vismay5559/stm32_zeuss/README.md

# nexus — STM32H7S3L8 real-time controller for a biped robot

Firmware for the low-level control board of a bipedal robot. The STM32 owns
everything that must happen on time; a Raspberry Pi handles planning and
perception and talks to this board over USB.

```
Raspberry Pi                      STM32H7S3L8 (this repo)
────────────                      ───────────────────────
Linux, ROS, planning,      ←→     exact 1 kHz control loop
vision, logging                   IMU, encoders, CAN-FD, contacts
(soft real-time)                  (hard real-time)

      one 422-byte struct every 1 ms — see Appli/App/link_proto.h
```

**Start here:** [What the Pi receives](#what-the-pi-receives) is the contract
between this board and the policy. [Test modes](#test-modes) is how to bring one
subsystem up at a time.

---

## Hardware

| Item | Detail |
|---|---|
| MCU | STM32H7S3L8Hx, Cortex-M7 @ 600 MHz, TFBGA225 |
| Board | NUCLEO-H7S3L8 |
| External flash | Macronix MX25UW25645G, 256 Mbit octal, on XSPI2 |
| IMU | BNO085, SHTP over **UART2** (PD5/PD6) @ 3 Mbaud, 400 Hz |
| Encoders | 4 × AS5047P on SPI1 @ 6.25 MHz, 1 kHz: one shared bus, **one chip select per sensor** |
| Actuators | **10 × ODrive S1 — 5 per bus** on 2 × FDCAN (two legs, no waist; node 5 is ankle roll — see the joint map) |
| Contacts | 2 × mechanical foot switches (one per foot, sole centre) |
| Host link | USB High Speed (480 Mbit), CDC |

### Spring encoder wiring

**Pin-by-pin wiring, with header positions, is in [docs/PINOUT.md](docs/PINOUT.md).**
Summary: four AS5047P share SPI1 (PB3 SCK, PD7 MOSI, PB4 MISO) with one chip
select each — PF1 left hip, PD15 left knee, PD14 right hip, PF5 right knee.

This replaced two daisy chains of two. In a chain the sensors form one shift
register, so the ORDER of the returned words carried meaning — the first word
came from whichever sensor sat nearest MISO. Wiring hip and knee the other way
round swapped two springs in the data, silently, and the only way to catch it
was to press a spring by hand and watch which number moved. With one select per
sensor a reply can only have come from the sensor that was selected.

If a spring is now reported as another one, a CS wire is on the wrong pin.
`s_cs[]` in `enc_as5047p.c` is the one place to change.

| `spring_angle[i]` | 0 | 1 | 2 | 3 |
|---|---|---|---|---|
| spring | left hip pitch | left knee pitch | right hip pitch | right knee pitch |

The index is fixed by which pin a sensor's CS is on, not by the order of
anything on the wire.

### Verified clock tree

HSE 24 MHz → PLL1 (M2 N100 P2) → **600 MHz** CPU, 300 MHz AHB, 150 MHz APB.

| Function | Source | Result |
|---|---|---|
| Control tick (TIM6) | 300 MHz / 300 / 1000 | 1.0000 kHz |
| Timestamp (TIM2) | 300 MHz / 300, 32-bit | 1 MHz, wraps @ 71.6 min |
| FDCAN | PLL2P = 80 MHz | 1 Mbit nominal / 2.5 Mbit data |
| SPI1 | PLL1Q = 100 MHz / 16 | 6.25 MHz, mode 1 |
| USART2 (IMU) | PCLK1 150 MHz, OVER8 | 3.000 Mbaud, 0% error |
| XSPI2 | PLL2S = 400 MHz | see *Known issues* |

---

## How it boots

The MCU has only **64 KB of internal flash** and the application is ~75 KB, so
this is a two-binary execute-in-place (XIP) design:

```
power on
   │
   ▼
Boot  (internal flash, 0x08000000)
   configures MPU, clocks, XSPI2; maps the external flash
   │  jumps to
   ▼
Appli (external flash, 0x70000000)
   the robot firmware, executed in place
```

Both are built from one CubeMX project (`nexus_first.ioc`) with separate
contexts. **They must be flashed separately** — see below.

---

## Layout

```
Appli/App/            ← the actual robot code
   app.c                1 kHz control loop, health LEDs
   health.c/.h          subsystem health + red-LED blink codes
   imu_bno085.c         BNO085 SHTP-over-UART driver
   enc_as5047p.c        AS5047P SPI encoder driver
   act_odrive.c         ODrive CANSimple, software TX queue
   contact.c            foot switch debouncing
   link_usb.c           framing/CRC for the Pi link
   link_proto.h         wire format — keep byte-identical with the Pi
   critical.h           ISR-safe copy helper

   lie_group.c/.h       SE_K(3) Lie group maths (fixed size)
   zeus_kinematics.c/.h contact-point FK + exact Jacobian from the URDF (model: GENERATED -
                        see tools/gen_kinematics.py)
   inekf.c/.h           contact-aided right-invariant EKF
   fusion.c/.h          bridges sensors <-> filter; fills the policy block
   gait_ref.c/.h        reference trajectory (GENERATED - see tools/gen_gait.py)

   safety.c/.h          arm/idle/fault state machine - the failsafe
   watchdog.c/.h        IWDG; resets the board if a tick never completes
   robot_config.c/.h    per-robot measured values (spring rates, sensor zeros)

   test_leg_can.c       NEXUS_MODE_LEG_CAN
   test_leg_torque.c    NEXUS_MODE_LEG_TORQUE
   test_imu.c           NEXUS_MODE_IMU

   README.md            plain-language guide to this folder - start here if
                        you do not program. Explains tick, interrupt, DMA,
                        checksum, arming, and the order things run in.

pi/                              the Raspberry Pi side, drop into zeus_26
   nexus_proto.py         wire format - must match link_proto.h byte for byte
   nexus_link.py          threaded 1 kHz reader
   zeus_viz.py            live Rerun view - plots, 3D, sim comparison

tools/
   hosttest/run.sh        builds and runs the host tests (see Testing below)
   check_proto.py         proves the C and Python layouts agree
   test_pi_link.py        proves the Pi side sustains 1 kHz, no hardware needed
   gen_gait.py            spreadsheet -> gait_ref.c
   plot_run.py            PuTTY log -> tracking plot + gain-tuning metrics

runs/                            archived captures, one CSV per gain setting
                                 (generated - `plot_run.py -l NAME`)

Appli/Core/, Appli/USB_DEVICE/   CubeMX-generated (edit only in USER CODE blocks)
Boot/                            bootloader project, also CubeMX-generated
Drivers/, Middlewares/           ST HAL + USB + external-memory manager (vendored)
sync_from_cubemx.sh              pull generated files back from the CubeMX folder
```

`Appli/Core/Src/main.c` only switches peripherals on and calls `app_init()` /
`app_run()`. All real work lives in `Appli/App/`.

**Adding a source file:** create it in `Appli/App/`, then add it to
`target_sources` in `Appli/CMakeLists.txt`.

---

## Building

Requires STM32CubeCLT, or STM32CubeIDE, which bundles the same tools
(`arm-none-eabi-gcc`, CMake, Ninja, STM32CubeProgrammer). On Linux with
CubeIDE they are not on `PATH`; this finds them whatever the versions:

```bash
for d in /opt/st/stm32cubeide_*/plugins/com.st.stm32cube.ide.mcu.externaltools.{gnu-tools-for-stm32,ninja,cmake,cubeprogrammer}.*/tools/bin; do PATH="$d:$PATH"; done; export PATH
```

### Choosing the mode

The mode is the `#define NEXUS_MODE` line in `Appli/App/nexus_mode.h` unless
you override it. **Look at that line before building.** Test modes are
bring-up binaries, and `NEXUS_MODE_LEG_CAN` with `LEGTEST_ENABLE_CLOSED_LOOP 1`
arms the leg's motors at boot.

**The everyday way: edit that line and rebuild.** No clean is needed -
changing the header rebuilds the Appli in the new mode:

```bash
cmake --preset Release          # once, on a fresh clone
cmake --build --preset Release  # after every edit
```

To pick the mode without editing the header instead, on a clean tree, with the
variable **exported** so both steps see it:

```bash
rm -rf build Appli/build Boot/build
export NEXUS_MODE=NEXUS_MODE_ROBOT          # or NEXUS_MODE_LEG_CAN, _IMU, _LEG_TORQUE
cmake --preset Release
cmake --build --preset Release
unset NEXUS_MODE
```

All of that is needed, and each part was found by getting it wrong:

- **Export it, do not prefix one command.** The top level builds Appli as an
  `ExternalProject`, which configures during `cmake --build`, not during
  `cmake --preset`. `NEXUS_MODE=... cmake --preset Release` sets the variable
  for a step that never reads it; the build then prints
  `Nexus mode: from Appli/App/nexus_mode.h` and uses the header.
- **Clean first.** The mode is cached in `Appli/build`, so a changed variable
  is ignored by an already-configured tree. And deleting `Appli/build` alone
  fails: the step stamps under `build/` still say Appli is configured, and the
  build tries to `cd` into the missing directory.

**Do not mix the two.** A build run with `NEXUS_MODE` in the environment
caches it in `Appli/build`, and from then on it silently overrides the header -
edits to `nexus_mode.h` do nothing until `build`, `Appli/build` and
`Boot/build` are removed.

The build prints the mode (`Nexus mode: NEXUS_MODE_ROBOT (overrides
nexus_mode.h)`). Confirm what you are about to flash:

```bash
strings Appli/build/nexus_first_Appli.elf | grep -m1 -E "APPLI: mode = |entering app_init"
#   entering app_init()     -> ROBOT
#   APPLI: mode = LEG_CAN   -> the leg test
```

`--preset Debug` is for bring-up. **Flight firmware is `--preset Release`** —
this loop has a 1 ms budget and the estimator's predict step alone is two 27x27
matrix products, so an unoptimised build is not a slower robot, it is a
different one.

Outputs, per context:

```
Boot/build/nexus_first_Boot.elf    +  .hex
Appli/build/nexus_first_Appli.elf  +  .hex
```

If the build complains about `cube-cmake` not being found, the CMake cache is
stale (it was created by CubeIDE). Wipe and reconfigure:

```bash
rm -rf build Appli/build Boot/build
cmake --preset Debug && cmake --build build/Debug
```

---

## Testing

Much of `Appli/App` is ordinary logic - bit maps, debouncing, command
validation, the Lie-group maths - and none of it needs a board. Those parts
build and run on a workstation in about a second:

```bash
tools/hosttest/run.sh
```

It exits non-zero if anything fails, so it works as a pre-commit check. What it
covers today:

| Suite | What it pins down |
| --- | --- |
| `test_contact` | switch debouncing, and that each switch owns the right bit |
| `test_safety` | the arm/idle/fault transitions and every command-rejection rule |
| `test_fusion` | the sensor-to-filter bridge: springs add to their drives, an unreadable spring is not believed, one leg's drives never move the other leg's foot, each foot switch is its own contact |
| `test_robot_config` | spring deflection, sensor-zero wrap-around, calibration flag |
| `test_watchdog` | start, refresh, and the stopped-clock case |
| `test_lie_group` | rotations stay rotations, and the Gamma coefficients against a double-precision reference |
| `test_zeus_kinematics` | contact-point positions and Jacobians from the URDF model, against Pinocchio in double precision |
| `test_health` | fault thresholds, which subsystem is blamed, latching, and the blink code |
| `test_gait_ref` | phase wrap, interpolation, the seam, and the two documented table steps |
| `test_inekf` | still, free fall, a known spin, contact correction, a refused time step, and the fast covariance update against a dense reference |
| `test_link_usb` | frame reassembly across any split, checksum rejection, and the busy-cable drop |
| `test_act_odrive` | the interpolated ramp, the speed-hint clamp, arm and stop, a blocked wire, and where a reply is filed |
| `test_enc_as5047p` | left chain then right chain in the right slots, the check digit over every bit position, a sensor's error flag and clearing its error register, and a read that never comes back |
| `check_proto.py` | that `link_proto.h` and `nexus_proto.py` agree byte for byte |

The App sources are built against a stub HAL in `tools/hosttest/stub/`, so a
change can pass every one of these and still fail to compile for the board.
That is what the firmware build in CI is for.

`CC` selects the compiler, and it is worth using:

```bash
CC=gcc   tools/hosttest/run.sh
CC=clang tools/hosttest/run.sh
```

They disagree. GCC rejects a packed-member access that clang accepts silently,
and on macOS `gcc` is Apple clang under another name - so a green local run
there says less than it appears to. CI runs both.

On a Mac, real GCC is one command away and is worth using before pushing:

```bash
docker run --rm -v "$PWD":/w -w /w -e CC=gcc gcc:14 tools/hosttest/run.sh
```

It has caught things a local run could not - a `?:` whose branches are `unsigned
int`, narrowed to a `uint8_t` on return, which GCC rejects and clang does not
mention.

Not covered yet: `imu_bno085`, which needs a stub for its UART, and `app`,
whose loop body sits inside a `for (;;)` and cannot be run one pass at a time
without restructuring it - a bigger change than a test should make on its own.

The other peripherals are stubbed in `tools/hosttest/stub/`: the HAL, USB, CAN
and SPI.

Note the host build adds `-Wconversion`, which the firmware build does not, so
a file compiled here is held to a slightly stricter standard than one that only
ever goes to the board.

`SAN=1` builds and runs the same tests with the address and undefined-behaviour
checkers:

```bash
SAN=1 CC=clang tools/hosttest/run.sh
```

Warnings catch what the compiler can see standing still; these catch what only
happens when the code runs - an index that walks off the end of a table, a
signed overflow. Compiled code on the board has neither check, so a mistake of
that kind is silent there until it corrupts the variable next door. This is how
the unbounded wire index in `act_on_rx()` was found: every test passed, and the
write past the end of `s_pos_age` was invisible until something was watching
for it.

**When a test fails, work out which of the two is wrong before changing
either.** Several of these suites failed on their first run and the code turned
out to be right - a mask that was `0xFF` where the code wanted `0x0F`, a
tolerance coarser than the effect it was meant to catch, an assertion that the
documentation was right when it was not. A test bent until it passes is worse
than no test.

**Check a mutation actually built.** Breaking a line often leaves a variable
unused, which fails under `-Werror`; a harness that counts only failed
assertions reads that as "the mutation survived".

---

## Kinematics from the URDF

The estimator needs each foot's contact point relative to the IMU, and
its Jacobian. Rather than measuring lengths by hand, the geometry comes from
the CAD:

```
Fusion 360 export ─► zeus_26_mukesh_deploy/mukesh_description/scripts/clean_urdf.py ─► mukesh.urdf
mukesh.urdf ─► tools/gen_kinematics.py ─► Appli/App/zeus_kinematics_model.h      (tables, committed)
                                       └► tools/hosttest/zeus_kinematics_ref.h   (Pinocchio's answers)
```

`zeus_kinematics.c` walks those tables on the board: forward kinematics and
the exact Jacobian for both points of a leg in a few hundred float operations,
~2 KB of flash. Nothing from Python runs on the robot. `fusion.c` calls it every
tick for both legs; how well the result estimates the robot's motion is
checked against a simulated walk (see *State estimation*).

After the model changes (new export, IMU moved, contact points moved):

```bash
python3 -m venv ~/kinvenv && ~/kinvenv/bin/pip install -r tools/requirements-kinematics.txt   # once
env -u PYTHONPATH ~/kinvenv/bin/python tools/gen_kinematics.py      # reads ../zeus_26_mukesh_deploy/.../mukesh.urdf
tools/hosttest/run.sh                                                # C against Pinocchio
```

`env -u PYTHONPATH` matters when ROS is sourced: ROS's eigenpy breaks
Pinocchio's. `--check` exits 1 if the committed files are stale;
`--urdf path` reads another model. The firmware logs which model it has as
`zeus_kin_model_sha`, the first 16 hex digits of the URDF's sha256.

Per leg, `q` is **seven** numbers for **five** driven joints: hip pitch, hip
roll, knee pitch, ankle pitch, ankle roll (all motor side), then the hip and
knee **spring deflections**. The two extra entries are not extra actuators -
hip pitch and knee pitch are series-elastic, so the drive measures one side of
the spring and an AS5047P measures how far the spring has wound up, and the
foot's position depends on both. There are no waist joints: both hips bolt
straight to the torso.

Everything is named (`ZEUS_KIN_Q_*`), so a re-export that nests the joints
differently changes the tables, not the API.

## Continuous integration

`.github/workflows/ci.yml` runs on every push to `main` and every pull request.
Three jobs, answering three different questions:

| Job | Question | What it does |
| --- | --- | --- |
| `host-tests` | Is the logic right? | `tools/hosttest/run.sh` under GCC and clang |
| `sanitizers` | Is it doing anything it should not? | the same tests with the address and undefined-behaviour checkers |
| `firmware` | Does it still build? | cross-compiles Boot and Appli, Debug and Release |

The firmware job is the one more host tests cannot replace, and it earned its
place immediately: its first run found `act_odrive.c` reading `TxErrorCnt` off
`FDCAN_ProtocolStatusTypeDef`, which has no such member. The code had been
merged without ever being compiled for the target, and the next person to try
to flash a robot would have found it instead.

Image sizes are printed to the log, so a change that quietly costs flash is
visible before a board stops fitting. The `.elf` and the `.hex` are uploaded as
artifacts on every run - **flash the `.hex`**, for the reason given under
Flashing below.

The ARM toolchain action is pinned to a commit rather than a moving tag.

---

## Flashing

Two separate commands. **The Appli needs an external loader**; the Boot does not.

```bash
# the external loader - Linux with CubeIDE
ST_LOADER=$(ls /opt/st/stm32cubeide_*/plugins/*cubeprogrammer*/tools/bin/ExternalLoader/MX25UW25645G_NUCLEO-H7S3L8.stldr)
# Windows with CubeCLT:
#   C:/ST/STM32CubeCLT_1.22.0/STM32CubeProgrammer/bin/ExternalLoader/MX25UW25645G_NUCLEO-H7S3L8.stldr

# Appli -> external flash at 0x70000000
STM32_Programmer_CLI -c port=SWD mode=UR -el "$ST_LOADER" \
  -d Appli/build/nexus_first_Appli.hex -v -rst

# Boot -> internal flash at 0x08000000
STM32_Programmer_CLI -c port=SWD mode=UR -d Boot/build/nexus_first_Boot.elf -v -rst
```

The serial console is the ST-LINK's virtual COM port, 115200 8N1 -
`/dev/ttyACM0` on Linux when it is the only one:

```bash
python3 -m serial.tools.miniterm /dev/ttyACM0 115200      # ctrl-] to quit
```

Notes:

- **Flash the Appli `.hex`, not the `.elf`.** The ELF carries two LOAD segments
  that hold no data (`0x20000000` heap/stack in DTCM, `0x24070000` non-cacheable
  buffers). STM32CubeProgrammer tries to erase at every segment address, the
  external loader only knows how to drive flash at `0x70000000`, and the whole
  download aborts with `Error: failed to download Sector[0]`. The `.hex` records
  only sections that contain data, so it programs cleanly. The Boot is internal
  flash with no external loader attached, so its ELF is fine.
- Use the loader **without** the `-XSPIM1` suffix; this board wires the flash
  to XSPI port 2.
- `mode=UR` (connect under reset) is important for an XIP project — running
  firmware can otherwise block the connection.
- Only reflash Boot when Boot changes. Day-to-day you reflash the Appli only.

---

## Test modes

The full robot loop touches every peripheral at once, which is the worst way
to bring hardware up — when nothing works you cannot tell which of six
subsystems is at fault. So the firmware has single-purpose modes, selected at
build time in `Appli/App/nexus_mode.h`:

```c
#define NEXUS_MODE  NEXUS_MODE_LEG_CAN
```

| Mode | Exercises | State |
|---|---|---|
| `NEXUS_MODE_ROBOT` | Everything — the real 1 kHz loop | builds, untested on hardware |
| `NEXUS_MODE_LEG_CAN` | **CAN-FD only.** One leg, 4 ODrives, reference gait | builds, no ODrives attached yet |
| `NEXUS_MODE_IMU` | **IMU only.** BNO085 over UART | ✅ **working on hardware** |

Change it, rebuild, reflash the Appli. `main()` dispatches on it; unused code
is simply never entered.

### `NEXUS_MODE_LEG_CAN` — single leg over CAN-FD

Talks to four ODrive S1 axes on **FDCAN1** (PB8 rx / PD1 tx) and touches
nothing else. Per joint: 1 TX (`Set_Input_Pos`) and 2 RX
(`Get_Encoder_Estimates`, `Get_Torques`), plus the ODrive heartbeat.

Configuration lives at the top of `Appli/App/test_leg_can.c`:

| Setting | Default | Notes |
|---|---|---|
| `s_node_id[]` | `{1,3,4}` | hip_pitch, knee, ankle. Must match `axis0.config.can.node_id` — see [the joint map](#the-joint-map) |
| `LEGTEST_ENABLE_CLOSED_LOOP` | **0** | **Safety.** At 0 the axes are never commanded into closed loop, so motors stay unpowered and cannot move — positions are still transmitted, so TX is fully testable |
| `LEGTEST_MOTION_GAIT` | 1 | 1 = play the reference gait, 0 = single-joint sine |
| `LEGTEST_GAIT_SPEED` | **0.25** | Fraction of real time. Start low |
| `LEGTEST_GAIT_ENTRY_MS` | 2000 | Ramp from the measured pose into the trajectory |
| `LEGTEST_USE_CAN_FD` | **0** | Classic CAN 2.0 @ 1 Mbit. Measured: this S1 sends CLASSIC frames and will not acknowledge FD ones |
| `LEGTEST_LISTEN_ONLY` | 0 | Never transmit. Use to verify reception without risking bus-off |
| `LEGTEST_USB_STREAM` | 1 | Send the run to the Pi over the USB user port at 1 kHz, as the robot's state packet. Send-only. See [Testing the USB link to the Pi](#testing-the-usb-link-to-the-pi) |
| `LEGTEST_STOP_BUTTON` | 1 | Blue USER button commands IDLE and latches. **Not an e-stop** — it rides the same CAN bus |
| `LEGTEST_GAIT_CYCLES` | 1 | Play this many cycles then hold. 0 loops forever |
| `LEGTEST_VEL_POKE` | 0 | Command a constant velocity instead of positions, to test whether the drive can produce torque at all |
| `s_zero_offset[]` | 0 | Where the gait's zero sits in the drive's coordinates. The arming log computes it for you |
| `LEGTEST_TRACE_RX` | 1 | Decode every received frame onto the console |
| `LEGTEST_TX_DIV` | 1 | 1 = 1 kHz per joint, 4 = 250 Hz per joint |

### Joints that are not on the bus

`bus_scan()` records which configured nodes answered, and a joint that did not
is skipped everywhere: no setpoints transmitted, never armed, never disarmed,
excluded from the limit check, and left out of both the run summary and the CSV
columns. Only a **completely** silent bus disables closed loop.

```
  !! node 4 (ankle) never answered - that joint is SKIPPED
     (not armed, not commanded, not captured). The rest of
     the leg still runs.
```

This is the single most bug-prone thing in the file, because a joint's presence
is assumed in seven separate places. Missing one does not produce an error —
it produces a leg that arms, holds position perfectly and never moves:

```
node 1 hip_pitch : pos= +3.5485 state=8 err=0x00000000  cmd=+3.5485 err=+0.0000
```

That was `s_entry_ok` being cleared because the absent ankle had
`n_encoder == 0`, which routes every tick into the hold-pose branch
(`target[j] = s_joint[j].pos` — command the joint to where it already is).

**A joint following a trajectory never has zero tracking error.** Sustained
`err=+0.0000` means the setpoint is the measurement, and something upstream has
decided not to run. When adding a joint, grep every `for (int j = 0; j <
JOINT_COUNT` loop and decide explicitly whether it needs `s_joint_live[j]`.

### The reference gait

`Appli/App/gait_ref.c` is **generated, not hand-written**:

```bash
python tools/gen_gait.py reference_gait_rleg_40ms_250hz.xlsx

# a workbook with one sheet per speed needs the sheet named
python tools/gen_gait_sheet_select.py final_humangait.xlsx --sheet 0.4
```

`final_humangait.xlsx` holds **two steps over 1.26 s** at three speeds, one per
sheet - `0.3`, `0.4`, `0.5` m/s - and names its columns through the shared
string table rather than inline, which the original reader could not decode.
`gen_gait_sheet_select.py` parses the workbook relationships to map sheet names
to XML parts, lists what it found, and takes `--sheet`. Run it with no `--sheet`
to see the available names.

Two steps per table rather than one stride is worth noticing: `phase` 0..1 now
covers **two** steps, so `gait_sample(phase + 0.5)` is the same leg one step
later - which is exactly what the contralateral leg needs in `build_reference()`.

200 samples, 0.8 s cycle, from a Pinocchio + CasADi trajectory optimisation at
0.40 m/s. Re-run the generator when the trajectory changes — hand-editing 200
rows of floats is how a sign error gets in and stays in.

Two conversions happen in the generator, and both are worth knowing:

- **Degrees → turns is just `/360`.** The spreadsheet is joint angles on the
  output shaft; each ODrive is already configured with its own gear ratio, so no
  reduction factor belongs in the firmware.
- **Columns come out in a fixed order that is not the node order.** The
  table runs hip_roll, hip_pitch, knee, ankle, while node 1 is hip_pitch.
  Nothing depends on the two matching: every consumer picks a column by name
  (`GAIT_COL_*`) and decides which joint it drives. The generator prints the
  resulting turn ranges so a mix-up is visible before anything moves:

```
  slot        column           degrees            turns
  hip_roll    hipRoll_r_deg    -1.67..  +6.86   -0.0047..+0.0191
  hip_pitch   hipP_r_deg      -20.53..  -6.71   -0.0570..-0.0186
  knee        knee_r_deg      +25.53.. +30.23   +0.0709..+0.0840
  ankle       ankle_r_deg      +6.03.. +21.41   +0.0167..+0.0595
```

`gait_sample(phase, out)` interpolates linearly between the 250 Hz samples and
wraps at 1.0, so the 1 kHz loop gets a smooth ramp rather than a staircase.

#### KNOWN DEFECT — the spreadsheet is not continuous

`reference_gait_rleg_40ms_250hz.xlsx` contains **two step discontinuities**, at
rows 99→100 (phase 0.5) and 199→0 (phase 1.0). Every joint jumps about 2° in a
single 4 ms sample while every other step in the trajectory is under 0.15°:

| column | median step | row 99→100 | row 199→0 |
|---|---|---|---|
| hipP_r_deg | 0.134° | **−2.013°** | **+1.961°** |
| hipRoll_r_deg | 0.059° | **+1.798°** | **+1.808°** |
| knee_r_deg | 0.034° | **+1.658°** | **−1.969°** |
| ankle_r_deg | 0.142° | −0.781° | **−1.510°** |

The two halves are not duplicates of one another (they differ by up to 13.8°),
so this is two separate 0.4 s optimiser solutions concatenated without a
periodicity constraint at either join. It is a defect in the source data, not in
the generator or the firmware.

Interpolation does **not** rescue it. It makes position continuous and leaves
velocity discontinuous: the 2° is still delivered inside one row-time, so during
those 16 ms at 0.25× the drive is commanded to move at 0.35 turn/s when the real
gait never exceeds **0.029 turn/s**. Twelve times the peak velocity of the
actual motion, twice per cycle, on every joint at once.

Consequences worth knowing before you read any tracking plot:

- Tracking error has a floor of roughly 2° at those two phases that no gain
  setting can remove. Do not tune against it.
- Velocity feedforward faithfully amplifies it — it feeds forward a velocity
  that exists only because the data is broken, as a kick at a direction
  reversal.
- Any peak-velocity figure computed by differentiating this table is dominated
  by the two joins rather than by the gait.

The real fix is upstream: re-run the optimisation with `q(T) = q(0)` and a
continuous half-step join. Blending the joins in `tools/gen_gait.py` would make
the bench test a clean test signal, but the firmware would then no longer be
playing what the optimiser produced — acceptable for actuator bring-up, not
something to carry into the robot silently.

**Two safety behaviours that are not optional:**

- The leg **ramps from its measured position** into gait sample 0 over
  `LEGTEST_GAIT_ENTRY_MS`, because the first command after arming would
  otherwise be a jump from wherever the leg is resting to phase 0.
- If **any** joint has not reported an encoder estimate over CAN, the gait does
  **not start** — the leg holds station and says so on the console. Ramping from
  an assumed zero would command a jump exactly as large as the assumption is
  wrong.

Start at `LEGTEST_GAIT_SPEED 0.25`. A wrong sign or node mapping then shows as
a slow drift you can watch and kill, rather than a snap you only hear.

Commands go out at **1 kHz to every joint** (`LEGTEST_TX_DIV 1`). Because the
hardware TX FIFO is fixed at three entries and a tick hands over four frames,
they pass through a software queue that `tx_pump()` drains as space frees.
Set `LEGTEST_TX_DIV` to 4 for one joint per tick (250 Hz each) if you want to
halve bus load during early bring-up.

When the queue is full it discards the **oldest** entry. These are position
setpoints: a stale setpoint is worthless, the newest is exactly what the
actuator should receive, and dropping the newest instead would leave the queue
full of seconds-old commands that would replay when the bus recovered.

### The run, as a sequence of phases

`LEGTEST_GAIT_RELATIVE` is **0**. A table value *is* the joint angle, measured
from the zero the drives already hold — no re-centring on whatever pose the leg
was left in, so the gait means the same thing on every run and a capture from
today is comparable with one from last week.

That only works if every run starts from the same place, so it does:

```
WAIT_ARM      countdown; nothing is commanded, axes arm when they report healthy
    |
GOTO_ZERO     3 s ramp from wherever the leg powered up, to absolute zero
    |
ENTRY         2 s ramp from zero to the trajectory's first sample
    |
GAIT          the trajectory
    |
SETTLE        1 s holding the last pose, still armed
    |
RETURN_ZERO   2 s ramp back to absolute zero
    |
DONE          disarmed
```

Every phase is a straight line in **time** between two known poses. `phase_enter()`
records the tick it began on and the pose each joint began from, once, and
`ramp_to()` interpolates from there.

None of them recompute the setpoint from the live encoder, and that is the
subtlest thing in the file. A setpoint that follows the measurement can never
build an error larger than one tick's step — and error is what a position loop
turns into torque, so the drive would trail the leg around rather than drive it,
and would track a droop under gravity straight down instead of resisting it.
Capturing the starting pose *once* also means a joint that lags does not drag
the whole ramp out behind it.

`GOTO_ZERO` gets the longest ramp because it is the only move whose distance is
not known in advance. Everything after it starts from a defined pose.

### Where zero comes from, and why it differs per joint

**Hip and knee read load-side absolute encoders and hold their own reference
frame.** Every ODrive position command is interpreted against `pos_estimate`,
which is the encoder angle plus a stored offset — `pos_vel_mapper.config.offset`
with `offset_valid`, written by `set_abs_pos()` and persisted by
`save_configuration()`. The drive applies it at power-up, so `pos_estimate` is
already correct before the firmware says anything, with no homing.

**So the firmware must not send `Set_Absolute_Position` to those two.** That
command redefines zero as wherever the leg is standing, which would silently
replace a calibrated reference with an arbitrary one. `s_define_zero` is
`{ 0, 0, 1 }`. The firmware **drives to** zero instead of declaring it — the
opposite operation, and the right one once the drive holds a real frame.

**The ankle is the exception.** Its encoder is on the motor side of a 9:1, so
±35° of joint travel is 1.75 turns of encoder and a single-turn absolute reading
maps to several possible angles. No saved offset can disambiguate that, so it
still gets `0x19` at boot — which means **the ankle must be placed by hand
before power-up, every time.** Declaring zero is not finding it: the readback
only proves the drive accepted the command, not that the joint was anywhere near
where you meant. `docs/ZEROING.md` has the full argument.

### Three guards, failing differently on purpose

A geared joint legitimately reads **different encoders for position and
commutation** — `load=5` (`SPI_ENCODER0`) and `commutation=13`
(`ONBOARD_ENCODER0`) on hip and knee. Commutation needs the electrical angle,
which only a motor-side encoder can resolve; position wants the load side,
because that is where the joint actually is. `s_cmd_scale` has to agree with the
**load** encoder, since that is what `pos_estimate` reports.

| guard | when | catches |
|---|---|---|
| `limits_ok()` | before arming | a trajectory that was never going to fit |
| command check | every tick | a setpoint outside the range, before it is sent |
| measurement check | every tick | a joint that overshot its way past the limit |

```
!! HARD LIMIT: knee position +30.412 deg exceeds +/-30.0 deg - DISARM
```

The command check alone would miss a joint that reaches a mechanical stop while
being told to do something perfectly legal. The measurement check alone would
miss a bad setpoint that has not moved the joint yet. Whichever fires says which
it was.

`s_limit_deg[]` is `{ 30, 35, 35 }` degrees, and the knee's 35 is deliberate.

**A walking knee only ever flexes.** This trajectory runs +16.34° to +28.85° and
never goes negative at all, so a symmetric ±30° spends its whole negative half
on travel the joint never uses and leaves **1.15°** on the side that matters —
less than the 3° of headroom `limits_ok()` requires, so the run is refused
before it arms:

```
!! knee: gait clears its stop by only 1.1 deg, want 3.0.
!! trajectory does not fit the joint limits - NOT MOVING
```

35° is the knee's mechanical travel from `docs/ZEROING.md` and gives 6.15° of
real margin. If 30 is a genuine hard stop on your machine rather than a round
number, put it back and reduce the trajectory amplitude instead — do not lower
`LEGTEST_LIMIT_MARGIN_DEG` to squeeze under it, which removes the warning
without removing the interference.

### The generated table is repaired, not raw

The source trajectory is **two half-strides concatenated, and they do not
meet**. Every joint jumps at once at `t = cycle/2`, sample 99 -> 100, by 1.7 to
2.0 degrees where the neighbouring steps are 0.03. There is a second, smaller
join at the wrap, 199 -> 0.

`gen_gait.py` closes both, with different methods because they are different
problems:

- **Interior joins** are found by looking at every joint at once: two or more
  stepping together at the same index means a stitch. Judging each joint alone
  gets this wrong - the ankle's jump is only 5.5x its own median step and reads
  as ordinary motion, while the knee's is 49x. Each side is then pulled halfway
  to the other, tapered to nothing over 20 samples with a smoothstep so velocity
  stays continuous at the window edges.
- **The wrap** is a constant offset over a whole cycle, so it is spread as a
  tiny slope across the entire path rather than concentrated in a few samples.

Worst step on any joint is now **3% of its span, from 44%**.

The check reports every step over 5% of each joint's own travel. It used to
compare against a fixed 0.01 turns - 3.6 degrees, most of the knee's entire
range - so a step could be nearly half that joint's motion and pass silently,
which is exactly what happened.

#### Why it mattered

The knee's whole travel is 3.7 degrees and the step was 1.65 of them - **44% of
the gait arriving in one 4 ms sample**, 412 deg/s at the output. No gain
follows that. Its captures read 230% tracking while the joint was simply ringing
after each kick, and it was untunable until the table was fixed.

<details>
<summary>The original numbers, for reference</summary>

The hip column has step changes at samples **99 -> 100** and **199 -> 0** that
are 15x to 250x the neighbouring step, at points where the joint is at an
extremum and should be nearly stationary:

```
sample  hip_turns   step      step x47 (drive turns)
   98  -0.01868  -0.00002   -0.0010
   99  -0.01870  -0.00559   -0.2628   <== STEP
  100  -0.02429  -0.00013   -0.0063
  ...
  199  -0.05703  +0.00545   +0.2560   <== STEP
    0  -0.05158  -0.00005   -0.0022
```

Both are ~0.0055 output turns (~2 deg). On the knee and ankle that is a small
bump. On the hip, whose commands are multiplied by 47 because its encoder is on
the motor side, it becomes a **0.26 turn instantaneous setpoint step** — a jerk
no drive can follow. It is reliably the largest tracking error in every capture:

```
1.580,4.65053,4.61714,0.03340
1.590,4.55174,4.56022,-0.00847   <- cmd steps -0.099
1.600,4.38751,4.47710,-0.08959   <- cmd steps -0.164, worst error of the run
```

Sample 100 is phase 0.5 and sample 200 is the seam, so a gait that looks like
two half-cycles stitched together with a small mismatch at each junction is
exactly what this pattern means.

</details>

**Regenerating used to delete code from the file it generates.** `row_vel()` and
the NULL guards in `gait_sample_vel()` had been hand-added to `gait_ref.c` and
were not in the generator's template, so a regeneration silently downgraded the
velocity feedforward from a centred difference to a one-sided one and made the
host tests segfault on the first NULL call. Both live in the template now, along
with the per-function documentation. **Do not hand-edit `gait_ref.c` or
`gait_ref.h`** - anything added there is lost the next time the generator runs.

### If the bus goes quiet

CAN is acknowledged: **every** transmitter needs at least one other node to pull
the ACK slot low. A node whose frames are not acknowledged retries forever, its
transmit error counter climbs, and at 255 the controller takes itself
**bus-off** — which stops *reception* as well. A perfectly good receive path can
therefore look completely dead a second after boot.

The report prints the state that explains it:

```
can: TEC=248 REC=0 txfifo_free=0  [BUS-OFF]
last error: ACK - we transmitted and NOBODY answered
```

**Read the two counters as a pair.** `REC=0` with a high `TEC` means their
frames reach us and ours do not reach them — the fault is on our side of the
wire, not the bus.

This is how the FD mismatch was found. Reception was flawless — 8,731 frames —
while `TEC` climbed to 248 and killed the link. The frame trace showed every
incoming frame decoding as `CLASSIC`, so the drive was never going to
acknowledge our FD frames. One `#define` fixed it.

`LEGTEST_LISTEN_ONLY 1` never transmits, so it can never reach bus-off. Use it
when you need to prove reception works for longer than the error counter allows.

### Bus load

**Measured on hardware, one node:**

```
--- t=5s  tx=1000 rx=2247 (unknown=0)  txfail=0 qdrop=0  bus~39% ---
```

That is 1000 commands out plus ~2250 telemetry frames back — **39% of a 1 Mbit
bus for a single actuator.** A classic 8-byte frame is ~108 bits, so ~3250
frames/s fills roughly a third of the wire on its own.

The consequence is worth being blunt about: **five nodes at these rates does not
fit.** Not "tight" — arithmetically impossible, several times over.

| Nodes, unchanged rates | Bus |
|---|---|
| 1 (measured) | 39% |
| 2 | 78% — already past usable |
| 5 (full robot, per bus) | ~195% — impossible |

Past roughly 50% the latency of lower-priority frames degrades badly; past 70%
it is effectively unbounded.

The drive was streaming encoder estimates at ~1120 Hz and torques at the same
rate, which is what dominates. Both are configured on the ODrive, not here:

```
axis0.config.can.encoder_msg_rate_ms   = 1     # 1 kHz - the estimator needs this
axis0.config.can.torque_msg_rate_ms    = 10    # 100 Hz is plenty for logging
axis0.config.can.heartbeat_msg_rate_ms = 100
```

### Why a frame costs what it does

A classic 8-byte frame is **121 bits**, and only 64 of them are payload:

```
SOF 1 · ID 11 · RTR/IDE/r0 3 · DLC 4 · DATA 64 · CRC 15
      · delimiters 3 · EOF 7 · IFS 3 · ~10 stuff bits
```

At 1 Mbit that is **121 µs per frame**, and 3210 frames/s fills 39% of the
second. The measurement and the arithmetic agree exactly.

**CAN FD helps, but by less than the headline ratio.** Only the data field and
CRC use the faster rate; the ID, acknowledgement and end-of-frame always run at
the nominal rate:

```
CLASSIC   |------------ 121 bits at 1 Mbit -------------|   121 us
FD+BRS    |-17 bits-||-- 92 bits at 2.5 Mbit --||-12 b-|     65 us
            1 Mbit           data + CRC          1 Mbit
```

So ~29 us of every FD frame is fixed cost. Going 2 -> 2.5 Mbit saves 9 us of
75; going on to 4 Mbit would save another 13. The data rate is not the biggest
lever available.

Per node at **500 Hz** commands, 1 kHz encoder estimates, 100 Hz heartbeat and
100 Hz torque — **1700 frames/s**:

| Config | us/frame | 1 node | **5 nodes/bus** |
|---|---|---|---|
| Classic 2.0, 1 Mbit | 121 | 21% | **103% — does not fit** |
| FD + BRS, 2 Mbit | 75 | 13% | 64% |
| **FD + BRS, 2.5 Mbit** | **65** | **11%** | **56%** |
| FD + BRS, 4 Mbit | 52 | 9% | 44% |

At 1 kHz commands it was 2200 frames/s a node and **73%** on a five-drive bus.
`ODRV_CMD_DIVIDER` in `act_odrive.h` halved the command rate to the 500 Hz the
policy trained at, which is a bigger saving than any data rate buys — and the
table shows why: even an infinitely fast data phase leaves the ~29 us of
arbitration, which is 33% of the bus at 11000 frames/s.

**Classic cannot carry four drives at these rates**, which is what made genuine
FD mode a prerequisite rather than an optimisation. 2.5 Mbit at 58% leaves
usable margin against the ~50-60% that is comfortable for a bus with
retransmissions.

Encoder estimates stay at 1 kHz: the estimator's prediction step runs on them,
and halving them to buy 14 points of bus load would cost up to 2 ms of
staleness on every joint angle the contact kinematics use. Torque at 100 Hz is
where the saving was taken instead.

The test prints a live `bus~NN%` estimate so you can watch this directly.

On the ODrive side, telemetry must be published cyclically:

```
axis0.config.can.encoder_msg_rate_ms   = 1     # 1 kHz - needed by the estimator
axis0.config.can.torque_msg_rate_ms    = 4     # 250 Hz - see bus load below
axis0.config.can.heartbeat_msg_rate_ms = 100
```

Output, once per second:

```
--- t=12s  rx=4821 (unknown=0)  txfail=0 ---
  node 1 hip_roll  : pos= +0.0031 vel=  +0.002 trq= +0.014 state=1 err=0x00000000  hb=12 enc=120 trq=120  cmd=+0.0000
  node 2 hip_pitch : ---- SILENT ----  (hb=0 enc=0 trq=0)
```

Reading it:

- **`qdrop` climbing fast means nobody is on the bus.** CAN needs another node
  to acknowledge every frame; with no transceiver or no powered ODrive nothing
  ACKs, the three hardware slots never free, and the software queue backs up.
  Watching `tx` go from ~3 to the full rate — and `qdrop` stop climbing — is
  your *first* proof of working wiring, before any telemetry appears.
- `bus~NN%` is the estimated bus load. Keep it under ~50%.
- `rx` climbing and `hb`/`enc`/`trq` rising per node = that node is healthy.
- `unknown` counts frames from node IDs you did not configure — a
  misconfigured ODrive shows up here rather than vanishing.
- `SILENT` = nothing heard from that node for 500 ms.

### Why the data phase runs at 2.5 Mbit

**1 Mbit arbitration / 2.5 Mbit data, FD with BRS, sample point 87.5% on both
phases.** `80 MHz / 32 tq = 2.5 Mbit`.

Three things drove that number.

**Classic CAN does not fit this robot.** Ten drives, five to a bus, at 1 kHz
`Set_Input_Pos` and 1 kHz encoder telemetry is **11000 frames/s per bus**. A
classic 8-byte frame is 120 us on the wire — **132% of the bus**. Even at the
500 Hz command rate the board now uses, 8500 frames/s is 102% and still does
not fit. The earlier single-leg tests fitted only because three joints is a
third of that load.

**5 Mbit failed** and the post-mortem is worth keeping. `TEC=248` climbing to
bus-off with **`REC=0`** — every fault on frames *we* sent, none on frames we
received, which rules out wiring and termination because those corrupt both
directions. At 5 Mbit a bit is 200 ns and the `TdcOffset` had been left at
20 tq = **250 ns**, so the transmitter was checking its own bits *past the end
of the bit entirely*. The TDC offset had never been adjusted when the data rate
changed. (The ISO1042's 152 ns loop delay was suspected first; it is 76% of a
200 ns bit, so it did not help, but the SSP is the simpler explanation.)

**2.5 Mbit is the fastest rate that still samples at 87.5%.** The S1 samples
there, and matching it is what fixed the error counters. The peripheral's
`DataTimeSeg1` tops out at 32 (`IS_FDCAN_DATA_TSEG1`), so:

| data rate | tq | Seg1 / Seg2 | sample point | bit | ISO1042 delay as % of bit |
|---|---|---|---|---|---|
| 2 Mbit | 40 | 32 / 7 | **82.5%** — 87.5% needs Seg1 = 34, over the limit | 500 ns | 30% |
| **2.5 Mbit** | **32** | **27 / 4** | **87.5% exactly** | 400 ns | 38% |
| 4 Mbit | 20 | 16 / 3 | 85% or 90%, cannot express 87.5% | 250 ns | 61% |
| 5 Mbit | 16 | 13 / 2 | 87.5% exactly — but see above | 200 ns | 76% |

So 2 Mbit could never reach the S1's sample point, and 4 Mbit cannot either.
2.5 Mbit is the one rate that is both fast enough and lands exactly.

Current timing at 80 MHz PLL2P, `DataPrescaler = 1`:

| phase | Seg1 | Seg2 | SJW | tq | bitrate | sample point |
|---|---|---|---|---|---|---|
| nominal | 69 | 10 | 10 | 80 | 1 Mbit | 87.5% |
| data | **27** | **4** | **4** | **32** | **2.5 Mbit** | **87.5%** |

`TdcOffset = 28 tq = 350 ns`, which is 87.5% of a 400 ns bit — the SSP at the
same point in the bit as the data sample point. **Change it with the timing;
they are one decision.** Robot mode had it at 8 tq (25%) for a long time while
the leg test used 33, and nothing caught it because robot mode had never run on
a live bus.

Resulting load: **65 us per frame, 8800 frames/s, 58% of the bus.** Note that
~29 us of every FD frame is spent at the nominal rate regardless — arbitration,
ACK, EOF, interframe space — so raising the data rate buys less than it looks.
The cheaper lever is telemetry: encoder estimates at 1 kHz are as much traffic
as every command combined, and halving them takes 58% to 44%.

Set the same rate in **every** ODrive (`odrv0.can.config.data_baud_rate`) and
confirm FD is enabled on each. A drive left at another rate, or in classic
mode, is electrically fine and completely silent — which looks exactly like a
broken wire. The S1s were measured sending classic frames and refusing to ACK
FD ones at one point; that is drive configuration, not a wiring fault.

One related trap: bus-off recovery was a no-op for a long time because
`HAL_FDCAN_Start()` only acts when the peripheral is in READY, and it is
permanently BUSY after the first start. Recovery now clears `CCCR.INIT`
directly.

### Enabling closed loop

`Set_Input_Pos` only sets the **target**. Whether the motor acts on it depends
on the axis *state*, which is separate — an axis in `IDLE` (state 1) accepts
the position and does nothing, motor unpowered. To reach
`CLOSED_LOOP_CONTROL` (state 8):

| Method | How |
|---|---|
| odrivetool — best for first bring-up | `odrv0.axis0.requested_state = AXIS_STATE_CLOSED_LOOP_CONTROL` |
| Over CAN | `Set_Axis_State` (0x007), payload uint32 `8` — what `LEGTEST_ENABLE_CLOSED_LOOP` sends |
| ODrive auto-start | `axis0.config.startup_closed_loop_control = True` |

The `state=` field in the test output shows this live, so you can confirm
before anything moves.

**Bench safety before enabling closed loop:** leg in a fixture and off the
ground, physical e-stop within reach, low current and velocity limits set in
odrivetool, and bring up one node at a time before running all four. Also
enable ODrive's own watchdog (`axis0.config.enable_watchdog`) — that is the
layer that protects the hardware if this firmware stops.

### Feedforward

`Set_Input_Pos` carries three fields, not one: position (float32 turns), then
`Vel_FF` and `Torque_FF` as int16 at 0.001 units. Without them the drive has to
*discover* every motion from tracking error, which means it is always behind by
whatever error it took to generate the torque.

`LEGTEST_GAIT_VEL_FF` is the master switch; `s_vel_ff[]` scales it **per
joint**, and it has to, because the right amount is not the same for all three.
Measured at `GAIT_SPEED 1.0` by running the identical gait with it on and off:

| joint | RMS with FF 1.0 | RMS with FF 0.0 | |
|---|---|---|---|
| hip_pitch | **0.13°** | 1.53° | needs all of it - 12x worse without |
| knee | 0.58° | **0.46°** | slightly better without |
| ankle | 1.88° | **0.26°** | **7x better without** |

The hip lags visibly without it. The ankle *overshoots by 22% and arrives
early* with it - it is being driven past its own setpoint. One global switch
cannot express that, hence the table.

What makes this worth reading twice: the firmware sends all three joints the
**same** thing - trajectory velocity, scaled by `GAIT_SPEED` and `s_cmd_scale`,
multiplied by 1000 because the drive divides by `input_vel_scale`. Same
function, same frame, same tick. So a joint that wants 0.0 while another wants
1.0 points at a difference on the DRIVE side, and `axis0.config.can.input_vel_scale`
is a per-axis setting. Working backwards from the ankle's overshoot, its applied
feedforward looks about double what was intended. **Read that parameter on each
drive before treating `s_vel_ff[2] = 0.0` as a real result** - a joint that
genuinely does not want velocity feedforward is unusual; a drive with a mis-set
scale factor is not.

This also cost four rounds of gain tuning to find. The ankle's error did not
move when `vel_gain` was cut by 70%, because **feedforward bypasses the position
loop entirely** - no gain can touch it. An error that ignores the gains is not a
gain problem, and that is the signal to stop tuning and start measuring.

`gait_sample_vel()` supplies the derivative.
`gait_sample_vel()` computes it as a central difference across neighbouring
table rows — wrapping rather than clamping at the seam — then interpolates, so
the result is continuous rather than the staircase a forward difference of the
interpolated position would give.

Two scalings are mandatory and both are easy to get wrong:

- **Multiply by `LEGTEST_GAIT_SPEED`.** The phase clock runs at that fraction of
  nominal and the velocity must agree with the position it accompanies. Unscaled
  feedforward at 0.25× asks for four times the motion the setpoint is making.
- **Zero it once the cycles are done.** Holding the final pose freezes the
  *phase*, not the table. The trajectory still has a velocity at that phase; the
  command no longer does. Sending the table's value there drives the joint off a
  stationary setpoint for as long as the test is left running.

The int16 fields saturate rather than wrap. A wrapped int16 turns "too fast
forward" into "full speed backward", which is a command to slam the joint the
wrong way at full velocity; clipping merely asks for less than the trajectory
wanted.

`LEGTEST_GAIT_TORQUE_FF` is **0 and the array stays zero**, because the
spreadsheet has no torque column — it is `time_s, hipP, hipRoll, knee, ankle`,
positions only. The parameter is plumbed so that adding real data later is a
value change rather than a protocol change. Two honest sources: re-export joint
torques from `gait_library_v1.npz` (the Pinocchio/CasADi solve necessarily
computed them, they just were not carried into the xlsx), or compute gravity
compensation on the fly from link mass and measured angle. Inventing a torque
trajectory from a position table would be a guess wearing the costume of a
measurement.

**Feedforward authority is scaled by `vel_gain`.** `Vel_FF` is added to the
velocity setpoint, which is then multiplied by `vel_gain` to become torque — so
with a small `vel_gain` the feedforward contributes almost nothing and appears
to do nothing. Tune `vel_gain` first, then judge whether feedforward helped.

### Tuning gains against captured runs

With `LEGTEST_CAPTURE 1` the board records `cmd`, `pos`, `vel` and `trq` for
joint 0 into a 2048-row RAM buffer at `CAPTURE_HZ` (100 Hz, so 20.5 s of
capacity), **only while the gait is running** so the entry ramp is excluded and
`t=0` is the first sample of real gait. Nothing is transmitted during the run.
When the gait completes it dumps the buffer over UART as CSV, once per boot.

Point PuTTY at a log file — *All session output*, **Always append** — and:

```bash
python tools/plot_run.py                    # plot the newest run
python tools/plot_run.py -l vg1.0_vi5.0     # ...and archive it under that name
python tools/plot_run.py --compare          # overlay everything archived
```

The log path defaults to `DEFAULT_LOG` at the top of the script. Label runs with
the gains that produced them; `try4` is meaningless by the next morning.

Read these two numbers, in this order:

- **`stuck mid-stroke`** — fraction of samples where the command is sweeping
  fast and the encoder is not moving. This is missing torque authority and it is
  what `vel_gain` cures. Drive it to zero *first*.
- **`overshoot`** — how far past the command the joint travels at the ends of
  the stroke. Once stiction is beaten this dominates, and it points at the
  integrator rather than at `vel_gain`.

Sticking at direction *reversals* is reported separately because some of it is
unavoidable in any geared joint, and lumping it in hides the moment the real
problem is solved. `lag` is suppressed entirely while the joint sticks
mid-stroke — a best-fit time shift against a frozen trace is meaningless, and a
confident number there sends you tuning `pos_gain` when the problem is
`vel_gain`.

**Ignore `tracking %`.** It is a peak-to-peak ratio, so a joint thrashing 300%
past the setpoint scores better than one lagging gently. It is printed only
because it appears in older logs.

The loop, one round per gain change — gains are live over USB, no reflash:

```
1. odrivetool:  set vel_gain and vel_integrator_gain, read them back
2. board:       press RESET        (leg clear, stop button in reach)
3. wait ~21 s:  3 s arm + 2 s ramp + 16 s gait, then it dumps
4. host:        python tools/plot_run.py -l vgX_viY
```

If the capture count in the first line of output has not gone up, no new run was
recorded — PuTTY was not logging, or the reset did not take. Do not archive
anything until it does. `odrv0.save_configuration()` only once you are happy;
until then a power cycle silently reverts the gains and you are tuning against a
moving baseline without knowing it.

A worked example, hip_pitch on node 3, where `pos_gain × vel_gain` is the whole
stiffness of the position loop:

| | `vel_gain` 0.167, `vi` 0.333 | `vel_gain` 0.5, `vi` 2.5 |
|---|---|---|
| stiffness | 1.99 Nm/turn | 5.95 Nm/turn |
| RMS error | 12.16° | **2.14°** |
| worst error | 20.30° | 5.01° |
| stuck mid-stroke | seizing for seconds | 0.8% |

#### Where the three joints ended up

Three joints, three different answers, at `GAIT_SPEED 1.0`:

| joint | encoder | pos / vel / vi | FF | tracking | RMS |
|---|---|---|---|---|---|
| hip_pitch | motor, 47:1 | 20 / 1.0 / 5.0 | 1.0 | 101% | **0.13°** |
| knee | **load**, 47:1 | 30 / 10 / 12 | 0.5 | 145% | 0.46° |
| ankle | motor, 9:1 | 17 / 0.3 / 1.5 | 0.0 | 101% | **0.26°** |

**Do not read that as the hip being better tuned.** It has an easier job and a
flattering measurement, and both effects are large:

- **The gearbox divides the error.** Convert each RMS back to drive turns and
  the hip is 0.017, the ankle 0.047 - the ankle's drive is 2.8x worse in its own
  units, but 14x worse at the output, because 47:1 divides its error by 47 and
  9:1 only divides by 9. Two drives of identical quality still differ by 5.2x at
  the joint, and no tuning touches that.
- **Reflected inertia scales as 1/N².** The ankle's motor feels 27x more load
  than the hip's, which lowers the mechanical resonance and caps its stable
  gains. It vibrated at `vel_gain` 1.0, where the hip is perfectly happy. The
  ankle will never take the hip's numbers.
- **The knee is measured at the load.** Its 0.46° includes every degree of
  backlash and wind-up in its gearbox. The hip's 0.13° is a motor measurement
  divided by 47, and whatever its gearbox does is invisible in it. The knee's
  number is honest; the hip's is not comparable.

#### What each failure mode looks like

Every one of these was met at least once while tuning this leg:

| symptom | cause | what to change |
|---|---|---|
| overshoot, amplitude > 100%, smooth | underdamped | raise `vel_gain` |
| achieved arrives late, amplitude ~100% | not enough bandwidth | raise `pos_gain` |
| **both**: gain > 1 with ~90° lag | driven at the closed-loop resonant peak | raise `vel_gain`; do NOT drop `pos_gain` |
| constant-amplitude ripple, audible buzz | at the stability limit | lower the gain you last raised |
| square-wave error, sign flips with direction | friction, gravity, or feedforward | `vel_integrator_gain`, or `s_vel_ff[]` |
| **error does not respond to gain changes at all** | not the loop - look at feedforward | `s_vel_ff[]` |

The last row is the one that cost the most time. Lowering `pos_gain` from 20 to
7 on the knee made tracking% *improve* from 159% to 142% while RMS got **worse**,
1.03° to 1.34°, because the joint had simply gone slow enough to stop
overshooting - it was running a quarter-second behind the trajectory.

**Judge on RMS error, not tracking%.** Tracking% is an amplitude ratio: it
punishes overshoot and rewards a joint that merely lags, and it recommended
exactly the wrong change.

At the first setting the proportional term needed 27° of error to make the
~0.15 Nm that breaks the joint loose, and the whole gait is 13.8° — so the
position loop could never move the joint at all, and every motion came from the
integrator slowly winding up at 0.64 Hz. That is what stick-slip looks like in a
log, and it is a gain being an order of magnitude too small rather than anything
mechanical.

### `NEXUS_MODE_IMU` — BNO085 over UART

Exercises **USART2 only** (PD5 tx / PD6 rx, 3 Mbaud) — no CAN, no encoders, no
USB. Working, on hardware:

```
q[w,x,y,z]=+0.4625 +0.2537 -0.1549 +0.8353 |q|=1.000  a[m/s2]= +6.438 -2.910 +7.086  w[rad/s]= -0.014 +0.031 +0.023
  >> 0 err/s   per-report Hz: rotation=105 accel=158 gyro=421
     handshake: advertisement=SEEN reset-notice=seen
```

Data lines are throttled to 5/s because a 115200 console cannot carry 400 — but
the **rate is measured over every sample**, so throttling never hides a rate
problem.

#### Wiring

**Pin-by-pin wiring is in [docs/PINOUT.md](docs/PINOUT.md).** Summary: PD5
(`USART2_TX`) to the breakout's **SCL**, PD6 (`USART2_RX`) to its **SDA**, plus
3V3 and GND. The labels are not I²C — in UART mode SCL is the sensor's receive
and SDA its transmit.

Mode straps: **PS1 → 3V3, PS0 left alone**, which selects UART-SHTP.

No reset pin needed for UART. The straps are sampled **at the sensor's reset**,
so after changing them you must fully power-cycle — `-rst` and the black button
restart the STM32 but do not drop the sensor's 3.3 V.

#### Three bugs this bring-up found

All three were in our code, not the wiring, and all three came from the CEVA
datasheet:

**1. Bytes must be 100 µs apart.** §1.2.3.1: *"Bytes sent from the host to the
BNO08X must be separated by at least 100us. Bytes sent from the BNO to the host
have no extra spacing."* We sent frames back-to-back at 3 Mbaud — 3.3 µs per
byte, **thirty times too fast** — so everything after the first byte of every
frame arrived mangled. The rule being one-directional is exactly why the
sensor's own transmissions parsed perfectly while every frame we sent came back
as an SHTP error. This one cost the most time; nothing about the symptoms
pointed at timing.

**2. Wrong acceleration report.** We asked for `0x04` Linear Acceleration, which
has **gravity removed**. The estimator propagates `v += (R·a + g)·dt` and needs
*specific force* — what an accelerometer physically reads. A stationary robot
reported `(0,0,0)` against gravity's `−9.81`, so the filter would have concluded
**free fall** and ramped velocity downward forever. Now `0x01` Calibrated
Acceleration, which includes gravity. The host tests never caught it because
they fed the filter synthetic specific force.

**3. Per-channel sequence numbers.** SHTP counts them per channel; we kept one
global counter, so the control channel opened mid-sequence.

#### Reading the output

- **`|q|` is a free correctness check.** A unit quaternion always has norm 1. If
  it is not ~1.000 the bytes are being misinterpreted — wrong Q-point,
  misaligned report, wrong report id — even when the numbers look plausible.
- **The accelerometer must show gravity.** Held flat and still it reads ~9.81 on
  one axis. Zeros mean bug 2 is back.
- **The counters separate wiring faults from protocol faults**, which otherwise
  look identical:

| Symptom | Meaning |
|---|---|
| `bytes/s = 0`, `ndtr` frozen | Nothing on the wire — TX/RX swapped, no power, no ground |
| bytes but `frames/s = 0` | Wrong baud, or the IMU is in **UART-RVC** instead of **UART-SHTP** |
| frames but only channel 0 | The sensor is *rejecting* what we send — it answers with an SHTP error list |
| `advertisement=not seen` | The sensor never finished booting. Power-cycle. |

The startup **listens for one second before transmitting anything**. Datasheet
§5.2.1 says the sensor announces itself unprompted after reset, so silence in
that window means the part is not running — a question no test that transmits
first can answer.

#### Report rates

Measured, with all three reports requested at 400 Hz:

| Report | Rate | |
|---|---|---|
| Gyro `0x02` | **421 Hz** | drives the filter's orientation |
| Accelerometer `0x01` | **158 Hz** | drives velocity — the binding constraint |
| Rotation vector `0x05` | 105 Hz | deliberately slowed to 100 Hz |

Datasheet §6.9 warns that *"all sensors cannot operate at their maximum rate
simultaneously"*, and the accelerometer is what the sensor starves. **This is
not yet resolved** — see *Known issues*. `IMU_ENABLE_QUAT 0` drops the sensor's
quaternion entirely to test whether the fusion engine is what costs the
accelerometer its budget; the Pi still gets `quat` from our own estimator, which
is fused with leg kinematics and is the better estimate anyway.

## Arming, faults and the failsafe

The firmware does not simply do as it is told. Between the Pi and the
actuators sits a small state machine (`Appli/App/safety.c`):

```
BOOT  ---- everything being watched is healthy ---->  IDLE
                                                       |  command with
                                                       |  CMD_ENABLE set
                                                       v
FAULT <--------- HEALTH_LINK or HEALTH_TIMING ------ ARMED
  |                                                    ^
  +---- faults clear ----> IDLE ---- re-arm handshake --+
```

**What the Pi has to do**

| | |
|---|---|
| Set `CMD_ENABLE` | `link.send_command(...)` does this by default. Without the flag nothing reaches the actuators. |
| Advance `seq` | Replayed or out-of-order frames are refused within a command session. A session starts at every command with `CMD_ENABLE` off, so a restarted Pi counting from 0 again is accepted after its handshake. `NexusLink` handles this. |
| Stand down cleanly | `link.stand_down()` at the end of a run, so the axes idle instead of holding torque. |
| Re-arm after a fault | A latched fault clears only after a command with `CMD_ENABLE` **off**, then one with it on. `stand_down()` then `send_command()`. |

**What the firmware does on its own**

- **Commands stop for 200 ms** → `HEALTH_LINK` → FAULT → every axis is asked to
  go `IDLE`, and the request is repeated every 100 ms while the fault stands.
  The last target is *not* held indefinitely any more.
- **A tick is missed** → `HEALTH_TIMING` → the same.
- **A command fails validation** — NaN, outside `SAFETY_POS_*_TURNS`, or a jump
  larger than `SAFETY_MAX_STEP_TURNS` — it is refused and counted. Ten in a row
  faults the link.
- **The loop stops completing cycles** → the independent watchdog resets the
  board after 100 ms. It is refreshed only by a tick that ran to completion,
  never from the idle loop.
- **A hard fault, or `Error_Handler()`** → `Set_Axis_State(IDLE)` goes out on
  both CAN buses before anything spins forever.

A watchdog reset is announced on the serial console at the next boot. Do not
ignore it: it means the loop stopped, and the board came back looking healthy.

> **Bring-up note.** `safety.c` will not arm until every subsystem in
> `HEALTH_EXPECTED_MASK` is healthy, and that defaults to the whole robot — a
> failsafe that is not watching the Pi link is not a failsafe. On a partially
> wired bench, narrow it at configure time rather than editing the header:
> `HEALTH_EXPECTED_MASK='(HEALTH_TIMING|HEALTH_IMU)' cmake --preset Debug`.
> The configure step warns whenever it is narrowed, because subsystems outside
> the mask cannot fault and the failsafe therefore cannot act on them.

---

## Testing the USB link to the Pi

### What the link is

The Nucleo has two USB ports, and they do different jobs:

| port | what it is | used for |
|---|---|---|
| **ST-LINK** | debugger | flashing, and the text console (`/dev/ttyACM0` on a laptop, 115200) |
| **USB user port** | the H7S3's USB OTG HS, embedded PHY, **480 Mbit/s** | the robot's data link to the Pi |

On the user port the board is a USB *device* and the Pi is the *host*. It shows
up as a serial port (USB CDC, `/dev/ttyACM*`, USB ID `0483:5740`) and carries
binary packets, not text: a 426-byte state packet every millisecond out, 44-byte
commands in. Plug it into any USB port on the Pi.

What sends packets depends on the mode:

| mode | packets |
|---|---|
| `NEXUS_MODE_ROBOT` | the full state, always |
| `NEXUS_MODE_LEG_CAN` | **the leg test's run** — its joints, targets, torques and drive states — with `LEGTEST_USB_STREAM 1`. Commands from the Pi are received and ignored: nothing on USB can move the leg in this mode |
| `NEXUS_MODE_IMU`, `_LEG_TORQUE` | none — the port enumerates but stays silent |

In the leg test the packet is filled by `leg_stream.c` (host-tested). The bench
leg is on FDCAN1, bus 0, so by the [joint map](#the-joint-map) its drives appear
as the **left** leg whichever physical leg it is: node 1 → `left_hip_pitch`,
node 3 → `left_knee_pitch`, node 4 → `left_ankle_pitch`. `ref_angle` is the
target the test last sent; everything the test does not have — estimator, IMU,
springs, feet — reads as absent (identity quaternions, `foot_z` NaN, fusion
INVALID), and `stream_flags` carries `NEXUS_STREAM_LEG_TEST`.

The other half of this link is the [zeus_26_mukesh_deploy](https://github.com/Maverick280306/zeus_26_mukesh_deploy)
workspace; the commands below run in a clone of it.

### Level 1 — the cable enumerates

Any mode. On the Pi (or laptop), with the user port plugged in:

```bash
lsusb | grep 0483:5740       # STMicroelectronics Virtual COM Port
lsusb -t                     # that device's line must say 480M
sudo dmesg | tail            # "new high-speed USB device" ... "cdc_acm ... ttyACMn"
```

| result | meaning |
|---|---|
| not listed | cable in the ST-LINK port, a charge-only cable, or the Appli is not running (check the console) |
| `12M` / "full-speed" | enumerated, but not at high speed: swap the cable or port. 12 Mbit/s cannot carry 1 kHz of packets |
| `480M` | the cable and the PHY are good |

### Level 2 — packets arrive intact

```bash
cd zeus_26
PYTHONPATH=zeus_link python3 -m zeus_link.link_check --joints
```

Healthy is **~1000 Hz, 0.000% lost, 0 junk B**; the second column says
`LEG TEST` or `ROBOT`. No ROS needed, and it sends nothing to the board.

| result | meaning |
|---|---|
| `no STM32 USB link found` | not enumerated — go back to level 1 |
| 0 Hz | enumerated but silent: IMU or LEG_TORQUE mode, or the Appli is stuck |
| junk bytes climbing | something else has the port — usually ModemManager on Ubuntu; install `zeus_bringup/config/99-zeus-stm32.rules` |
| lost > 0 | packets the board sent and the Pi did not read in time |

One leg-test detail: once a second the test prints its status over the ST-LINK
console, which blocks for a few tens of ms. Those ticks are not sent. `seq`
counts processed ticks, so this does not show as loss — but a plot drawn
against `seq` runs slightly short of wall-clock time.

### Level 3 — watch it live on your laptop

Rerun's viewer runs on the laptop; the Pi reads the port and streams to it over
the network. Both on the same Wi-Fi or Ethernet.

**Laptop**, once, then each time:

```bash
python3 -m venv --system-site-packages ~/rerun_venv && ~/rerun_venv/bin/pip install rerun-sdk   # once
~/rerun_venv/bin/rerun          # opens the viewer and waits
hostname -I                     # the laptop's IP
```

**Pi**, once — the same `rerun_venv` commands, and a clone of
`zeus_26_mukesh_deploy`. Then:

```bash
cd zeus_26
PYTHONPATH=zeus_rerun:zeus_link ~/rerun_venv/bin/python -m zeus_rerun.rerun_serial \
    --connect <LAPTOP_IP> --degrees
```

Start the leg test. The **Joints** tab shows each joint's actual angle against
the target, in degrees, live — the same comparison as the captured CSV plots,
without the copy and paste. The seven joints not on the bench stay at zero.
Use the same `rerun-sdk` version on both machines.

With ROS on the Pi instead, the same view comes through `/zeus/state`:

```bash
source ~/rerun_venv/bin/activate
ros2 launch zeus_bringup robot.launch.py rerun:=connect rerun_host:=<LAPTOP_IP> rerun_degrees:=true
```

**No Pi yet?** Plug the user port into the laptop and run level 2 there, then
`... rerun_serial --spawn --degrees` instead of `--connect`.

---

## What the Pi receives

One **426-byte packet every millisecond** (426 KB/s, under 1% of USB HS).
`Appli/App/link_proto.h` and `pi/nexus_proto.py` describe the same bytes;
`tools/check_proto.py` compares every field offset, both struct sizes and the
joint map, so a mismatch is caught rather than debugged.

The Pi side of this link is the [zeus_26_mukesh_deploy](https://github.com/Maverick280306/zeus_26_mukesh_deploy)
ROS 2 workspace. Its `zeus_link` package holds the CANONICAL
`nexus_proto.py` since the policy landed, and `pi/nexus_proto.py` here is
copied from it; `pi/nexus_link.py` is still ours. Both are checked
against the C header.

### The joint map

Every per-joint array in both packets — `joint_pos`, `joint_vel`, `ref_angle`,
`act_*`, and the command's `residual` — uses one index:

```
index = bus * 5 + (node - 1)          bus 0 = FDCAN1, bus 1 = FDCAN2
```

| index | bus | node | joint |
|---:|---:|---:|---|
| 0 | 0 | 1 | left_hip_pitch |
| 1 | 0 | 2 | left_hip_roll |
| 2 | 0 | 3 | left_knee_pitch |
| 3 | 0 | 4 | left_ankle_pitch |
| 4 | 0 | 5 | left_ankle_roll |
| 5 | 1 | 1 | right_hip_pitch |
| 6 | 1 | 2 | right_hip_roll |
| 7 | 1 | 3 | right_knee_pitch |
| 8 | 1 | 4 | right_ankle_pitch |
| 9 | 1 | 5 | right_ankle_roll |

The packet carries no names, so this table is the only thing labelling them.
It is defined once in C (`NEXUS_J_*` in `link_proto.h`) and once in Python
(`JOINT_NAMES` in `pi/nexus_proto.py`), and `tools/check_proto.py` fails if the
two disagree.

#### Two legs, no waist — a temporary build

The robot has **ten** actuators: these eight plus waist roll (bus 0 node 5) and
waist pitch (bus 1 node 5). This firmware brings the two legs up without them.

| | |
|---|---|
| **CAN** | four drives per bus. Node 5 is neither commanded nor expected; a frame from it is ignored and not counted as a live drive |
| **Packet** | 8 joints, protocol **v7**. The Pi must be updated together with the board — each rejects the other's version rather than misreading it |
| **Waist** | none. Both hips bolt straight to the torso in the current model, so there is no joint between the IMU and the legs and nothing for the estimator to hold at zero |
| **Gait** | every index is a leg joint now, so every joint has a reference |
| **URDF** | unchanged: the robot still has the parts. `/joint_states` on the Pi carries the two waist joints at 0 so the model stays in one piece |

Putting the waist back: `NEXUS_NUM_JOINTS` 10, `ODRV_NODES_PER_BUS` 5, the map
above back to `bus * 5`, the two `NEXUS_J_WAIST_*` indices, the waist entries in
`robot_config.c`, the version bump, and the Pi side to match. The tag
**`waist-10-actuators`** marks the last commit that had them.

### What the drive was told

`act_target[]` is the number the interpolator actually put on the wire this
tick, in radians on the output side - the reference, plus the policy's
residual, after the safety envelope and the slew limit. `ref_angle + residual`
is what the Pi **asked** for; this is what the joint **got**, and it is the only
honest thing to plot `joint_pos` against when tuning a drive. It is NaN
whenever nothing is being driven, so a plot shows a gap rather than a flat line
that reads as a command the joint is ignoring.

### Gains, from the Pi

The ODrives close their own position and velocity loops; this board only sends
targets. `g_drive_gains[]` in `robot_config.c` is what it writes to every drive
**on every arm** - not once at boot, so a drive that browned out or was swapped
comes back with the gains the robot is actually running rather than whatever is
saved in that particular drive.

The Pi can replace that table between runs with a third message type,
`nexus_gains_t` (`NEXUS_MSG_GAINS`, 106 bytes, sent by hand or by a tuning
script - never in a control loop):

- **Refused while the robot is driving.** A velocity gain changing under load is
  a step change in torque with a leg's weight behind it.
- **The board says so by NOT moving `gains_seq`** in the state packet, which
  echoes the seq of the last gains message it applied. The Pi sends, watches
  that byte, and knows.
- **Not saved in the drives.** Power-cycle the board and it goes back to
  `robot_config.c`. When a value is settled, put it there and reflash.

The Pi side is `zeus gains show / push / set` and `zeus tune` in
[zeus_26_mukesh_deploy](https://github.com/Maverick280306/zeus_26_mukesh_deploy); the metrics that say
which gain to change live in `zeus_link.tuning`.

### The policy block

Bytes 12 to 195 are **46 contiguous float32** holding exactly what the RL
observation needs, in the order it expects. The Pi slices it in place and copies
nothing:

```python
obs = np.frombuffer(raw, "<f4", count=52, offset=12)
```

| # | Field | Count | Units | Comes from |
|---|---|---|---|---|
| 0 | `pelvis_z` | 1 | m | estimator — height above stance ground |
| 1 | `quat` | 4 | w,x,y,z | estimator (observation uses x,y = indices 1,2) |
| 2 | `gyro` | 3 | rad/s, **body** | BNO085 |
| 3 | `vel_hdg` | 3 | m/s, **heading** | estimator — lateral, forward, vertical |
| 4 | `joint_pos` | 10 | rad, output side | ODrive |
| 5 | `joint_vel` | 10 | rad/s, output side | ODrive |
| 6 | `spring_angle` | 4 | rad | after-spring encoders — **deflection** |
| 7 | `ref_angle` | 10 | rad, output side | stored gait at `phase` — what `residual` adds to |
| 8 | `contact` | 2 | 0.0 / 1.0 | foot switches: left, right (one per foot) |
| 9 | `foot_z` | 2 | m, world | forward kinematics — **[0] right, [1] left** |
| 10 | `phase` | 1 | 0..1 | stride clock, free-running at 1 kHz |

**Everything is a raw SI quantity.** The STM32 applies no policy scaling — no
target-height subtraction, no `/10`, no clipping, no sin/cos, no normalisation.
All of that belongs on the Pi, so the observation transform can change without
reflashing the robot.

Four things worth understanding:

- **`spring_angle` is deflection, not a joint angle.** The encoder sits *after*
  the series spring, so it reads how far the spring has wound up. Torque is
  deflection × spring constant, computed on the Pi where the constant is tunable.
  It is a **signed** value in ±π, referenced to a mechanical zero in
  `robot_config.h` — not the raw 0..2π angle it used to be, which stepped by a
  full turn for any joint resting near the wrap point. The estimator **adds** it
  to the drive's angle for hip pitch and knee: the drive measures before the
  spring, the encoder only the spring, and the link's real angle is the sum.
- **`vel_hdg` is in the heading frame, not the world.** Forward means where the
  robot faces. Yaw is the one part of the pose the filter cannot observe, so it
  drifts — but the same drifting yaw defines both the velocity and the frame, so
  the error cancels.
- **`foot_z` is computed every tick, including during swing.** A gait policy
  cares most about the foot that is off the ground. A foot whose leg cannot be
  read is sent as **NaN** with its `fk_valid` bit clear — never as 0.0, which
  reads as "resting exactly on the ground".
- **`ref_angle` is the reference, not a command.** The stride clock runs
  whether or not the Pi talks, so the policy can see the reference before it
  sends anything. The drives only move on an accepted command
  (`ref_angle + residual`); a Pi that stops sending gets the last target held
  and, 200 ms later, a link fault that idles every axis.

### The rest of the packet

Diagnostics and raw values the policy does not need but a human debugging it
does: `imu_quat` (the sensor's own 9-axis fusion, independent of ours),
`imu_accel` / `imu_gyro`, `act_torque`, `act_error` / `act_state` / `act_flags`,
`fused_pos` and `fused_vel` (world frame, before the heading rotation), the
estimated IMU biases, `contact_ticks`, and `health` — the same bitmask the red
LED blinks.

Two more that are worth wiring into any policy loop:

| Field | Meaning |
|---|---|
| `fk_valid` | bit 0 = `foot_z[0]` (right) is a real measurement, bit 1 = `foot_z[1]` (left). An invalid entry is also sent as NaN. Use `pkt.foot_z_right` / `pkt.foot_z_left`, which return `None` rather than a number you should not trust. |
| `safety_state` | `BOOT` / `IDLE` / `ARMED` / `FAULT` — whether the board is driving the actuators, and whether it has taken them away from you. `pkt.armed` and `pkt.faulted`. |
| `stream_flags` | `STREAM_GAIT_LIVE` says `ref_angle` and `phase` are real. Check `pkt.gait_live` rather than watching `phase` for movement — a gait parked at phase 0 looks identical to one that does not exist. |

And a **diagnostics block**: `loop_us_max` (worst control cycle since the last
packet, so a live signal rather than a since-boot high-water mark), `overruns`,
`usb_dropped`, `can_dropped`, `can_bus_off` and `enc_stalls`. These used to go
only to the serial console, in a line that cost ~9.5 ms of a 1 ms loop every two
seconds — a diagnostic causing nine of the missed ticks it reported. Watch
`overruns` for *change* rather than for zero; it is cumulative.

And **`fused_valid`**, which matters more than the rest:

| Value | Meaning |
|---|---|
| `INVALID` | no contact, IMU stale, or the filter diverged |
| `CONVERGING` | running, uncertainty still large |
| `OK` | velocity uncertainty low for 500 consecutive ticks **and** the robot has been measured (`ROBOT_CONFIG_CALIBRATED`) |

**Check `fusion_usable` before using height or velocity.** The filter starts
with 30° of orientation uncertainty and 1 m/s of velocity uncertainty; for the
first ~2 seconds those numbers are meaningless. It also stays `CONVERGING`
forever while `robot_config.h` says the robot has not been measured — converged
is not the same as correct, and the covariance cannot tell the difference.

### Rates

There is one stream, not several. Every field ships in the same packet every
millisecond — but not every field is *freshly measured* every time:

| Field | Genuinely new at | Note |
|---|---|---|
| `joint_pos/vel`, `spring_angle`, `contact` | **1 kHz** | new value in every packet |
| `gyro`, `imu_accel` | ~400 Hz gyro, ~160-220 Hz accel | bytes repeat between updates; watch `imu_seq` |
| `quat` (ours), `pelvis_z`, `vel_hdg`, `foot_z` | 1 kHz corrected, IMU-rate propagated | contact update every tick, prediction only on a new IMU sample |
| `imu_quat` (sensor's) | 100 Hz | deliberately slowed, see the IMU section |

So actuator and spring-encoder data really does reach the Pi at 1 kHz. The wire
and the kernel buffer never drop it — **the only way to lose it is to read too
slowly.**

### Receiving it at 1 kHz

`pi/nexus_link.py` is the reader. A background thread drains the port so
reception stays at 1 kHz no matter what the control loop is doing; the loop
then takes the newest packet and ignores the rest.

```python
from nexus_link import NexusLink

with NexusLink('/dev/ttyACM0') as link:
    if link.wait_for_fusion(timeout=10) is None:
        raise RuntimeError('estimator never converged')

    while True:                       # policy at 250 Hz
        pkt = link.latest()           # never blocks, never stale
        if pkt is None or not pkt.fusion_usable:
            continue
        action = policy(build_obs(pkt))
        link.send_command(action_to_turns(action))
```

**A 250 Hz loop that reads one packet per step falls three packets further
behind every step, forever.** Discarding the older three is not data loss — the
newest packet is the only one that is not already out of date. Pass
`history=N` and call `drain()` if you also want every packet for logging.

`link.stats` reports `loss_rate`, `seq_gaps` and `junk_bytes`; all three should
be zero on a healthy link. Run `python pi/nexus_link.py /dev/ttyACM0` on the Pi
before wiring anything into the ROS workspace — a problem is far easier to
find there than inside a control loop.

`tools/test_pi_link.py` proves the Python side sustains 1 kHz without hardware:
it feeds `NexusLink` a synthetic 1 kHz stream through a fake port and checks
every packet arrives, in order, with no gaps. It also measures parse load, which
matters more than it looks — the original pure-Python CRC cost 55% of a desktop
core at 1 kHz and would not have kept up on a Pi at all. `crc16` now calls
`binascii.crc_hqx`, the same algorithm in C and ~300× faster (2.8% of a core);
`_crc16_slow` is kept as the reference the test checks it against.

### Layout rules

- **Every 4-byte field sits on a 4-byte boundary.** The struct is packed, so
  otherwise the M7 emits byte-wise access for every misaligned float and numpy
  cannot view the buffer in place on the Pi. Fields are grouped by size rather
  than by topic for this reason.
- **The policy block is contiguous and its offset is checked.**
  `tools/check_proto.py` fails if the block moves or gains a gap, because the
  zero-copy slice above would then read the wrong bytes silently.
- **Protocol version is 10.** v1 sent raw encoder counts; v2 added the health
  byte and alignment; v3 added the policy block and split the contacts; v4 added
  `fk_valid` and `safety_state`; v5 added the diagnostics block; v6 made the
  command a residual rather than a target; v7 dropped the two waist joints; v8
  added `act_target` and the gains message; v9 cut each foot from two switches
  to one; **v10 added the two ankle roll joints**, taking the count to ten and
  the policy block to 50 floats.
  422 → 424 → 444 → 400 → 434 → 426 → 478 bytes.
  Mismatched versions reject each other rather than silently misparsing.

## Watching it live — Rerun

`pi/zeus_viz.py` turns the 1 kHz packet stream into live plots and a 3D view.
It is a consumer of the existing link, not new plumbing.

### The one thing to understand

Rerun splits into an **SDK** and a **Viewer**, and they do not have to be on the
same machine. That split is the whole answer to "the Pi has no screen":

```
STM32 ──USB──► Raspberry Pi ──network──► your laptop
1 kHz          zeus_viz.py               Rerun Viewer
sensing        (the SDK)                 (the window)
               headless                  where you look
```

The Pi logs. The laptop looks. Neither needs the other to exist for the robot
to run — **the viewer is never in the control path.**

### Wireless

```bash
# laptop — starts an empty viewer and waits
pip install rerun-sdk
rerun

# pi — point it at the laptop's IP
python pi/zeus_viz.py /dev/ttyACM0 --connect 192.168.1.50
```

Port **9876**, plain TCP. Wi-Fi is fine: decimated to 200 Hz the stream is a few
hundred KB/s, which is nothing for 802.11n. Expect 5–50 ms of latency and some
jitter — irrelevant for watching, and the reason this is *only* for watching.

> **Never put anything that commands the robot on Wi-Fi.** The policy runs on
> the Pi over USB for a reason. A dropped viewer connection must be a blank
> screen, never a stalled leg.

### Wired

Same command — the Pi just reaches the laptop over Ethernet or a USB-Ethernet
gadget instead. Lower latency and no dropouts, worth it if you are watching
something fast. Nothing in the script changes.

### Record now, look later

```bash
# pi
python pi/zeus_viz.py /dev/ttyACM0 --save run.rrd

# laptop
scp pi@raspberrypi:run.rrd .  &&  rerun run.rrd
```

**Start here.** No network at all, and recorded sessions scrub — you can find
the 40 ms where something went wrong and step through it, which live viewing
cannot do. Most interesting failures are over before you look up.

### Laptop only, no Pi

```bash
python pi/zeus_viz.py COM7 --spawn
```

STM32 plugged straight into the laptop. **This works today with one actuator** —
you do not need the Pi to exist to develop against real data.

### What it shows

| Path | |
|---|---|
| `estimator/height`, `estimator/vel/*` | what the policy consumes |
| `joints/pos/*` vs `joints/ref/*` | commanded against measured, same plot |
| `springs/*`, `contact/*`, `feet/*_z` | leg state |
| `gait/phase` | where in the cycle |
| `imu/gyro/*`, `imu/accel/*` | raw, for cross-checking the estimator |
| `world/pelvis` | 3D pose from the fused quaternion |

Scalars are decimated to 200 Hz (`DECIMATE` in the file). Set it to 1 when
chasing impact transients; the eye cannot use 1 kHz but a plot can.

### Simulation beside reality

`log_sim()` takes joint angles from MuJoCo and logs them under `sim/…` on the
same timeline. Drop `sim/joints/3` and `joints/pos/3` into one plot and the
sim-to-real gap is right there.

**MuJoCo is not part of the robot** — it is the simulator the policy was trained
in, running on a desktop. This comparison is optional. It is also the single
most useful thing here, because a policy that works in simulation and not on
hardware shows its divergence on that plot long before the robot shows it by
falling over.

---

## State estimation

A contact-aided right-invariant EKF, ported from the Python in
`vismay5559/zeus_26` (`zeus_sensor_fusion`, the retired workspace) and
following Hartley et al. 2019.
It fuses the IMU with leg forward kinematics while feet are on the ground to
estimate body orientation, velocity, height and IMU biases.

All fusion runs **on the STM32**. The Pi receives the fused state and runs only
the RL policy.

| File | Contents |
|---|---|
| `lie_group.c` | SO(3) exponential, Gamma0-3, fixed-stride matrix helpers |
| `zeus_kinematics.c` | Contact-point position in the IMU frame + exact 3x8 Jacobian, from the URDF |
| `inekf.c` | Predict, contact update, contact add/remove |
| `fusion.c` | Sensors in, estimate out: joint angles, contacts, noise, status |

State is `X` in SE_{N+2}(3) with `R, v, p` and one world position per contact,
IMU bias `theta` in R^6, and a 27x27 right-invariant error covariance. There are
two contact points - one per foot, at the centre of each sole - and
each is added when its switch closes and removed when it opens, so a rolling
foot is planted instead of pretending the whole robot is planted.

Per leg the kinematics take six angles: that leg's four drives and the two
spring deflections, added to hip pitch and knee because the drives measure
before the spring. There are no waist joints - both hips bolt straight to the
torso, so nothing sits between the IMU and the legs. Each joint's noise is
pushed through the Jacobian into a 3x3 covariance for the contact point. A
spring encoder that is not valid, or reads beyond
`ROBOT_SPRING_MAX_DEFLECTION_RAD`, is treated as unknown (0 with a wide
variance) rather than bent into the leg.

### Deliberate differences from the Python

**Fixed-size, no allocator.** The Python reshapes `X` and `P` with numpy every
time a foot lands or lifts. Everything here is declared at its four-contact
maximum with an active flag per slot; error-state matrices keep a constant
stride so indices never move, and inactive contact blocks are zeroed so they
are inert in every product.

**`float`, not `double`.** Singles are ~2x faster on this FPU and halve memory
traffic, and covariance propagation is the hot path. Joseph-form updates plus
explicit symmetrisation every step keep it stable. `inekf_real_t` is the one
switch if that ever stops holding.

**An exact Jacobian.** The Python differentiates forward kinematics
numerically, which at float32 sits right at the resolution floor.
`zeus_kinematics.c` computes each column as `axis x (point - joint origin)`
along the chain it has already walked - exact, and no extra FK.

**Four contacts for the price of two.** Going from 21 to 27 states makes every
dense product ~2.1x dearer. Two changes pay for it without changing a single
number: prediction computes `Phi (P + Qbar dt) Phi^T` (two products, not four),
and the contact update's Joseph form is written as rank-3 corrections, since
`H` has only six non-zero columns, instead of dense `(I-KH) P (I-KH)^T`. The
host test checks the fast update against a dense one. Worst-case tick by count
of multiply-accumulates: ~67k with four contacts, against ~74k for the old
two-contact code. **Not yet measured on the board** - `loop_us_max` in the
state packet is the number to watch.

### Checked against the paper

Verified equation by equation against Hartley et al. 2019
(arXiv:1904.09251). Two defects were found and fixed that the Python has:

**`Phi(phi,phi)` must be IDENTITY** (eq 58), not `Gamma0^T`. `Gamma0^T` belongs
to the *left*-invariant `Phi^l` (eq 55), where the error lives in the body
frame. This is not cosmetic - the identity block is exactly why the
right-invariant error dynamics are independent of the state estimate, which is
the property the whole method rests on. With `Gamma0^T` there, the filter
degrades into the state-dependent linearisation the paper compares against and
beats.

**`Q_bar` must use the full adjoint** (eq 28: `Ad*Cov(w)*Ad^T`). `Ad` (eq 63)
carries `(v)_x R`, `(p)_x R` and `(d_k)_x R` in its first block column, so gyro
noise reaches velocity, position and every contact with cross-covariances
between them. A diagonal `Q_bar` drops all of it. Those terms scale with `|v|`,
`|p|`, `|d|` - negligible at the origin, growing as the robot walks away, which
is when the covariance most needs to be right.

`H` is written as `[0 0 -I I 0 0]` exactly as eq 20, with the correction `+K z`
per eq 29, so the code reads directly against the paper.

Known approximations, both as the paper allows:

- `Psi1`/`Psi2` (eq 56/57) use only the leading `(a)_x Gamma2/3(-w dt)` term
  and drop the higher-order corrections. Those vanish as `w*dt -> 0`, and at
  400 Hz `w*dt` is small.
- `Q_d ~ Phi Q_bar Phi^T dt` (eq 61) - the same approximation the paper used
  for all of its own results.

### Two bugs found in the Python during the port

**The measurement is not used in the update.** `update_contact` computes
`Xinv @ b` and never touches `B_p_BC`, so the innovation is
`R^T(d_k - p)` - the prediction alone, with the encoder measurement missing
entirely. The C version uses the right-invariant innovation
`z = R*B_p_BC + p - d_k`, which is zero exactly when the state agrees with
forward kinematics.

**`Phi` is built from the already-propagated state.** `R`, `v`, `p` are numpy
*views* into `self._X`; writing the propagated values back silently updates
them, so `state_transition_right` receives the new state and then propagates it
again internally. `Phi` linearises about the state at t_k, so the C version
keeps the pre-propagation values.

Both are worth fixing in the Python too if it stays in use.

### Verification

Checked on the host against independent references, not against the Python:

- `Gamma1` against a numerically integrated `exp(phi*s) ds` (1e-4)
- Contact-point kinematics against Pinocchio reading the same URDF (0.2 um, 48 poses)
- Free fall for 1 s gives exactly -9.81 m/s and -4.905 m
- **An injected 20 cm position error decays to 1.1 mm under contact updates** -
  this is what validates the innovation and `H` sign convention; with either
  flipped the error would diverge instead
- Covariance stays symmetric and positive on the diagonal through 200 cycles
- **The observability structure of section 5.4 is reproduced**: over 4000 steps
  roll and pitch covariance shrink ~50x while yaw, being unobservable, does not
  converge at all. This only emerges with the identity `Phi` block, so the test
  fails against the pre-correction code
- The `phi`-position cross-covariance is non-zero once the body has moved off
  the origin, which a diagonal `Q_bar` could never produce

### Against a simulated walk

Unit tests say the pieces behave; they cannot say the estimate is right,
because on the robot nobody knows the true motion. `tools/sim/` makes a walk
whose true motion is known exactly and runs the **real** `fusion.c`,
`inekf.c` and `zeus_kinematics.c` on the sensor data it produces:

```
zeus.urdf ─► gen_walk.py ─► what the IMU, drives, springs and switches would read ─► replay (fusion.c) ─► evaluate.py
                        └─► the true torso motion ──────────────────────────────────────────────────────────┘
```

The walk is kinematic, built from the URDF: the stance foot is fixed to the
world and the torso moves however the joint angles make it, so a closed
switch's contact point really is still. It has what the estimator must cope
with: heel strike and toe-off (the sole-centre switch closes only for the flat
middle of stance), spring wind-up on
the stance leg, hip-roll sway, 400 Hz IMU with noise and constant
biases, drives reporting at 500 Hz.

```bash
python3 -m venv ~/kinvenv && ~/kinvenv/bin/pip install -r tools/requirements-kinematics.txt   # once
PY=~/kin_venv/bin/python EVAL_PY=python3 env -u PYTHONPATH tools/sim/run.sh --plot   # writes tools/sim/out/estimate.png
tools/sim/run.sh --check                                                               # what CI runs
tools/sim/run.sh -- --steps 30 --seed 7 --accel-bias 0 0 0                            # after -- : gen_walk.py options
```

Results on the current URDF, 16 steps, 3.9 m, judged after 2 s:

| | error |
|---|---|
| tilt (roll/pitch) | 0.23 deg rms |
| velocity, body frame | 0.010 m/s rms, 0.034 max |
| IMU height | 10 mm rms, 12 mm drift over 3.9 m |
| foot height | 10 mm rms |
| yaw | +0.7 deg over 14.6 s (unobservable, reported only) |

Almost all of the tilt and height error is one thing: the accelerometer's
horizontal bias (0.03 and -0.02 m/s^2 in the simulation) cannot be told apart
from a tilt of 0.2 deg, so the filter never learns it - exactly as the paper's
observability analysis says. That tilt then places each new foothold slightly
high, which is the slow height drift. With the horizontal bias set to zero, the
same walk gives 0.08 deg tilt, 3 mm height rms and 0.4 mm of drift. On the robot this makes a
level-surface accelerometer calibration worth having.

`--check` fails CI beyond roughly two to three times these numbers. It was
checked by corrupting the simulated sensors: a flipped knee sign (42 cm height
error), and spring deflections dropped (11 cm) or marked invalid (13 cm), all
fail. **Losing the spring encoders costs over ten centimetres of height in four
metres** - they are not optional for the estimate.

A waist that is not bolted where the estimator thinks used to fail too, but
there is no waist to mis-model any more; that mutation went with it. It gave
0.088 m/s of velocity error against a 0.03 limit. Worth repeating on the real
robot's bracket before trusting the estimate.

Swapping the two feet does not fail: velocity error rises 50%, but the
filter's foot-slip allowance absorbs it.

What this does not test: impacts and foot slip (the walk has neither), the
real sensors' noise, anything the URDF gets wrong about the real robot, and
timing on the board. The URDF is currently the older design with hip roll as
the parent.

## Diagnostics

### Serial console

`printf` is routed to the **ST-LINK virtual COM port** in both projects.
Open it at **115200 8N1, no flow control**. Boot prints its external-memory
init trace; the Appli prints a status line every 2 seconds:

**Off by default.** Every counter it carried now ships in the state packet at
1 kHz instead. Turn it on only when there is no Pi attached — it blocks the
control loop for ~9.5 ms each time it prints:

```bash
NEXUS_LOOP_STATS=1 cmake --preset Debug
```

```
ARMED | loop max 234 us | overruns 0 | can drop 0/0 | usb drop 0 | rej 0 | health 0x00 watching 0x3F blink 0
```

| Field | Meaning |
|---|---|
| state | `BOOT` / `IDLE` / `ARMED` / `FAULT` — see the failsafe section |
| `loop max` | Longest single cycle, of a 1000 µs budget |
| `overruns` | Ticks missed because a cycle ran long. Should stay 0 |
| `can drop` | Frames dropped per bus because the bus could not keep up |
| `usb drop` | State packets skipped because the host was not draining the endpoint |
| `rej` | Commands refused by validation since boot. Non-zero means the Pi is sending something wrong |
| `health` | Bitmask of faulted subsystems — see below |
| `watching` | Which subsystems are armed (`HEALTH_EXPECTED_MASK`) |
| `blink` | What the red LED is currently blinking |

### LEDs

| LED | Meaning |
|---|---|
| **LD1 green** | 1 Hz heartbeat — the 1 kHz loop is alive and on time |
| **LD2 yellow** | Boot→Appli marker. Off = handover fine. **Stuck on = the Appli never started** |
| **LD3 red** | Blink code for the first faulted subsystem |

```
1 blink = IMU stale             4 blinks = CAN bus 2 silent
2 blinks = encoders invalid     5 blinks = Pi link stale
3 blinks = CAN bus 1 silent     6 blinks = loop overrun
```

Red also goes solid from `Error_Handler()` or a hard fault.

**"Healthy" means data is flowing, not that the peripheral initialised.** Every
peripheral initialises fine with nothing plugged in, which tells you nothing —
so an unconnected sensor is deliberately a fault. `HEALTH_EXPECTED_MASK` in
`Appli/App/health.h` gates which subsystems may complain; it defaults to the
whole robot, and red going dark is your proof each one works. During bring-up,
narrow it at configure time (see the failsafe section) rather than editing the
header — health now decides whether the robot may arm, not just which LED
blinks.

---

## Current state

| Subsystem | State |
|---|---|
| Boot chain, XIP execution | ✅ working |
| 1 kHz loop | ✅ ~230 µs of a 1000 µs budget, zero overruns |
| Health LEDs, serial console | ✅ working |
| Failsafe, watchdog, command validation | ✅ host-tested, ⚠️ never exercised on a real fault |
| **IMU (BNO085)** | ✅ **working on hardware** — quaternions, gravity, gyro |
| Pi link, protocol v5 | ✅ C/Python verified, 1 kHz proven in test |
| Peripheral fault recovery | ✅ SPI stall, CAN bus-off, IMU error paths implemented |
| Drive lifecycle (arm / clear / idle) | ✅ implemented, ⚠️ never run against real ODrives |
| State estimator | ✅ wired in, ⚠️ never run on real sensor data |
| Encoders (SPI) | ⚠️ initialises, no hardware attached |
| CAN / ODrive | ⚠️ initialises, no hardware attached |

The IMU is the first external interface actually proven end to end. Encoders and
CAN still have never moved a byte of real data.

### Known issues

Only genuinely open items live here. Bugs that were found and fixed but that
CubeMX can silently undo are listed under
[Working with CubeMX](#working-with-cubemx) instead — they are hazards, not
outstanding work.

**`report()` stalls the control loop once a second.** The 1 Hz serial report
blocks setpoint transmission for tens of milliseconds. It is directly visible in
the counters — `tx=2000` in a normal second, `tx=402` in a second that also
dumps a capture — and as position discontinuities in the CSV at exactly the
report boundaries (gait t = 1.01, 2.01, 3.01 s for a run armed at t=3 s with a
2 s entry ramp). Harmless while tuning, not acceptable once the gait matters.
Gate it off while `s_gait_running`, or move printing off the control thread.

**Error-passive wedges the TX queue.** When the drives disarm and stop ACKing,
TX fills, `txfifo_free` hits 0 and every queued frame is dropped — `qdrop`
climbing 2000/s with `tx=0 rx=0` forever. `can_busoff_poll()` only recovered
from full bus-off, and error-passive is not bus-off. It now flushes the backlog
when error-passive coincides with a full FIFO, but that is a symptom fix: the
open question is why both drives fault with `err=0x08000200` after ~54 s of
holding a static pose. Read `odrv0.axis0.disarm_reason` in odrivetool — the
ODrive error-code documentation returns HTTP 403 and the numeric codes here have
never been decoded against an authoritative source.

**Accelerometer runs at ~158 Hz, not 400.** The gyro reaches 421 Hz but the
accelerometer — which drives the estimator's velocity and height — is starved by
the sensor's own scheduling (datasheet §6.9: sensors cannot all run at maximum
simultaneously). Dropping the quaternion from 400 Hz to 100 Hz made it *worse*
(216 → 158) and cut total throughput from 972 to 684 reports/s, which rules out
simple bandwidth saturation. Untested next steps, in order: `IMU_ENABLE_QUAT 0`,
requesting 800 Hz to exploit the `≤ 2.1 × requested` rule, and the Game Rotation
Vector (`0x08`, 6-axis, much cheaper — and better on a robot full of motor
magnets). 158 Hz is usable but below where it should be.

**A latched timing fault is cleared by the re-arm handshake.** `HEALTH_TIMING`
still latches — a missed deadline matters after the tick that missed it — but it
is now latched against an *acknowledged* overrun count rather than against zero.
Comparing to zero meant one missed tick locked the robot out for the rest of the
session, which also made the `FAULT → IDLE` recovery path dead code for the most
likely fault there is. `link.stand_down()` acknowledges it.

**The failsafe has never fired on hardware.** `safety.c` and `watchdog.c` are
covered by host tests (`tools/hosttest/run.sh`), which is not the same thing as
having watched a robot go limp when the USB cable was pulled. Before anything
walks: pull the cable mid-run and confirm the axes idle; stall the loop
deliberately and confirm the board resets and says so at the next boot.

**The command envelope is a placeholder.** `SAFETY_POS_MIN/MAX_TURNS` and
`SAFETY_MAX_STEP_TURNS` in `safety.h` are loose bounds chosen to catch garbage,
not this machine's real joint travel. They need measuring on the robot — a
limit that is wrong in the loose direction only fails to stop a sick robot,
which is why they start there rather than tight.

**The robot has never been measured.** The leg geometry now comes from the
URDF - but that URDF is an older design (hip roll as the parent), and the
per-joint signs and offsets and the spring encoder zeros in
`Appli/App/robot_config.h` are all placeholders. Until the real design is
exported and those are measured, forward kinematics is wrong by however wrong
they are.

The filter no longer trusts it blindly: while `ROBOT_CONFIG_CALIBRATED` is `0`
the estimator reports `CONVERGING` forever and never `OK`, however well its
covariance settles. A converged filter built on guessed geometry is
confidently wrong, and the covariance cannot tell you that. Measure the robot,
set the flag, and `fusion_usable` starts meaning something.

**External flash runs in 1-line mode, not octal.** SFDP init fails at step 11
(re-reading the SFDP header through the freshly configured octal mode) with
`EXTMEM_DRIVER_NOR_SFDP_MEMTYPE_CHECK`. 1-line works and is the current setting
(`NEXUS_EXTMEM_LINES` in `Boot/Core/Src/extmem_manager.c`), at roughly 1/8th the
instruction-fetch bandwidth. The loop runs in ~230 µs of its 1000 µs budget
*with* the estimator, so this costs nothing measurable today. If that margin
shrinks, move the hot path into ITCM (64 KB, 0% used) before spending time on
octal mode.

**CAN bandwidth needs attention before all 10 actuators run.** At 5 nodes per
bus with commands plus two telemetry messages each at 1 kHz, the bus sits near
75% load. Raising the *nominal* bitrate helps far more than the data bitrate,
because 8-byte frames are dominated by the arbitration phase. Also verify
whether your ODrive firmware supports CAN FD at all. Deferred deliberately —
4 nodes at 45% is fine, so this only blocks the second leg.

**No watchdog on the STM32.** A deliberate choice: ODrive's own watchdog is the
hardware-protecting layer, so a stalled STM32 stops the motors without needing
one here. Revisit only if something has to fail safe that the ODrives cannot
see.

### Resolved

For reference, since these were live problems during bring-up: the MPU/DMA
cache-coherency fault, the `MX_XSPI2_Init()` bus hang, the USB voltage detector
killing Boot, the 3-deep FDCAN TX FIFO silently dropping frames to nodes 4 and
5, the `imu_service()` infinite loop, the `Q̄` stack overflow in the estimator,
the USB TX buffer being overwritten mid-transfer, the pure-Python CRC that
could not sustain 1 kHz on a Pi, and the three BNO085 protocol bugs above. Each
has a guard, a counter, or a test so it cannot come back unnoticed.

The joint map is also settled: node 1 is hip_pitch, node 2 hip_roll, and node 5
was the waist before this two-leg build dropped it (see
[the joint map](#the-joint-map)). `robot_config.c` and
`build_reference()` had node 1 as hip_roll, taken from a comment in the gait
generator; both now name their indices with `NEXUS_J_*`.

---

## Working with CubeMX

CubeMX generates into its own project folder, which is not this repo. Generate
there, then pull the generated files back:

```bash
./sync_from_cubemx.sh
git diff --stat -- . ':!Drivers' ':!Middlewares'   # review before building
```

The script never touches `Appli/App/`, and warns if MPU region 2 came back
wrong. **Always review the diff before building** — a stale CubeMX folder can
silently revert fixes.

### Two fixes CubeMX will undo

Both of these are *fixed*. Both are also things CubeMX regenerates back to a
broken state, so check them after every generation.

**MPU region 2 must cover `0x24070000`, size 8 KB.** Every DMA buffer lives in
the `noncacheable_buffer` section there. If the MPU and the linker disagree,
the CPU reads stale cache while DMA writes real RAM — intermittent corruption
that looks exactly like bad wiring. The setting lives in the **Boot** context
of the .ioc (CORTEX_M7_BOOT → MPU Region 2).

*Guard:* `check_noncacheable_region()` in `app_init()` compares the linker
symbols against the MPU base at boot and halts with the red LED on if they
disagree, so this fails loudly instead of corrupting data.

**`MX_XSPI2_Init()` must stay commented out in the Appli**
(`Appli/Core/Src/main.c`). The Appli executes *from* XSPI2, so re-initialising
it destroys the memory mapping and the next instruction fetch hangs the bus —
no LED, no serial output, nothing.

*Guard:* none possible; the hang happens before any code could report it. This
one is on you to check in the diff.
