vismay5559/stm32_zeuss/tools/model/mukesh.urdf

<?xml version='1.0' encoding='utf-8'?>
<!--
  GENERATED by zeus_description/scripts/clean_urdf.py from
  urdf/mukesh_raw.urdf + config/mukesh_model.yaml. Do not edit: change the YAML
  (or re-export from Fusion) and run the script again.
-->
<robot name="mukesh">
  <!-- base_link: the robot's own frame, X forward / Y left / Z up, origin at the hip centre (added by clean_urdf.py) -->
  <link name="base_link" />
  <joint name="base_link_to_torso" type="fixed">
    <parent link="base_link" />
    <child link="torso" />
    <origin xyz="0.00362288116 -0.0156419404 -0.554034665" rpy="0 0 -1.57079633" />
  </joint>
  <link name="right_hip_pitch_motor">
    <inertial>
      <origin xyz="0.03456904275908428 0.02978114266894922 0.06556717497572401" rpy="0.0 -0.0 0.0" />
      <mass value="1.1584184502616546" />
      <inertia ixx="0.0018491221099442567" iyy="0.0018703105932066921" izz="0.0018386490945158512" ixy="-5.68675647884861e-06" iyz="2.114961905782132e-06" ixz="-5.425847140856643e-05" />
    </inertial>
    <visual name="Hip_pitch_infill_visual">
      <origin xyz="0.024865612163892693 0.02983569577483464 0.06713311362466598" rpy="1.155257860108296e-16 1.5707963267948957 0" />
      <geometry>
        <mesh filename="package://mukesh_description/meshes/Hip_pitch_infill.stl" scale="0.001 0.001 0.001" />
      </geometry>
    </visual>
    <collision name="Hip_pitch_infill_collision">
      <origin xyz="0.024865612163892693 0.02983569577483464 0.06713311362466598" rpy="1.155257860108296e-16 1.5707963267948957 0" />
      <geometry>
        <mesh filename="package://mukesh_description/meshes/Hip_pitch_infill.stl" scale="0.001 0.001 0.001" />
      </geometry>
    </collision>
  </link>
  <link name="right_knee_motor">
    <inertial>
      <origin xyz="0.007265756282420491 0.04206408724640368 0.1897169523138838" rpy="0.0 -0.0 0.0" />
      <mass value="1.2470692147083378" />
      <inertia ixx="0.011125467561025046" iyy="0.01084197322128748" izz="0.002568892327509836" ixy="2.6742025384184727e-05" iyz="0.0008048354155085341" ixz="-0.00039115874208493784" />
    </inertial>
    <visual name="knee_infill_8Sep_visual">
      <origin xyz="-0.002558939346153304 0.03865789238452935 0.23331153221143644" rpy="-1.5707963267949814 -0.6108652381980059 -1.5707963267948477" />
      <geometry>
        <mesh filename="package://mukesh_description/meshes/knee_infill_8Sep.stl" scale="0.001 0.001 0.001" />
      </geometry>
    </visual>
    <collision name="knee_infill_8Sep_collision">
      <origin xyz="-0.002558939346153304 0.03865789238452935 0.23331153221143644" rpy="-1.5707963267949814 -0.6108652381980059 -1.5707963267948477" />
      <geometry>
        <mesh filename="package://mukesh_description/meshes/knee_infill_8Sep.stl" scale="0.001 0.001 0.001" />
      </geometry>
    </collision>
  </link>
  <link name="right_hip_roll_motor">
    <inertial>
      <origin xyz="0.06482138586327356 -0.011780153165101512 -0.10606169304811004" rpy="0.0 -0.0 7.35276942609413e-49" />
      <mass value="0.8281614956933611" />
      <inertia ixx="0.003122673808543225" iyy="0.003465679570868241" izz="0.002120963276178317" ixy="-1.0325208370429752e-06" iyz="-0.00030205417550260654" ixz="6.042069593701542e-05" />
    </inertial>
    <visual name="hip_roll_acc_visual">
      <origin xyz="0.06494193800035385 0.04079577167802923 -0.13571763699505796" rpy="-1.5707963267949148 0.5235987755983496 -3.141592653589793" />
      <geometry>
        <mesh filename="package://mukesh_description/meshes/hip_roll_acc.stl" scale="0.001 0.001 0.001" />
      </geometry>
    </visual>
    <collision name="hip_roll_acc_collision">
      <origin xyz="0.06494193800035385 0.04079577167802923 -0.13571763699505796" rpy="-1.5707963267949148 0.5235987755983496 -3.141592653589793" />
      <geometry>
        <mesh filename="package://mukesh_description/meshes/hip_roll_acc.stl" scale="0.001 0.001 0.001" />
      </geometry>
    </collision>
  </link>
  <link name="right_foot">
    <inertial>
      <origin xyz="-2.6306134834896967e-08 -0.04629841835711845 -0.05015784551242702" rpy="0.0 -0.0 0.0" />
      <mass value="0.16677878130029922" />
      <inertia ixx="0.0007474148305536906" iyy="0.0003782420633559472" izz="0.000752529026462454" ixy="1.7811377443981786e-10" iyz="-0.0001428691031430979" ixz="-6.009994520279893e-11" />
    </inertial>
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
      <mass value="0.07298374635894124" />
      <inertia ixx="0.00013960461085593678" iyy="7.041030756173641e-05" izz="7.041030756158427e-05" ixy="-2.3716922523120042e-20" iyz="-5.855857248757146e-15" ixz="1.051063086836406e-18" />
    </inertial>
    <visual name="Hip_spring_visual">
      <origin xyz="0.05684509414294223 0.0014122925637813299 -0.0010519545968968914" rpy="1.1552578601085265e-16 1.5707963267948288 0" />
      <geometry>
        <mesh filename="package://mukesh_description/meshes/Hip_spring.stl" scale="0.001 0.001 0.001" />
      </geometry>
    </visual>
    <collision name="Hip_spring_collision">
      <origin xyz="0.05684509414294223 0.0014122925637813299 -0.0010519545968968914" rpy="1.1552578601085265e-16 1.5707963267948288 0" />
      <geometry>
        <mesh filename="package://mukesh_description/meshes/Hip_spring.stl" scale="0.001 0.001 0.001" />
      </geometry>
    </collision>
  </link>
  <link name="torso">
    <inertial>
      <origin xyz="-0.016294637141238407 -0.002526305638361926 0.7282086821810438" rpy="0.0 0.0 0.0" />
      <mass value="0.36856823233604175" />
      <inertia ixx="0.0009446333384916243" iyy="0.0017613051323293882" izz="0.001897868822193257" ixy="6.945929391524481e-06" iyz="4.585092255700015e-06" ixz="-2.5454254255174016e-06" />
    </inertial>
    <visual name="Base_link_visual">
      <origin xyz="0.0 0.0 0.0" rpy="0.0 0.0 0.0" />
      <geometry>
        <mesh filename="package://mukesh_description/meshes/Base_link.stl" scale="0.001 0.001 0.001" />
      </geometry>
    </visual>
    <collision name="Base_link_collision">
      <origin xyz="0.0 0.0 0.0" rpy="0.0 0.0 0.0" />
      <geometry>
        <mesh filename="package://mukesh_description/meshes/Base_link.stl" scale="0.001 0.001 0.001" />
      </geometry>
    </collision>
  </link>
  <link name="left_hip_pitch_motor">
    <inertial>
      <origin xyz="-0.03456904307224134 0.029781143019332046 0.06556717504111503" rpy="0.0 -0.0 0.0" />
      <mass value="1.1584184380489653" />
      <inertia ixx="0.0018491220492662386" iyy="0.0018703105892194927" izz="0.0018386490927787304" ixy="5.686735131419252e-06" iyz="2.1149623058622745e-06" ixz="5.425847000586903e-05" />
    </inertial>
    <visual name="Hip_pitch_infill_left_visual">
      <origin xyz="-0.02486561109957016 0.02983569577483464 0.06713311362476666" rpy="-1.1552578596774399e-16 1.5707963267938476 0" />
      <geometry>
        <mesh filename="package://mukesh_description/meshes/Hip_pitch_infill_left.stl" scale="0.001 0.001 0.001" />
      </geometry>
    </visual>
    <collision name="Hip_pitch_infill_left_collision">
      <origin xyz="-0.02486561109957016 0.02983569577483464 0.06713311362476666" rpy="-1.1552578596774399e-16 1.5707963267938476 0" />
      <geometry>
        <mesh filename="package://mukesh_description/meshes/Hip_pitch_infill_left.stl" scale="0.001 0.001 0.001" />
      </geometry>
    </collision>
  </link>
  <link name="left_knee_motor">
    <inertial>
      <origin xyz="-0.00726575700356209 -0.04206408796699456 -0.1897169506722385" rpy="0.0 -0.0 0.0" />
      <mass value="1.2470692431152313" />
      <inertia ixx="0.011125468108875408" iyy="0.010841973804519622" izz="0.0025688923961809315" ixy="2.6742038193024002e-05" iyz="0.0008048355665126014" ixz="-0.00039115871672184416" />
    </inertial>
    <visual name="knee_infill_8Sep_left_visual">
      <origin xyz="0.0025589404108638902 -0.038657892384527826 -0.2333115322115369" rpy="1.5707963267936973 0.6108652381980002 1.5707963267942089" />
      <geometry>
        <mesh filename="package://mukesh_description/meshes/knee_infill_8Sep_left.stl" scale="0.001 0.001 0.001" />
      </geometry>
    </visual>
    <collision name="knee_infill_8Sep_left_collision">
      <origin xyz="0.0025589404108638902 -0.038657892384527826 -0.2333115322115369" rpy="1.5707963267936973 0.6108652381980002 1.5707963267942089" />
      <geometry>
        <mesh filename="package://mukesh_description/meshes/knee_infill_8Sep_left.stl" scale="0.001 0.001 0.001" />
      </geometry>
    </collision>
  </link>
  <link name="left_hip_roll_motor">
    <inertial>
      <origin xyz="-0.0648213880904676 -0.011780127187206137 -0.10606171910010424" rpy="0.0 -0.0 0.0" />
      <mass value="0.8281617978653347" />
      <inertia ixx="0.0031226754043924276" iyy="0.0034656804672661135" izz="0.0021209642679238744" ixy="1.0327057597761205e-06" iyz="-0.0003020541993746648" ixz="-6.042056948742157e-05" />
    </inertial>
    <visual name="hip_roll_acc_left_visual">
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
      </geometry>
    </collision>
  </link>
  <link name="left_knee_spring">
    <inertial>
      <origin xyz="0.0049999952136517666 4.734762265035109e-09 2.0850443860354064e-09" rpy="0.0 -0.0 0.0" />
      <mass value="0.0739166444341313" />
      <inertia ixx="0.0001396804333701259" iyy="7.045618871649121e-05" izz="7.045618872752034e-05" ixy="-5.141489989833369e-19" iyz="-2.1713283027049343e-15" ixz="-6.827157978232877e-17" />
    </inertial>
    <visual name="knee-spring_left_visual">
      <origin xyz="-0.04707326127936849 0.15460402291607622 0.22079742248506698" rpy="-1.5707963267960763 -0.6108652381979999 -1.5707963267942124" />
      <geometry>
        <mesh filename="package://mukesh_description/meshes/knee-spring_left.stl" scale="0.001 0.001 0.001" />
      </geometry>
    </visual>
    <collision name="knee-spring_left_collision">
      <origin xyz="-0.04707326127936849 0.15460402291607622 0.22079742248506698" rpy="-1.5707963267960763 -0.6108652381979999 -1.5707963267942124" />
      <geometry>
        <mesh filename="package://mukesh_description/meshes/knee-spring_left.stl" scale="0.001 0.001 0.001" />
      </geometry>
    </collision>
  </link>
  <link name="left_hip_spring">
    <inertial>
      <origin xyz="0.004977419928626956 -3.211053246077178e-09 3.527165048922143e-09" rpy="0.0 -0.0 6.333638866564571e-49" />
      <mass value="0.072983746358941" />
      <inertia ixx="0.0001396046108582301" iyy="7.04103075605915e-05" izz="7.041030756501702e-05" ixy="2.710505431216238e-20" iyz="-5.856426454897702e-15" ixz="-7.239156603638207e-17" />
    </inertial>
    <visual name="Hip_spring_left_visual">
      <origin xyz="-0.056845093078620595 0.0014122925637813299 -0.001051954596791802" rpy="-1.1552578596808004e-16 1.5707963267939147 0" />
      <geometry>
        <mesh filename="package://mukesh_description/meshes/Hip_spring_left.stl" scale="0.001 0.001 0.001" />
      </geometry>
    </visual>
    <collision name="Hip_spring_left_collision">
      <origin xyz="-0.056845093078620595 0.0014122925637813299 -0.001051954596791802" rpy="-1.1552578596808004e-16 1.5707963267939147 0" />
      <geometry>
        <mesh filename="package://mukesh_description/meshes/Hip_spring_left.stl" scale="0.001 0.001 0.001" />
      </geometry>
    </collision>
  </link>
  <joint name="right_ankle_roll" type="revolute">
    <origin xyz="-0.047275730000000016 0.045700000000000005 -0.1192521" rpy="0.0 -7.664552802699262e-31 0.0" />
    <parent link="right_ankle_roll_link" />
    <child link="right_foot" />
    <axis xyz="0 1 0" />
    <limit lower="-0.4363" upper="0.4363" effort="25" velocity="20" />
  </joint>
  <joint name="right_ankle_pitch" type="revolute">
    <origin xyz="0.11677325000000066 0.0014999999999962621 -0.20571883000000007" rpy="-1.8138268664813416e-14 -7.328966229190266e-30 -5.551115123125783e-17" />
    <parent link="right_ankle_motor" />
    <child link="right_ankle_roll_link" />
    <axis xyz="-1 0 0" />
    <limit lower="-0.7854" upper="0.7854" effort="25" velocity="20" />
  </joint>
  <joint name="right_knee_pitch" type="revolute">
    <origin xyz="-0.05519955000000001 0.03864847 0.23289448999999995" rpy="3.4203554409882275e-16 -4.7331654313260694e-30 -7.467618333433368e-60" />
    <parent link="right_knee_motor" />
    <child link="right_knee_spring" />
    <axis xyz="-1 0 0" />
    <limit lower="-0.7854" upper="0.7854" effort="25" velocity="20" />
  </joint>
  <joint name="right_knee_pitch_spring" type="revolute">
    <origin xyz="-0.01 0.0 0.0" rpy="-3.1415926535897754 -1.8986786814935056e-32 -5.551115123125783e-17" />
    <parent link="right_knee_spring" />
    <child link="right_ankle_motor" />
    <axis xyz="-1 0 0" />
    <limit lower="-0.7854" upper="0.7854" effort="25" velocity="20" />
  </joint>
  <joint name="right_hip_roll" type="revolute">
    <origin xyz="0.06494193999999098 0.040795770000000016 -0.13571763999999994" rpy="-3.141592653589793 -1.1044052673094165e-29 -2.4651903288157894e-32" />
    <parent link="right_hip_roll_motor" />
    <child link="right_knee_motor" />
    <axis xyz="0 -1 0" />
    <limit lower="-0.7854" upper="0.7854" effort="25" velocity="20" />
  </joint>
  <joint name="right_hip_pitch" type="revolute">
    <origin xyz="-0.027775000000000005 0.03018272 0.06736460000000008" rpy="3.420355440988056e-16 1.9721522630525295e-31 -2.465190328815662e-32" />
    <parent link="right_hip_pitch_motor" />
    <child link="right_hip_spring" />
    <axis xyz="-1 0 0" />
    <limit lower="-0.7854" upper="0.7854" effort="25" velocity="20" />
  </joint>
  <joint name="right_hip_pitch_spring" type="revolute">
    <origin xyz="-0.009999999999999998 0.0 0.0" rpy="3.1415926535897927 -1.2818989709841442e-29 4.382781368483947e-45" />
    <parent link="right_hip_spring" />
    <child link="right_hip_roll_motor" />
    <axis xyz="-1 0 0" />
    <limit lower="-0.7854" upper="0.7854" effort="25" velocity="20" />
  </joint>
  <joint name="torso_to_right_hip_pitch_motor" type="fixed">
    <origin xyz="0.05538966460621691 0.026559838843506576 0.6892580848195441" rpy="3.141592653589793 -1.3877787807814457e-17 5.494754727018656e-35" />
    <parent link="torso" />
    <child link="right_hip_pitch_motor" />
  </joint>
  <joint name="left_ankle_roll" type="revolute">
    <origin xyz="0.047275729999999586 -0.04569999999999998 0.1192521" rpy="-1.9428902930940195e-16 5.759229495684072e-32 -2.0194839173657902e-28" />
    <parent link="left_ankle_roll_link" />
    <child link="left_foot" />
    <axis xyz="0 -1 0" />
    <limit lower="-0.4363" upper="0.4363" effort="25" velocity="20" />
  </joint>
  <joint name="left_ankle_pitch" type="revolute">
    <origin xyz="-0.11677326000000067 0.0015000000000037251 -0.20571883" rpy="-3.141592653589775 -1.0190019061567152e-28 5.551115123125783e-17" />
    <parent link="left_ankle_motor" />
    <child link="left_ankle_roll_link" />
    <axis xyz="-1 0 0" />
    <limit lower="-0.7854" upper="0.7854" effort="25" velocity="20" />
  </joint>
  <joint name="left_knee_pitch" type="revolute">
    <origin xyz="0.055199559999999995 -0.03864847 -0.23289449" rpy="3.141592653589793 -0.0 0.0" />
    <parent link="left_knee_motor" />
    <child link="left_knee_spring" />
    <axis xyz="-1 0 0" />
    <limit lower="-0.7854" upper="0.7854" effort="25" velocity="20" />
  </joint>
  <joint name="left_knee_pitch_spring" type="revolute">
    <origin xyz="0.01 0.0 0.0" rpy="3.1415926535897754 -1.0099318265510444e-28 5.551115123125783e-17" />
    <parent link="left_knee_spring" />
    <child link="left_ankle_motor" />
    <axis xyz="-1 0 0" />
    <limit lower="-0.7854" upper="0.7854" effort="25" velocity="20" />
  </joint>
  <joint name="left_hip_roll" type="revolute">
    <origin xyz="-0.06494193999999096 0.04079576999999999 -0.13571763999999994" rpy="-1.1541736579355972e-16 -2.84525773931663e-48 -2.465190328815662e-32" />
    <parent link="left_hip_roll_motor" />
    <child link="left_knee_motor" />
    <axis xyz="0 1 0" />
    <limit lower="-0.7854" upper="0.7854" effort="25" velocity="20" />
  </joint>
  <joint name="left_hip_pitch" type="revolute">
    <origin xyz="0.027775000000000008 0.03018272 0.06736460000000008" rpy="-3.420355440988056e-16 -2.0194839173657902e-28 -2.465190328815662e-32" />
    <parent link="left_hip_pitch_motor" />
    <child link="left_hip_spring" />
    <axis xyz="-1 0 0" />
    <limit lower="-0.7854" upper="0.7854" effort="25" velocity="20" />
  </joint>
  <joint name="left_hip_pitch_spring" type="revolute">
    <origin xyz="0.01 0.0 0.0" rpy="-3.1415926535897927 2.0194839173657902e-28 6.90741614113862e-44" />
    <parent link="left_hip_spring" />
    <child link="left_hip_roll_motor" />
    <axis xyz="-1 0 0" />
    <limit lower="-0.7854" upper="0.7854" effort="25" velocity="20" />
  </joint>
  <joint name="torso_to_left_hip_pitch_motor" type="fixed">
    <origin xyz="-0.08667354539378307 0.026559838843506576 0.6892580848195441" rpy="3.141592653589793 -1.3877787807814457e-17 5.494754727018656e-35" />
    <parent link="torso" />
    <child link="left_hip_pitch_motor" />
  </joint>
  <!-- imu_link: the IMU chip, axes as mounted (added by clean_urdf.py) -->
  <link name="imu_link" />
  <joint name="torso_to_imu_link" type="fixed">
    <parent link="torso" />
    <child link="imu_link" />
    <origin xyz="-0.0156419404 -0.00342288116 0.794334665" rpy="0 0 1.57079633" />
  </joint>
  <!-- left_contact: contact switch point on the sole (added by clean_urdf.py) -->
  <link name="left_contact" />
  <joint name="left_foot_to_left_contact" type="fixed">
    <parent link="left_foot" />
    <child link="left_contact" />
    <origin xyz="-3.48500001e-06 0.0650473 0.07997576" rpy="-3.14159265 0 -1.57079633" />
  </joint>
  <!-- right_contact: contact switch point on the sole (added by clean_urdf.py) -->
  <link name="right_contact" />
  <joint name="right_foot_to_right_contact" type="fixed">
    <parent link="right_foot" />
    <child link="right_contact" />
    <origin xyz="3.48500001e-06 -0.0650473 -0.07997576" rpy="0 0 1.57079633" />
  </joint>
</robot>
