vismay5559/stm32_zeuss/tools/model/zeus.urdf

<?xml version='1.0' encoding='utf-8'?>
<!--
  GENERATED by zeus_description/scripts/clean_urdf.py from
  urdf/zeus_raw.urdf + config/zeus_model.yaml. Do not edit: change the YAML
  (or re-export from Fusion) and run the script again.
-->
<robot name="zeus">
  <!-- base_link: the robot's own frame, X forward / Y left / Z up, origin at the hip centre (added by clean_urdf.py) -->
  <link name="base_link" />
  <joint name="base_link_to_torso" type="fixed">
    <parent link="base_link" />
    <child link="torso" />
    <origin xyz="0.00361362116 -0.0168814148 -0.554005521" rpy="0 0 -1.57079633" />
  </joint>
  <link name="right_knee_bracket">
    <inertial>
      <origin xyz="-0.05256485378108973 -3.149811705671357e-06 0.06426097779759125" rpy="0.0 -0.0 0.0" />
      <mass value="0.26171359081742096" />
      <inertia ixx="0.001196914978362476" iyy="0.0017501326565231446" izz="0.0010754153665700275" ixy="-1.4104953642034843e-07" iyz="9.202998216265219e-09" ixz="8.98481223465422e-05" />
    </inertial>
    <visual name="knee_brackett_right_visual">
      <origin xyz="-0.0008604665059515782 -3.3166370208559394e-09 0.10360900149014901" rpy="3.141592653589793 1.5707963267948934 0" />
      <geometry>
        <mesh filename="package://zeus_description/meshes/knee_brackett_right.stl" scale="0.001 0.001 0.001" />
      </geometry>
    </visual>
    <collision name="knee_brackett_right_collision">
      <origin xyz="-0.0008604665059515782 -3.3166370208559394e-09 0.10360900149014901" rpy="3.141592653589793 1.5707963267948934 0" />
      <geometry>
        <mesh filename="package://zeus_description/meshes/knee_brackett_right.stl" scale="0.001 0.001 0.001" />
      </geometry>
    </collision>
  </link>
  <link name="right_hip_roll_bracket">
    <inertial>
      <origin xyz="2.1558507816106242e-05 0.05396323849478971 0.033302675126960536" rpy="0.0 -0.0 -8.75111523449223e-62" />
      <mass value="0.2593953363423353" />
      <inertia ixx="0.0012116651716644125" iyy="0.0008809578670448889" izz="0.0009830528781121337" ixy="9.149317111472296e-07" iyz="2.255914197063784e-05" ixz="4.492542478098925e-07" />
    </inertial>
    <visual name="Hip_roll_bracket_right_visual">
      <origin xyz="0.027302786834384724 0.0466578939249336 0.5925909131567779" rpy="3.141592653589793 -6.044427111606684e-16 -3.14159265358979" />
      <geometry>
        <mesh filename="package://zeus_description/meshes/Hip_roll_bracket_right.stl" scale="0.001 0.001 0.001" />
      </geometry>
    </visual>
    <collision name="Hip_roll_bracket_right_collision">
      <origin xyz="0.027302786834384724 0.0466578939249336 0.5925909131567779" rpy="3.141592653589793 -6.044427111606684e-16 -3.14159265358979" />
      <geometry>
        <mesh filename="package://zeus_description/meshes/Hip_roll_bracket_right.stl" scale="0.001 0.001 0.001" />
      </geometry>
    </collision>
  </link>
  <link name="right_hip_bracket">
    <inertial>
      <origin xyz="-0.03293981954018783 0.00015759639410574066 -0.06582626072805756" rpy="-9.62964972193618e-35 -0.0 0.0" />
      <mass value="0.21747775977773756" />
      <inertia ixx="0.0012284760846418736" iyy="0.0012369196029320957" izz="0.0005353194999079408" ixy="5.869520130103197e-08" iyz="1.4538074574437165e-06" ixz="-5.992150715590263e-05" />
    </inertial>
    <visual name="hip_pitch_bracket_right_visual">
      <origin xyz="0.08469944447019423 0.00023770291138055567 -0.1085530277016767" rpy="1.8119798119491355 -1.568486938211107 -1.8120480759686135" />
      <geometry>
        <mesh filename="package://zeus_description/meshes/hip_pitch_bracket_right.stl" scale="0.001 0.001 0.001" />
      </geometry>
    </visual>
    <collision name="hip_pitch_bracket_right_collision">
      <origin xyz="0.08469944447019423 0.00023770291138055567 -0.1085530277016767" rpy="1.8119798119491355 -1.568486938211107 -1.8120480759686135" />
      <geometry>
        <mesh filename="package://zeus_description/meshes/hip_pitch_bracket_right.stl" scale="0.001 0.001 0.001" />
      </geometry>
    </collision>
  </link>
  <link name="right_hip_pitch_motor">
    <inertial>
      <origin xyz="0.03928255350081677 0.029814265792568923 0.06585254742989022" rpy="0.0 -0.0 0.0" />
      <mass value="1.0900294146990857" />
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
      </geometry>
    </visual>
    <collision name="Hip_spring_right_collision">
      <origin xyz="-0.09253514425490007 -0.0002132616737633175 0.08496046477788007" rpy="6.764536231126105e-05 -0.0005517547585711702 0.002242508155593942" />
      <geometry>
        <mesh filename="package://zeus_description/meshes/Hip_spring_right.stl" scale="0.001 0.001 0.001" />
      </geometry>
    </collision>
  </link>
  <link name="torso">
    <inertial>
      <origin xyz="-0.01696868129587851 -0.0045012483667503985 0.7240327946635936" rpy="0.0 0.0 0.0" />
      <mass value="0.6724614837537145" />
      <inertia ixx="0.0016511459371600392" iyy="0.002998882325778899" izz="0.003363076393926532" ixy="-1.0588745331162356e-05" iyz="-2.512543084449906e-06" ixz="-5.640847953746351e-06" />
    </inertial>
    <visual name="base_link_visual">
      <origin xyz="0.0 0.0 0.0" rpy="0.0 0.0 0.0" />
      <geometry>
        <mesh filename="package://zeus_description/meshes/base_link.stl" scale="0.001 0.001 0.001" />
      </geometry>
    </visual>
    <collision name="base_link_collision">
      <origin xyz="0.0 0.0 0.0" rpy="0.0 0.0 0.0" />
      <geometry>
        <mesh filename="package://zeus_description/meshes/base_link.stl" scale="0.001 0.001 0.001" />
      </geometry>
    </collision>
  </link>
  <link name="imu_mount">
    <inertial>
      <origin xyz="0.010137012072420331 0.008916714051471306 0.0008312090498193925" rpy="0.0 -0.0 0.0" />
      <mass value="0.00700316929217391" />
      <inertia ixx="2.895397703092834e-07" iyy="3.633586524846332e-07" izz="6.497205128027939e-07" ixy="-1.4451616085406837e-10" iyz="-1.9805048758343396e-11" ixz="-1.9868633725306305e-10" />
    </inertial>
    <visual name="IMU-1_visual">
      <origin xyz="0.025308752553300857 0.3874060614453174 -0.6805675425530986" rpy="6.764536231128467e-05 -0.0005517547585709898 0.0022425081555938263" />
      <geometry>
        <mesh filename="package://zeus_description/meshes/IMU-1.stl" scale="0.001 0.001 0.001" />
      </geometry>
    </visual>
    <collision name="IMU-1_collision">
      <origin xyz="0.025308752553300857 0.3874060614453174 -0.6805675425530986" rpy="6.764536231128467e-05 -0.0005517547585709898 0.0022425081555938263" />
      <geometry>
        <mesh filename="package://zeus_description/meshes/IMU-1.stl" scale="0.001 0.001 0.001" />
      </geometry>
    </collision>
  </link>
  <joint name="right_hip_pitch" type="revolute">
    <origin xyz="-0.026670080000000002 0.03023804000000001 0.06738140999999999" rpy="5.580160412282723e-19 1.0842021724855044e-19 -1.2763065979448198e-19" />
    <parent link="right_hip_pitch_motor" />
    <child link="right_hip_spring" />
    <axis xyz="-0.999997333 0.00224250593 0.000551754731" />
    <limit lower="-0.7854" upper="0.7854" effort="25" velocity="20" />
  </joint>
  <joint name="right_hip_pitch_spring" type="revolute">
    <origin xyz="-0.01649996 3.699999999999981e-05 9.110000000021046e-06" rpy="3.141592653589793 1.5707963267948966 0" />
    <parent link="right_hip_spring" />
    <child link="right_hip_bracket" />
    <axis xyz="-0.000551754731 -0.00224250593 0.999997333" />
    <limit lower="-0.7854" upper="0.7854" effort="25" velocity="20" />
  </joint>
  <joint name="right_hip_roll" type="revolute">
    <origin xyz="-0.06254649000000008 -0.026193479999999995 -0.0201" rpy="1.9721522630525295e-31 -1.5707963267948966 0" />
    <parent link="right_hip_roll_motor" />
    <child link="right_hip_roll_bracket" />
    <axis xyz="-0.00224254359 -0.999997483 -6.7645352e-05" />
    <limit lower="-0.7854" upper="0.7854" effort="25" velocity="20" />
  </joint>
  <joint name="right_knee_pitch" type="revolute">
    <origin xyz="-0.05464062 -9.409999999999974e-06 0.060582960000000026" rpy="-2.4805977683707598e-31 -6.401791135143172e-31 -1.9311058811127647e-31" />
    <parent link="right_knee_motor" />
    <child link="right_knee_spring" />
    <axis xyz="-0.999997333 0.00224250593 0.000551754731" />
    <limit lower="-0.7854" upper="0.7854" effort="25" velocity="20" />
  </joint>
  <joint name="right_knee_pitch_spring" type="revolute">
    <origin xyz="-0.014999999999999998 0.0 0.0" rpy="1.4791141972893971e-31 1.5707963267948966 0" />
    <parent link="right_knee_spring" />
    <child link="right_knee_bracket" />
    <axis xyz="-0.000551754731 0.00224250593 -0.999997333" />
    <limit lower="-0.7854" upper="0.7854" effort="25" velocity="20" />
  </joint>
  <joint name="right_ankle_pitch" type="revolute">
    <origin xyz="0.0385 0.0 0.048" rpy="-3.141592653589793 -4.690812175909376e-31 8.154403576970184e-32" />
    <parent link="right_ankle_motor" />
    <child link="right_foot" />
    <axis xyz="-0.999997333 -0.00224250593 -0.000551754731" />
    <limit lower="-0.7854" upper="0.7854" effort="25" velocity="20" />
  </joint>
  <joint name="left_hip_pitch" type="revolute">
    <origin xyz="0.026879780000000013 0.030117960000000013 0.06735187000000004" rpy="-3.141592653589793 -0.0 -1.1407813263841318e-19" />
    <parent link="left_hip_pitch_motor" />
    <child link="left_hip_spring" />
    <axis xyz="-0.999997333 -0.00224250593 -0.000551754731" />
    <limit lower="-0.7854" upper="0.7854" effort="25" velocity="20" />
  </joint>
  <joint name="left_hip_pitch_spring" type="revolute">
    <origin xyz="0.016499949999999996 3.7000000000000364e-05 9.110000000021046e-06" rpy="-3.141592653589793 -1.5707963267948966 0" />
    <parent link="left_hip_spring" />
    <child link="left_hip_bracket" />
    <axis xyz="-0.000551754731 0.00224250593 -0.999997333" />
    <limit lower="-0.7854" upper="0.7854" effort="25" velocity="20" />
  </joint>
  <joint name="left_hip_roll" type="revolute">
    <origin xyz="-0.06300986000000008 0.02640298 -0.020051319999999997" rpy="1.2493735972000932e-19 1.5707963267948966 0" />
    <parent link="left_hip_roll_motor" />
    <child link="left_hip_roll_bracket" />
    <axis xyz="-0.00224254359 0.999997483 6.7645352e-05" />
    <limit lower="-0.7854" upper="0.7854" effort="25" velocity="20" />
  </joint>
  <joint name="left_knee_pitch" type="revolute">
    <origin xyz="0.05470685000000112 -0.00025463000000113504 0.06052262000000003" rpy="-3.1415926535897745 -2.0866038768906402e-30 1.112927950723139e-16" />
    <parent link="left_knee_motor" />
    <child link="left_knee_spring" />
    <axis xyz="-0.999997333 -0.00224250593 -0.000551754731" />
    <limit lower="-0.7854" upper="0.7854" effort="25" velocity="20" />
  </joint>
  <joint name="left_knee_pitch_spring" type="revolute">
    <origin xyz="0.014999840000000014 6.727000000000206e-05 1.6549999999959653e-05" rpy="-3.141592653589793 -1.5707963267948966 0" />
    <parent link="left_knee_spring" />
    <child link="left_knee_bracket" />
    <axis xyz="-0.000551754731 0.00224250593 -0.999997333" />
    <limit lower="-0.7854" upper="0.7854" effort="25" velocity="20" />
  </joint>
  <joint name="left_ankle_pitch" type="revolute">
    <origin xyz="-0.038446619999999994 0.0001725500000000002 0.04804246" rpy="-2.1599340154984659e-19 -2.2171418266626333e-19 -2.130031436354674e-19" />
    <parent link="left_ankle_motor" />
    <child link="left_foot" />
    <axis xyz="-0.999997333 0.00224250593 0.000551754731" />
    <limit lower="-0.7854" upper="0.7854" effort="25" velocity="20" />
  </joint>
  <joint name="right_hip_bracket_to_right_hip_roll_motor" type="fixed">
    <origin xyz="-0.07312906000000012 0.018203900000000002 -0.08869976999999998" rpy="-3.141592653589793 6.07576109200659e-39 -1.3552527156068808e-20" />
    <parent link="right_hip_bracket" />
    <child link="right_hip_roll_motor" />
  </joint>
  <joint name="left_hip_bracket_to_left_hip_roll_motor" type="fixed">
    <origin xyz="-0.07286658000000017 -0.017805650000000003 -0.08888396" rpy="-3.141592653589793 1.2037062152420227e-35 -1.3552527156068808e-20" />
    <parent link="left_hip_bracket" />
    <child link="left_hip_roll_motor" />
  </joint>
  <joint name="right_hip_roll_bracket_to_right_knee_motor" type="fixed">
    <origin xyz="0.0004410700000000034 0.03865789000000001 0.17581153000000002" rpy="1.9721522630525295e-31 -3.4512664603419266e-31 5.551115123125802e-17" />
    <parent link="right_hip_roll_bracket" />
    <child link="right_knee_motor" />
  </joint>
  <joint name="left_hip_roll_bracket_to_left_knee_motor" type="fixed">
    <origin xyz="-7.367000000000346e-05 -0.038659050000000014 -0.1758100700000001" rpy="3.1415926535897745 -1.0011929436545832e-18 2.704926097982091e-19" />
    <parent link="left_hip_roll_bracket" />
    <child link="left_knee_motor" />
  </joint>
  <joint name="right_knee_bracket_to_right_ankle_motor" type="fixed">
    <origin xyz="-0.22240434999999997 -1.2490009027033011e-17 0.06958225999999999" rpy="5.551115123125783e-17 -1.5707963267948966 0" />
    <parent link="right_knee_bracket" />
    <child link="right_ankle_motor" />
  </joint>
  <joint name="left_knee_bracket_to_left_ankle_motor" type="fixed">
    <origin xyz="-0.22248103 0.0003116700000000125 -0.06936809000000001" rpy="-5.55107277147842e-17 -1.5707963267948963 0" />
    <parent link="left_knee_bracket" />
    <child link="left_ankle_motor" />
  </joint>
  <joint name="torso_to_right_hip_pitch_motor" type="fixed">
    <origin xyz="0.05309447999821324 0.026587670011303938 0.6892580900028281" rpy="3.141523771073645 0.0005516016747925701 -0.0022425458152757066" />
    <parent link="torso" />
    <child link="right_hip_pitch_motor" />
  </joint>
  <joint name="torso_to_left_hip_pitch_motor" type="fixed">
    <origin xyz="-0.0866735451213116 0.026559840567045447 0.6892580895544036" rpy="3.141523771073645 0.0005516016747925701 -0.0022425458152757066" />
    <parent link="torso" />
    <child link="left_hip_pitch_motor" />
  </joint>
  <joint name="torso_to_imu_mount" type="fixed">
    <origin xyz="-0.025821939089959448 -0.012322293212967468 0.6806080832520717" rpy="-6.888251614786907e-05 0.0005516016747925701 -0.0022425458152757066" />
    <parent link="torso" />
    <child link="imu_mount" />
  </joint>
  <!-- imu_link: the IMU chip, axes as mounted (added by clean_urdf.py) -->
  <link name="imu_link" />
  <joint name="torso_to_imu_link" type="fixed">
    <parent link="torso" />
    <child link="imu_link" />
    <origin xyz="-0.0155814148 -0.00361362116 0.681405521" rpy="0 0 1.57079633" />
  </joint>
  <!-- left_contact: contact switch point on the sole (added by clean_urdf.py) -->
  <link name="left_contact" />
  <joint name="left_foot_to_left_contact" type="fixed">
    <parent link="left_foot" />
    <child link="left_contact" />
    <origin xyz="0.0328232312 -0.00010520166 0.0900125516" rpy="3.1410409 6.7645352e-05 -1.57303887" />
  </joint>
  <!-- right_contact: contact switch point on the sole (added by clean_urdf.py) -->
  <link name="right_contact" />
  <joint name="right_foot_to_right_contact" type="fixed">
    <parent link="right_foot" />
    <child link="right_contact" />
    <origin xyz="-0.032691938 4.98163595e-05 -0.0901720268" rpy="-0.00055175476 -6.7645352e-05 1.57303887" />
  </joint>
</robot>
