vismay5559/stm32_zeuss/Appli/Core/Src/main.c

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
/* Includes ------------------------------------------------------------------*/
#include "main.h"
#include "usb_device.h"

/* USER CODE BEGIN Includes */
#include "console.h"
#include "app.h"
#include "nexus_mode.h"
#include "test_leg_can.h"
#include "test_leg_torque.h"
#include "test_imu.h"
#include "test_can_scan.h"
#include "test_enc_scan.h"
#include "test_can_cfg.h"
#include "imu_bno085.h"
#include "enc_as5047p.h"
#include "act_odrive.h"
/* USER CODE END Includes */

/* USER CODE BEGIN PD */

/* Print each peripheral as it initialises. Bring-up aid; see the call site. */
#ifndef NEXUS_TRACE_PERIPHERAL_INIT
#define NEXUS_TRACE_PERIPHERAL_INIT  0
#endif

/* USER CODE END PD */


COM_InitTypeDef BspCOMInit;

FDCAN_HandleTypeDef hfdcan1;
FDCAN_HandleTypeDef hfdcan2;

SPI_HandleTypeDef hspi1;
DMA_HandleTypeDef handle_GPDMA1_Channel1;
DMA_HandleTypeDef handle_GPDMA1_Channel0;

TIM_HandleTypeDef htim2;
TIM_HandleTypeDef htim6;

UART_HandleTypeDef huart2;
DMA_HandleTypeDef handle_GPDMA1_Channel3;
DMA_NodeTypeDef Node_GPDMA1_Channel2 __attribute__((section("noncacheable_buffer")));
DMA_QListTypeDef List_GPDMA1_Channel2;
DMA_HandleTypeDef handle_GPDMA1_Channel2;


static void MX_GPIO_Init(void);
static void MX_GPDMA1_Init(void);
static void MX_FDCAN1_Init(void);
static void MX_FDCAN2_Init(void);
static void MX_SPI1_Init(void);
static void MX_USART2_UART_Init(void);
static void MX_TIM2_Init(void);
static void MX_TIM6_Init(void);
/**
  * @brief  The application entry point.
  * @retval int
  */
int main(void)
{

  /* Enable the CPU Cache */

  /* Enable I-Cache---------------------------------------------------------*/
  SCB_EnableICache();

  /* Enable D-Cache---------------------------------------------------------*/
  SCB_EnableDCache();

  /* MCU Configuration--------------------------------------------------------*/

  /* Update SystemCoreClock variable according to RCC registers values. */
  SystemCoreClockUpdate();

  /* Reset of all peripherals, Initializes the Flash interface and the Systick. */
  HAL_Init();

  /* USER CODE BEGIN SysInit */
  /* Serial up early so the Appli can report progress on the ST-LINK VCOM
     (115200 8N1), same channel Boot uses. */
  BspCOMInit.BaudRate   = 115200;
  BspCOMInit.WordLength = COM_WORDLENGTH_8B;
  BspCOMInit.StopBits   = COM_STOPBITS_1;
  BspCOMInit.Parity     = COM_PARITY_NONE;
  BspCOMInit.HwFlowCtl  = COM_HWCONTROL_NONE;
  (void)BSP_COM_Init(COM1, &BspCOMInit);
  console_init();      /* printf stops blocking from here on */

  printf("\r\n>>> APPLI running from XIP at 0x70000000 <<<\r\n");
  printf("APPLI: starting peripheral init\r\n");
  /* USER CODE END SysInit */

  /* Initialize all configured peripherals */
  /*
   * Per-peripheral tracing: whichever line prints last is the one that hung.
   * Invaluable while a peripheral is still capable of wedging the boot, and
   * pure noise once it is not - so it is a switch rather than something to
   * remember to delete. The Appli boots cleanly now, hence off by default.
   */
#if NEXUS_TRACE_PERIPHERAL_INIT
#define MX_TRACE(name)  printf("  " name "...\r\n")
#else
#define MX_TRACE(name)  ((void)0)
#endif

  MX_TRACE("GPIO");    MX_GPIO_Init();
  MX_TRACE("GPDMA1");  MX_GPDMA1_Init();
  MX_TRACE("FDCAN1");  MX_FDCAN1_Init();
  MX_TRACE("FDCAN2");  MX_FDCAN2_Init();
  MX_TRACE("SPI1");    MX_SPI1_Init();
  MX_TRACE("USART2");  MX_USART2_UART_Init();
  MX_TRACE("TIM2");    MX_TIM2_Init();
  MX_TRACE("TIM6");    MX_TIM6_Init();
  MX_TRACE("USB");     MX_USB_DEVICE_Init();
  /*
   * XSPI2 is deliberately NOT initialised here.
   *
   * This application executes in place from the external flash behind XSPI2.
   * Boot configures that peripheral and puts it into memory-mapped mode before
   * jumping here; re-initialising it from code being fetched through it tears
   * down the mapping and the next instruction fetch hangs the bus forever -
   * no crash, no fault, just a frozen CPU the debugger cannot even attach to.
   *
   * XSPI2 has now been removed from the Appli context in the .ioc, so CubeMX
   * no longer generates the call at all. Previously it regenerated every time
   * and had to be commented out by hand.
   */
  
  /* USER CODE BEGIN 2 */
#if (NEXUS_MODE == NEXUS_MODE_LEG_TORQUE)
  printf("APPLI: mode = LEG_TORQUE (STM32-side PD -> Set_Input_Torque)\r\n");
  legtorque_init();
#elif (NEXUS_MODE == NEXUS_MODE_LEG_CAN)
  printf("APPLI: mode = LEG_CAN (CAN-FD single leg test)\r\n");
  legtest_init();
#elif (NEXUS_MODE == NEXUS_MODE_IMU)
  printf("APPLI: mode = IMU (BNO085 test)\r\n");
  imutest_init();
#elif (NEXUS_MODE == NEXUS_MODE_CAN_SCAN)
  printf("APPLI: mode = CAN_SCAN (both buses, no commands)\r\n");
  canscan_init();
#elif (NEXUS_MODE == NEXUS_MODE_ENC_SCAN)
  printf("APPLI: mode = ENC_SCAN (four spring encoders, no commands)\r\n");
  encscan_init();
#elif (NEXUS_MODE == NEXUS_MODE_CAN_CFG)
  printf("APPLI: mode = CAN_CFG (reads/sets ODrive CAN rates, never arms)\r\n");
  cancfg_init();
#else
  printf("APPLI: peripheral init done, entering app_init()\r\n");
  app_init();
  printf("APPLI: app_init() done\r\n");
#endif
  /* USER CODE END 2 */

  /* Initialize leds */
  BSP_LED_Init(LED_GREEN);
  BSP_LED_Init(LED_YELLOW);
  BSP_LED_Init(LED_RED);

  /* Initialize USER push-button, will be used to trigger an interrupt each time it's pressed.*/
  BSP_PB_Init(BUTTON_USER, BUTTON_MODE_EXTI);

  /*
   * CubeMX generates a BSP_COM_Init here, but SysInit above already ran one -
   * the console has to be up before the peripheral trace, not after it. Doing
   * it twice re-initialises a working UART for no reason, and the second call
   * routes failure to Error_Handler(), which now disarms the actuators. Left
   * as a note rather than deleted, because CubeMX will regenerate it.
   */

  /* Infinite loop */
  /* USER CODE BEGIN WHILE */
#if (NEXUS_MODE == NEXUS_MODE_LEG_TORQUE)
  legtorque_run();
#elif (NEXUS_MODE == NEXUS_MODE_LEG_CAN)
  legtest_run();
#elif (NEXUS_MODE == NEXUS_MODE_IMU)
  imutest_run();
#elif (NEXUS_MODE == NEXUS_MODE_CAN_SCAN)
  canscan_run();
#elif (NEXUS_MODE == NEXUS_MODE_ENC_SCAN)
  encscan_run();
#elif (NEXUS_MODE == NEXUS_MODE_CAN_CFG)
  cancfg_run();
#else
  app_run();
#endif

  while (1)
  {

    /* USER CODE END WHILE */

    /* USER CODE BEGIN 3 */
  }
  /* USER CODE END 3 */
}

/**
  * @brief FDCAN1 Initialization Function
  * @param None
  * @retval None
  */
static void MX_FDCAN1_Init(void)
{

  hfdcan1.Instance = FDCAN1;
  hfdcan1.Init.ClockDivider = FDCAN_CLOCK_DIV1;
  hfdcan1.Init.FrameFormat = FDCAN_FRAME_FD_BRS;
  hfdcan1.Init.Mode = FDCAN_MODE_NORMAL;
  hfdcan1.Init.AutoRetransmission = ENABLE;
  hfdcan1.Init.TransmitPause = DISABLE;
  hfdcan1.Init.ProtocolException = ENABLE;
  hfdcan1.Init.NominalPrescaler = 1;
  hfdcan1.Init.NominalSyncJumpWidth = 10;
  hfdcan1.Init.NominalTimeSeg1 = 69;
  hfdcan1.Init.NominalTimeSeg2 = 10;
  hfdcan1.Init.DataPrescaler = 1;
  hfdcan1.Init.DataSyncJumpWidth = 4;
  hfdcan1.Init.DataTimeSeg1 = 27;
  hfdcan1.Init.DataTimeSeg2 = 4;
  hfdcan1.Init.StdFiltersNbr = 1;
  hfdcan1.Init.ExtFiltersNbr = 0;
  hfdcan1.Init.TxFifoQueueMode = FDCAN_TX_FIFO_OPERATION;
  if (HAL_FDCAN_Init(&hfdcan1) != HAL_OK)
  {
    Error_Handler();
  }
}

/**
  * @brief FDCAN2 Initialization Function
  * @param None
  * @retval None
  */
static void MX_FDCAN2_Init(void)
{

  hfdcan2.Instance = FDCAN2;
  hfdcan2.Init.ClockDivider = FDCAN_CLOCK_DIV1;
  hfdcan2.Init.FrameFormat = FDCAN_FRAME_FD_BRS;
  hfdcan2.Init.Mode = FDCAN_MODE_NORMAL;
  hfdcan2.Init.AutoRetransmission = ENABLE;
  hfdcan2.Init.TransmitPause = DISABLE;
  hfdcan2.Init.ProtocolException = ENABLE;
  hfdcan2.Init.NominalPrescaler = 1;
  hfdcan2.Init.NominalSyncJumpWidth = 10;
  hfdcan2.Init.NominalTimeSeg1 = 69;
  hfdcan2.Init.NominalTimeSeg2 = 10;
  hfdcan2.Init.DataPrescaler = 1;
  hfdcan2.Init.DataSyncJumpWidth = 4;
  hfdcan2.Init.DataTimeSeg1 = 27;
  hfdcan2.Init.DataTimeSeg2 = 4;
  hfdcan2.Init.StdFiltersNbr = 1;
  hfdcan2.Init.ExtFiltersNbr = 0;
  hfdcan2.Init.TxFifoQueueMode = FDCAN_TX_FIFO_OPERATION;
  if (HAL_FDCAN_Init(&hfdcan2) != HAL_OK)
  {
    Error_Handler();
  }
}

/**
  * @brief GPDMA1 Initialization Function
  * @param None
  * @retval None
  */
static void MX_GPDMA1_Init(void)
{

  /* Peripheral clock enable */
  __HAL_RCC_GPDMA1_CLK_ENABLE();

  /* GPDMA1 interrupt Init */
    HAL_NVIC_SetPriority(GPDMA1_Channel0_IRQn, 2, 0);
    HAL_NVIC_EnableIRQ(GPDMA1_Channel0_IRQn);
    HAL_NVIC_SetPriority(GPDMA1_Channel1_IRQn, 2, 0);
    HAL_NVIC_EnableIRQ(GPDMA1_Channel1_IRQn);
    HAL_NVIC_SetPriority(GPDMA1_Channel2_IRQn, 4, 0);
    HAL_NVIC_EnableIRQ(GPDMA1_Channel2_IRQn);
    HAL_NVIC_SetPriority(GPDMA1_Channel3_IRQn, 4, 0);
    HAL_NVIC_EnableIRQ(GPDMA1_Channel3_IRQn);

}

/**
  * @brief SPI1 Initialization Function
  * @param None
  * @retval None
  */
static void MX_SPI1_Init(void)
{

  /* SPI1 parameter configuration*/
  hspi1.Instance = SPI1;
  hspi1.Init.Mode = SPI_MODE_MASTER;
  hspi1.Init.Direction = SPI_DIRECTION_2LINES;
  hspi1.Init.DataSize = SPI_DATASIZE_16BIT;
  hspi1.Init.CLKPolarity = SPI_POLARITY_LOW;
  hspi1.Init.CLKPhase = SPI_PHASE_2EDGE;
  hspi1.Init.NSS = SPI_NSS_SOFT;
  hspi1.Init.BaudRatePrescaler = SPI_BAUDRATEPRESCALER_16;
  hspi1.Init.FirstBit = SPI_FIRSTBIT_MSB;
  hspi1.Init.TIMode = SPI_TIMODE_DISABLE;
  hspi1.Init.CRCCalculation = SPI_CRCCALCULATION_DISABLE;
  hspi1.Init.CRCPolynomial = 0x7;
  hspi1.Init.NSSPMode = SPI_NSS_PULSE_DISABLE;
  hspi1.Init.NSSPolarity = SPI_NSS_POLARITY_LOW;
  hspi1.Init.FifoThreshold = SPI_FIFO_THRESHOLD_01DATA;
  hspi1.Init.MasterSSIdleness = SPI_MASTER_SS_IDLENESS_00CYCLE;
  hspi1.Init.MasterInterDataIdleness = SPI_MASTER_INTERDATA_IDLENESS_00CYCLE;
  hspi1.Init.MasterReceiverAutoSusp = SPI_MASTER_RX_AUTOSUSP_DISABLE;
  hspi1.Init.MasterKeepIOState = SPI_MASTER_KEEP_IO_STATE_DISABLE;
  hspi1.Init.IOSwap = SPI_IO_SWAP_DISABLE;
  hspi1.Init.ReadyMasterManagement = SPI_RDY_MASTER_MANAGEMENT_INTERNALLY;
  hspi1.Init.ReadyPolarity = SPI_RDY_POLARITY_HIGH;
  if (HAL_SPI_Init(&hspi1) != HAL_OK)
  {
    Error_Handler();
  }
}

/**
  * @brief TIM2 Initialization Function
  * @param None
  * @retval None
  */
static void MX_TIM2_Init(void)
{

  TIM_ClockConfigTypeDef sClockSourceConfig = {0};
  TIM_MasterConfigTypeDef sMasterConfig = {0};

  htim2.Instance = TIM2;
  htim2.Init.Prescaler = 299;
  htim2.Init.CounterMode = TIM_COUNTERMODE_UP;
  htim2.Init.Period = 4294967295;
  htim2.Init.ClockDivision = TIM_CLOCKDIVISION_DIV1;
  htim2.Init.AutoReloadPreload = TIM_AUTORELOAD_PRELOAD_DISABLE;
  if (HAL_TIM_Base_Init(&htim2) != HAL_OK)
  {
    Error_Handler();
  }
  sClockSourceConfig.ClockSource = TIM_CLOCKSOURCE_INTERNAL;
  if (HAL_TIM_ConfigClockSource(&htim2, &sClockSourceConfig) != HAL_OK)
  {
    Error_Handler();
  }
  sMasterConfig.MasterOutputTrigger = TIM_TRGO_RESET;
  sMasterConfig.MasterSlaveMode = TIM_MASTERSLAVEMODE_DISABLE;
  if (HAL_TIMEx_MasterConfigSynchronization(&htim2, &sMasterConfig) != HAL_OK)
  {
    Error_Handler();
  }
}

/**
  * @brief TIM6 Initialization Function
  * @param None
  * @retval None
  */
static void MX_TIM6_Init(void)
{

  TIM_MasterConfigTypeDef sMasterConfig = {0};

  htim6.Instance = TIM6;
  htim6.Init.Prescaler = 299;
  htim6.Init.CounterMode = TIM_COUNTERMODE_UP;
  htim6.Init.Period = 999;
  htim6.Init.AutoReloadPreload = TIM_AUTORELOAD_PRELOAD_DISABLE;
  if (HAL_TIM_Base_Init(&htim6) != HAL_OK)
  {
    Error_Handler();
  }
  sMasterConfig.MasterOutputTrigger = TIM_TRGO_RESET;
  sMasterConfig.MasterSlaveMode = TIM_MASTERSLAVEMODE_DISABLE;
  if (HAL_TIMEx_MasterConfigSynchronization(&htim6, &sMasterConfig) != HAL_OK)
  {
    Error_Handler();
  }
}

/**
  * @brief USART2 Initialization Function
  * @param None
  * @retval None
  */
static void MX_USART2_UART_Init(void)
{

  huart2.Instance = USART2;
  huart2.Init.BaudRate = 3000000;
  huart2.Init.WordLength = UART_WORDLENGTH_8B;
  huart2.Init.StopBits = UART_STOPBITS_1;
  huart2.Init.Parity = UART_PARITY_NONE;
  huart2.Init.Mode = UART_MODE_TX_RX;
  huart2.Init.HwFlowCtl = UART_HWCONTROL_NONE;
  huart2.Init.OverSampling = UART_OVERSAMPLING_8;
  huart2.Init.OneBitSampling = UART_ONE_BIT_SAMPLE_DISABLE;
  huart2.Init.ClockPrescaler = UART_PRESCALER_DIV1;
  huart2.AdvancedInit.AdvFeatureInit = UART_ADVFEATURE_NO_INIT;
  if (HAL_UART_Init(&huart2) != HAL_OK)
  {
    Error_Handler();
  }
  if (HAL_UARTEx_SetTxFifoThreshold(&huart2, UART_TXFIFO_THRESHOLD_1_8) != HAL_OK)
  {
    Error_Handler();
  }
  if (HAL_UARTEx_SetRxFifoThreshold(&huart2, UART_RXFIFO_THRESHOLD_1_8) != HAL_OK)
  {
    Error_Handler();
  }
  if (HAL_UARTEx_DisableFifoMode(&huart2) != HAL_OK)
  {
    Error_Handler();
  }
}

/**
  * @brief GPIO Initialization Function
  * @param None
  * @retval None
  */
static void MX_GPIO_Init(void)
{
  GPIO_InitTypeDef GPIO_InitStruct = {0};
  /* GPIO Ports Clock Enable */
  __HAL_RCC_GPIOM_CLK_ENABLE();
  __HAL_RCC_GPIOB_CLK_ENABLE();
  __HAL_RCC_GPIOE_CLK_ENABLE();
  __HAL_RCC_GPIOD_CLK_ENABLE();
  __HAL_RCC_GPIOF_CLK_ENABLE();
  __HAL_RCC_GPIOA_CLK_ENABLE();
  __HAL_RCC_GPION_CLK_ENABLE();

  /*Configure GPIO pin Output Level */
  HAL_GPIO_WritePin(enc_cs_l_hip_GPIO_Port, enc_cs_l_hip_Pin, GPIO_PIN_SET);

  /*Configure GPIO pin Output Level */
  HAL_GPIO_WritePin(GPIOD, enc_cs_r_hip_Pin|enc_cs_l_knee_Pin, GPIO_PIN_SET);

  /*Configure GPIO pin Output Level */
  HAL_GPIO_WritePin(enc_cs_r_knee_GPIO_Port, enc_cs_r_knee_Pin, GPIO_PIN_SET);

  /*Configure GPIO pins : L_TOE_Pin R_TOE_Pin R_HEEL_Pin L_HEEL_Pin */
  GPIO_InitStruct.Pin = L_TOE_Pin|R_TOE_Pin|R_HEEL_Pin|L_HEEL_Pin;
  GPIO_InitStruct.Mode = GPIO_MODE_INPUT;
  GPIO_InitStruct.Pull = GPIO_PULLUP;
  HAL_GPIO_Init(GPIOE, &GPIO_InitStruct);

  /*Configure GPIO pins : enc_cs_l_hip_Pin enc_cs_r_knee_Pin */
  GPIO_InitStruct.Pin = enc_cs_l_hip_Pin|enc_cs_r_knee_Pin;
  GPIO_InitStruct.Mode = GPIO_MODE_OUTPUT_PP;
  GPIO_InitStruct.Pull = GPIO_PULLUP;
  GPIO_InitStruct.Speed = GPIO_SPEED_FREQ_LOW;
  HAL_GPIO_Init(GPIOF, &GPIO_InitStruct);

  /*Configure GPIO pins : enc_cs_r_hip_Pin enc_cs_l_knee_Pin */
  GPIO_InitStruct.Pin = enc_cs_r_hip_Pin|enc_cs_l_knee_Pin;
  GPIO_InitStruct.Mode = GPIO_MODE_OUTPUT_PP;
  GPIO_InitStruct.Pull = GPIO_NOPULL;
  GPIO_InitStruct.Speed = GPIO_SPEED_FREQ_LOW;
  HAL_GPIO_Init(GPIOD, &GPIO_InitStruct);

}

/* USER CODE BEGIN 4 */
void HAL_TIM_PeriodElapsedCallback(TIM_HandleTypeDef *htim)
{
  if (htim->Instance == TIM6)
  {
#if (NEXUS_MODE == NEXUS_MODE_LEG_TORQUE)
    legtorque_on_tick();
#elif (NEXUS_MODE == NEXUS_MODE_LEG_CAN)
    legtest_on_tick();
#elif (NEXUS_MODE == NEXUS_MODE_IMU)
    imutest_on_tick();
#else
    app_on_tick();
#endif
  }
}

void HAL_SPI_TxRxCpltCallback(SPI_HandleTypeDef *hspi)
{
  if (hspi->Instance == SPI1)
  {
    enc_on_dma_complete();
  }
}

void HAL_UARTEx_RxEventCallback(UART_HandleTypeDef *huart, uint16_t Size)
{
  if (huart->Instance == USART2)
  {
    imu_on_rx_event(Size);
  }
}

void HAL_FDCAN_RxFifo0Callback(FDCAN_HandleTypeDef *hfdcan, uint32_t RxFifo0ITs)
{
  if ((RxFifo0ITs & FDCAN_IT_RX_FIFO0_NEW_MESSAGE) == 0U)
  {
    return;
  }

#if (NEXUS_MODE == NEXUS_MODE_CAN_SCAN)
  canscan_on_rx(hfdcan);
#elif (NEXUS_MODE == NEXUS_MODE_CAN_CFG)
  cancfg_on_rx(hfdcan);
#elif (NEXUS_MODE == NEXUS_MODE_LEG_TORQUE)
  if (hfdcan->Instance == FDCAN1)
  {
    legtorque_on_rx();
  }
#elif (NEXUS_MODE == NEXUS_MODE_LEG_CAN)
  if (hfdcan->Instance == FDCAN1)
  {
    legtest_on_rx();
  }
#else
  if (hfdcan->Instance == FDCAN1)
  {
    act_on_rx(0);
  }
  else if (hfdcan->Instance == FDCAN2)
  {
    act_on_rx(1);
  }
#endif
}
/* USER CODE END 4 */
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
