vismay5559/stm32_zeuss/Appli/App/act_odrive.c

#include "act_odrive.h"
#include "robot_config.h"
#include "critical.h"
#include "main.h"
#include <math.h>
#include <string.h>

extern FDCAN_HandleTypeDef hfdcan1;
extern FDCAN_HandleTypeDef hfdcan2;

/* ODrive CANSimple: arbitration id is (node_id << 5) | cmd_id. */
#define ODRV_CMD_HEARTBEAT        0x001u
#define ODRV_CMD_ESTOP            0x002u
#define ODRV_CMD_SET_AXIS_STATE   0x007u
#define ODRV_CMD_CLEAR_ERRORS     0x018u
#define ODRV_CMD_GET_ENCODER      0x009u
#define ODRV_CMD_SET_INPUT_POS    0x00Cu
#define ODRV_CMD_GET_TORQUES      0x01Cu
#define ODRV_CMD_SET_POS_GAIN     0x01Au
#define ODRV_CMD_SET_VEL_GAINS    0x01Bu

/* How often a standing disarm request is repeated while faulted, in ticks.
   Once is not enough - the frame can be lost, or a drive can reboot into
   closed loop - and 1 kHz would flood a bus that may already be struggling. */
#define ODRV_DISARM_REPEAT_TICKS  100u

/* How often an outstanding arm request is repeated while axes are still not
   in closed loop. Same reasoning as the disarm repeat, opposite direction. */
#define ODRV_ARM_REPEAT_TICKS     100u

/* Four leg drives per bus. The waist drives (node 5 on each bus) are not
   part of this build - see the joint map in link_proto.h. The RX filter is
   left open to node 5 so an unexpected drive still shows up as a dropped
   frame rather than silence. */
#define ODRV_NODES_PER_BUS        4
#define ODRV_FILTER_ID_LOW        0x020u   /* node 1, cmd 0  */
#define ODRV_FILTER_ID_HIGH       0x0BFu   /* node 5, cmd 31 */

/* Commands arrive at 250 Hz and are interpolated across the 1 kHz ticks between them. */
#define CMD_SEGMENT_TICKS         4u

/* ODRV_CMD_DIVIDER and why it is 2 are in act_odrive.h. */
_Static_assert((CMD_SEGMENT_TICKS % ODRV_CMD_DIVIDER) == 0u,
               "the segment endpoint would never be transmitted");

/*
 * CAN FD with BRS, 1 Mbit arbitration / 2.5 Mbit data.
 *
 * This was classic 2.0 for a while: the S1s were measured sending CLASSIC
 * frames and not acknowledging FD ones, which drives our transmit error
 * counter to bus-off while reception still looks perfect. That is a drive
 * configuration, not a wiring fault - the S1 does support FD.
 *
 * Classic cannot carry this robot. Eight drives, four to a bus, at 1 kHz with
 * 1 kHz encoder telemetry is 8800 frames a second per bus; a classic frame is
 * 120 us on the wire, which is 106% of the bus. It does not fit. FD at 2.5
 * Mbit is 65 us and 58%.
 *
 * IF THE DRIVES STILL WILL NOT ACK FD: the symptom is TEC climbing to bus-off
 * with REC at 0, and the fallback is to set this to 0 - but then the telemetry
 * rates have to come down a long way first, because classic at these rates is
 * over capacity. Check every drive has FD enabled and data_baud_rate at 2.5
 * Mbit; one left behind is electrically fine and completely silent.
 */
#define ODRV_USE_FD               1     /* 1 = FD + BRS, 0 = classic 2.0 */

/*
 * Secondary sample point, in time quanta, matched to the data sample point in
 * MX_FDCAN1_Init: 87.5% of 32 tq. One tq is 12.5 ns at the 80 MHz kernel
 * clock, so this is 350 ns into a 400 ns bit.
 */
#define ODRV_TDC_OFFSET           28u

#if ODRV_USE_FD
#define ODRV_TX_FORMAT            FDCAN_FD_CAN
#define ODRV_TX_BRS               FDCAN_BRS_ON
#else
#define ODRV_TX_FORMAT            FDCAN_CLASSIC_CAN
#define ODRV_TX_BRS               FDCAN_BRS_OFF
#endif

/*
 * The FDCAN hardware transmit FIFO on this part is fixed at three entries
 * (SRAMCAN_TFQ_NBR in stm32h7rsxx_hal_fdcan.c - it is not configurable).
 * Each 1 kHz tick wants to send five frames per bus, so handing all five
 * straight to the hardware silently loses two of them and nodes 4 and 5
 * would never receive a command.
 *
 * So frames go into a software queue first, and act_tx_pump() moves them into
 * the hardware FIFO as space frees up. At ~50 us per frame on the wire, five
 * frames drain in ~250 us, comfortably inside one tick.
 *
 * Both the producer (act_tick_1khz) and the consumer (act_tx_pump) run in
 * main-loop context, never in an ISR, so the queue needs no locking.
 */
#define CAN_TXQ_LEN   16u    /* must be a power of two */
#define CAN_TXQ_MASK  (CAN_TXQ_LEN - 1u)

typedef struct
{
    uint32_t identifier;
    uint8_t  data[8];
} can_tx_frame_t;

static can_tx_frame_t s_txq[2][CAN_TXQ_LEN];
static uint8_t        s_txq_head[2];
static uint8_t        s_txq_tail[2];
static uint32_t       s_tx_dropped[2];

/* Frames accepted from each bus. Only ever increments, so a health check can
   detect "this bus has gone quiet" by watching it stop changing. */
static volatile uint32_t s_rx_count[2];

static act_telemetry_t s_telem;

static float    s_seg_start[NEXUS_NUM_JOINTS];
static float    s_seg_end[NEXUS_NUM_JOINTS];
static float    s_out[NEXUS_NUM_JOINTS];
static float    s_prev_out[NEXUS_NUM_JOINTS];

/* Feedforward from the gait clock, refreshed every tick by
   act_set_feedforward(). Motor Nm, already divided by the gear ratio.
   s_have_ff stays 0 until something sets one, so a build that never calls it -
   the single-leg bench test - keeps the old behaviour exactly. */
static float    s_vel_ff[NEXUS_NUM_JOINTS];
static float    s_tau_ff[NEXUS_NUM_JOINTS];
static uint8_t  s_have_ff;
static uint32_t s_seg_tick;
static uint32_t s_cmd_tick;     /* ticks since Set_Input_Pos last went out */
static uint8_t  s_have_target;

/* The gains every drive is given when it arms. Starts as the table in
   robot_config.c; the Pi may replace it while disarmed. */
static drive_gains_t s_gains[NEXUS_NUM_JOINTS];
static uint8_t       s_gains_loaded;

/* Ticks since each joint last reported a position. Written from the FDCAN
   ISRs and from the tick, so every access is inside a critical section. */
static volatile uint16_t s_pos_age[NEXUS_NUM_JOINTS];

/* Non-zero while a disarm is standing, with a countdown to the next repeat. */
static uint8_t  s_disarmed;
static uint32_t s_disarm_repeat;

/* Set once both FDCAN peripherals are started. Guards the fault-path disarm,
   which can be reached before act_init() has ever run. */
static volatile uint8_t s_can_ready;

/* Non-zero while an arm request is outstanding, with its repeat countdown. */
static uint8_t  s_arming;
static uint32_t s_arm_repeat;

/* Bus health. Bus-off is the one that matters: the peripheral stops
   transmitting entirely and never restarts on its own. */
static uint32_t s_bus_off_count[2];
static uint8_t  s_tx_err_count[2];

static FDCAN_HandleTypeDef *bus_handle(uint8_t bus)
{
    return (bus == 0u) ? &hfdcan1 : &hfdcan2;
}

static float le_f32(const uint8_t *p)
{
    uint32_t v = (uint32_t)p[0] | ((uint32_t)p[1] << 8) |
                 ((uint32_t)p[2] << 16) | ((uint32_t)p[3] << 24);
    float f;
    memcpy(&f, &v, sizeof(f));
    return f;
}

static uint32_t le_u32(const uint8_t *p)
{
    return (uint32_t)p[0] | ((uint32_t)p[1] << 8) |
           ((uint32_t)p[2] << 16) | ((uint32_t)p[3] << 24);
}

static void bus_setup(FDCAN_HandleTypeDef *h)
{
    FDCAN_FilterTypeDef f;

    f.IdType       = FDCAN_STANDARD_ID;
    f.FilterIndex  = 0;
    f.FilterType   = FDCAN_FILTER_RANGE;
    f.FilterConfig = FDCAN_FILTER_TO_RXFIFO0;
    f.FilterID1    = ODRV_FILTER_ID_LOW;
    f.FilterID2    = ODRV_FILTER_ID_HIGH;

    HAL_FDCAN_ConfigFilter(h, &f);
    HAL_FDCAN_ConfigGlobalFilter(h, FDCAN_REJECT, FDCAN_REJECT,
                                 FDCAN_FILTER_REMOTE, FDCAN_FILTER_REMOTE);
#if ODRV_USE_FD
    /*
     * The secondary sample point, for the transmitter checking its own bits.
     *
     * The ISO1042's loop delay is 152 ns - a large fraction of a data bit - so
     * without TDC every FD frame fails its own bit check. The offset must put
     * the SSP at the SAME point in the bit as the data sample point, which is
     * 87.5% of 32 tq = 28 tq = 350 ns at 2.5 Mbit.
     *
     * This read 8 tq, which is 25% of the bit. Nobody noticed because the leg
     * test configures its own value (ODRV_TDC_OFFSET's twin, LEGTEST_TDC_OFFSET)
     * and robot mode has never run on a live bus. Checking a bit at 25% while
     * the receivers check at 87.5% is exactly the mismatch that drove the error
     * counters before.
     *
     * Change this with the timing in MX_FDCAN1_Init - they are one decision.
     */
    HAL_FDCAN_ConfigTxDelayCompensation(h, ODRV_TDC_OFFSET, 0u);
    HAL_FDCAN_EnableTxDelayCompensation(h);
#endif

    HAL_FDCAN_Start(h);
    HAL_FDCAN_ActivateNotification(h, FDCAN_IT_RX_FIFO0_NEW_MESSAGE, 0);
}

static void tx_enqueue(uint8_t bus, uint32_t identifier, const uint8_t *data)
{
    uint8_t next = (uint8_t)((s_txq_head[bus] + 1u) & CAN_TXQ_MASK);

    if (next == s_txq_tail[bus])
    {
        /* Queue full: the bus is not keeping up. Drop the frame rather than
           block, and count it - a non-zero value here means the bus is
           oversubscribed and telemetry rates need to come down. */
        s_tx_dropped[bus]++;
        return;
    }

    s_txq[bus][s_txq_head[bus]].identifier = identifier;
    memcpy(s_txq[bus][s_txq_head[bus]].data, data, 8);
    s_txq_head[bus] = next;
}

void act_tx_pump(void)
{
    FDCAN_TxHeaderTypeDef hdr;

    hdr.IdType              = FDCAN_STANDARD_ID;
    hdr.TxFrameType         = FDCAN_DATA_FRAME;
    hdr.DataLength          = FDCAN_DLC_BYTES_8;
    hdr.ErrorStateIndicator = FDCAN_ESI_ACTIVE;
    hdr.BitRateSwitch       = ODRV_TX_BRS;
    hdr.FDFormat            = ODRV_TX_FORMAT;
    hdr.TxEventFifoControl  = FDCAN_NO_TX_EVENTS;
    hdr.MessageMarker       = 0;

    for (uint8_t bus = 0; bus < 2u; bus++)
    {
        FDCAN_HandleTypeDef *h = bus_handle(bus);

        while (s_txq_tail[bus] != s_txq_head[bus])
        {
            if (HAL_FDCAN_GetTxFifoFreeLevel(h) == 0u)
            {
                break;   /* hardware FIFO full, try again next pass */
            }

            hdr.Identifier = s_txq[bus][s_txq_tail[bus]].identifier;

            if (HAL_FDCAN_AddMessageToTxFifoQ(h, &hdr,
                                              s_txq[bus][s_txq_tail[bus]].data) != HAL_OK)
            {
                break;   /* leave it queued and retry rather than losing it */
            }

            s_txq_tail[bus] = (uint8_t)((s_txq_tail[bus] + 1u) & CAN_TXQ_MASK);
        }
    }
}

uint32_t act_tx_dropped(uint8_t bus)
{
    return (bus < 2u) ? s_tx_dropped[bus] : 0u;
}

uint32_t act_rx_count(uint8_t bus)
{
    return (bus < 2u) ? s_rx_count[bus] : 0u;
}

void act_init(void)
{
    memset(&s_telem, 0, sizeof(s_telem));
    memset(s_txq, 0, sizeof(s_txq));
    memset(s_txq_head, 0, sizeof(s_txq_head));
    memset(s_txq_tail, 0, sizeof(s_txq_tail));
    memset(s_tx_dropped, 0, sizeof(s_tx_dropped));
    if (!s_gains_loaded)
    {
        for (int j = 0; j < NEXUS_NUM_JOINTS; j++)
        {
            s_gains[j] = g_drive_gains[j];
        }
        s_gains_loaded = 1;
    }

    memset(s_seg_start, 0, sizeof(s_seg_start));
    memset(s_seg_end, 0, sizeof(s_seg_end));
    memset(s_out, 0, sizeof(s_out));
    memset(s_prev_out, 0, sizeof(s_prev_out));

    s_seg_tick    = CMD_SEGMENT_TICKS;
    s_cmd_tick    = 0u;
    s_have_target = 0;

    /* Start every joint at maximum age. Nothing has been heard from any drive
       yet, and "unknown" must read as stale, not as fresh zeros. */
    for (int j = 0; j < NEXUS_NUM_JOINTS; j++)
    {
        s_pos_age[j] = 0xFFFFu;
    }

    s_disarmed      = 0;
    s_disarm_repeat = 0;
    s_arming        = 0;
    s_arm_repeat    = 0;

    memset(s_bus_off_count, 0, sizeof(s_bus_off_count));
    memset(s_tx_err_count, 0, sizeof(s_tx_err_count));

    bus_setup(&hfdcan1);
    bus_setup(&hfdcan2);

    s_can_ready = 1;
}

void act_on_rx(uint8_t bus_index)
{
    /*
     * There are two buses, and the joint index derived below indexes ten-entry
     * arrays. Every other entry point here bounds-checks its bus argument, and
     * the s_rx_count line already masked - but the joint index did not, so a
     * third bus would have written past the end of s_telem and s_pos_age.
     *
     * Not reachable today: the only callers are the two FDCAN interrupt
     * handlers in main.c, which pass 0 and 1. Masking once, here, makes the
     * whole function agree with the rest of the file rather than half of it.
     */
    const uint8_t bus = bus_index & 1u;

    FDCAN_HandleTypeDef *h = bus_handle(bus);
    FDCAN_RxHeaderTypeDef hdr;
    uint8_t data[64];

    while (HAL_FDCAN_GetRxFifoFillLevel(h, FDCAN_RX_FIFO0) > 0u)
    {
        if (HAL_FDCAN_GetRxMessage(h, FDCAN_RX_FIFO0, &hdr, data) != HAL_OK)
        {
            return;
        }

        uint32_t node = (hdr.Identifier >> 5) & 0x3Fu;
        uint32_t cmd  = hdr.Identifier & 0x1Fu;

        if ((node < 1u) || (node > (uint32_t)ODRV_NODES_PER_BUS))
        {
            continue;
        }

        s_rx_count[bus]++;

        int j = (int)(bus * ODRV_NODES_PER_BUS) + (int)(node - 1u);

        switch (cmd)
        {
        case ODRV_CMD_GET_ENCODER:
            s_telem.pos[j] = le_f32(&data[0]);
            s_telem.vel[j] = le_f32(&data[4]);
            s_telem.flags[j] |= NEXUS_ACT_TELEM_FRESH;
            s_pos_age[j] = 0u;      /* this is the one that means "trustworthy" */
            break;

        case ODRV_CMD_GET_TORQUES:
            s_telem.torque[j] = le_f32(&data[4]);
            s_telem.flags[j] |= NEXUS_ACT_TELEM_FRESH;
            break;

        case ODRV_CMD_HEARTBEAT:
            s_telem.axis_error[j] = le_u32(&data[0]);
            s_telem.axis_state[j] = data[4];
            s_telem.flags[j] |= NEXUS_ACT_HB_FRESH;
            break;

        default:
            break;
        }
    }
}

static void send_axis_state(uint8_t bus, uint32_t node, uint32_t state)
{
    uint8_t data[8] = { 0 };

    data[0] = (uint8_t)(state & 0xFFu);
    data[1] = (uint8_t)((state >> 8) & 0xFFu);
    data[2] = (uint8_t)((state >> 16) & 0xFFu);
    data[3] = (uint8_t)((state >> 24) & 0xFFu);

    tx_enqueue(bus, (node << 5) | ODRV_CMD_SET_AXIS_STATE, data);
}

static void request_all_idle(void)
{
    for (int j = 0; j < NEXUS_NUM_JOINTS; j++)
    {
        uint8_t  bus  = (uint8_t)(j / ODRV_NODES_PER_BUS);
        uint32_t node = (uint32_t)(j % ODRV_NODES_PER_BUS) + 1u;

        send_axis_state(bus, node, ODRV_AXIS_STATE_IDLE);
    }
    act_tx_pump();
}

void act_disarm(void)
{
    /*
     * Stop the interpolator dead rather than letting it finish its segment.
     * Clearing s_have_target is what actually silences act_tick_1khz(); the
     * IDLE request on top of it is what makes the drives stop holding torque
     * even if this board goes on to do something worse.
     */
    s_have_target = 0;
    s_seg_tick    = CMD_SEGMENT_TICKS;
    s_cmd_tick    = 0u;
    s_arming      = 0;

    if (!s_disarmed)
    {
        s_disarmed      = 1;
        s_disarm_repeat = 0;
        request_all_idle();
    }
}

uint8_t act_is_armed(void)
{
    return s_have_target;
}

static void request_all_closed_loop(void)
{
    for (int j = 0; j < NEXUS_NUM_JOINTS; j++)
    {
        uint8_t  bus  = (uint8_t)(j / ODRV_NODES_PER_BUS);
        uint32_t node = (uint32_t)(j % ODRV_NODES_PER_BUS) + 1u;

        /*
         * Only nudge axes that are not already there. Re-commanding an axis
         * that is happily in closed loop is not free - the drive processes the
         * state request - and it would fight a drive that is mid-transition.
         */
        if (s_telem.axis_state[j] != ODRV_AXIS_STATE_CLOSED_LOOP_CONTROL)
        {
            send_axis_state(bus, node, ODRV_AXIS_STATE_CLOSED_LOOP_CONTROL);
        }
    }
    act_tx_pump();
}

static void put_f32_le(uint8_t *p, float v)
{
    uint32_t bits;
    memcpy(&bits, &v, sizeof(bits));
    p[0] = (uint8_t)(bits & 0xFFu);
    p[1] = (uint8_t)((bits >> 8) & 0xFFu);
    p[2] = (uint8_t)((bits >> 16) & 0xFFu);
    p[3] = (uint8_t)((bits >> 24) & 0xFFu);
}

/*
 * Write the gain table to the drives.
 *
 * Sent on every arm, not once at boot: a drive that browned out, was swapped
 * or rebooted mid-session would otherwise come back holding its own saved
 * gains while the robot behaved as though it had the tuned ones. Two frames
 * per joint, sixteen in all, and only ever while disarmed or arming.
 */
static void send_gains(void)
{
    uint8_t data[8];

    for (int j = 0; j < NEXUS_NUM_JOINTS; j++)
    {
        uint8_t  bus  = (uint8_t)(j / ODRV_NODES_PER_BUS);
        uint32_t node = (uint32_t)(j % ODRV_NODES_PER_BUS) + 1u;

        if (s_gains[j].pos_gain >= 0.0f)
        {
            memset(data, 0, sizeof(data));
            put_f32_le(&data[0], s_gains[j].pos_gain);
            tx_enqueue(bus, (node << 5) | ODRV_CMD_SET_POS_GAIN, data);
        }
        if ((s_gains[j].vel_gain >= 0.0f) && (s_gains[j].vel_int_gain >= 0.0f))
        {
            memset(data, 0, sizeof(data));
            put_f32_le(&data[0], s_gains[j].vel_gain);
            put_f32_le(&data[4], s_gains[j].vel_int_gain);
            tx_enqueue(bus, (node << 5) | ODRV_CMD_SET_VEL_GAINS, data);
        }
    }
    act_tx_pump();
}

uint8_t act_set_gains(const drive_gains_t gains[NEXUS_NUM_JOINTS])
{
    /*
     * Not while the robot is driving. Changing a velocity gain under load is
     * a step change in torque with a leg's weight behind it, and the whole
     * point of the tuning loop is that it happens between runs.
     */
    if (!s_disarmed && s_have_target)
    {
        return 0;
    }

    for (int j = 0; j < NEXUS_NUM_JOINTS; j++)
    {
        s_gains[j] = gains[j];
    }
    send_gains();
    return 1;
}

void act_get_gains(drive_gains_t out[NEXUS_NUM_JOINTS])
{
    for (int j = 0; j < NEXUS_NUM_JOINTS; j++)
    {
        out[j] = s_gains[j];
    }
}

uint8_t act_get_sent_targets(float out[NEXUS_NUM_JOINTS])
{
    uint32_t primask = critical_enter();

    for (int j = 0; j < NEXUS_NUM_JOINTS; j++)
    {
        out[j] = s_out[j];
    }
    uint8_t driving = s_have_target;

    critical_exit(primask);
    return driving;
}

void act_request_arm(void)
{
    uint8_t data[8] = { 0 };

    /* Gains before closed loop: a drive that has just been told to hold
       position should be holding it with the gains we think it has. */
    send_gains();

    s_disarmed   = 0;
    s_arming     = 1;
    s_arm_repeat = 0;

    /*
     * Clear latched errors first, once, on this explicit request. An axis that
     * has tripped will refuse to enter closed loop until its error is cleared,
     * and doing it here - rather than automatically whenever an error appears -
     * keeps "something went wrong" visible in act_error until a human, or the
     * Pi, decides to move on from it.
     */
    for (int j = 0; j < NEXUS_NUM_JOINTS; j++)
    {
        uint8_t  bus  = (uint8_t)(j / ODRV_NODES_PER_BUS);
        uint32_t node = (uint32_t)(j % ODRV_NODES_PER_BUS) + 1u;

        if (s_telem.axis_error[j] != 0u)
        {
            tx_enqueue(bus, (node << 5) | ODRV_CMD_CLEAR_ERRORS, data);
        }
    }

    request_all_closed_loop();
}

uint16_t act_not_closed_loop_mask(void)
{
    uint16_t mask = 0;

    uint32_t primask = critical_enter();
    for (int j = 0; j < NEXUS_NUM_JOINTS; j++)
    {
        if (s_telem.axis_state[j] != ODRV_AXIS_STATE_CLOSED_LOOP_CONTROL)
        {
            mask |= (uint16_t)(1u << j);
        }
    }
    critical_exit(primask);

    return mask;
}

uint8_t act_all_closed_loop(void)
{
    return (act_not_closed_loop_mask() == 0u) ? 1u : 0u;
}

uint32_t act_bus_off_count(uint8_t bus)
{
    return (bus < 2u) ? s_bus_off_count[bus] : 0u;
}

uint8_t act_tx_error_count(uint8_t bus)
{
    return (bus < 2u) ? s_tx_err_count[bus] : 0u;
}

void act_bus_service(void)
{
    if (!s_can_ready)
    {
        return;
    }

    for (uint8_t bus = 0; bus < 2u; bus++)
    {
        FDCAN_HandleTypeDef        *h = bus_handle(bus);
        FDCAN_ProtocolStatusTypeDef ps;
        FDCAN_ErrorCountersTypeDef  ec;

        if (HAL_FDCAN_GetProtocolStatus(h, &ps) != HAL_OK)
        {
            continue;
        }

        /* The transmit error counter lives in the error-counters struct, not
         * the protocol-status one: HAL_FDCAN_GetProtocolStatus reports the
         * bus state (bus-off, error-passive, warning), while the raw TEC/REC
         * values come from HAL_FDCAN_GetErrorCounters. A failed read leaves
         * the previous count rather than reporting a fictitious zero. */
        if (HAL_FDCAN_GetErrorCounters(h, &ec) == HAL_OK)
        {
            s_tx_err_count[bus] = (uint8_t)ec.TxErrorCnt;
        }

        if (ps.BusOff)
        {
            /*
             * Bus-off is terminal without intervention: the peripheral has
             * given up transmitting and will not come back on its own. The
             * driver's own comment records that an FD/classic mismatch drives
             * the TEC straight here while reception still looks perfect - so
             * this is a failure that has already been observed on hardware,
             * and until now the only symptom was act_rx_count() going flat.
             *
             * Restarting clears CCCR.INIT and begins the recovery sequence the
             * CAN spec requires (128 occurrences of 11 recessive bits).
             */
            s_bus_off_count[bus]++;
            (void)HAL_FDCAN_Start(h);
        }
    }
}

void act_emergency_idle(void)
{
    /*
     * Error_Handler() can fire long before act_init() - a failed clock or BSP
     * init reaches it while the FDCAN handles are still zeroed, and touching
     * h->Instance then turns a reported error into a hard fault inside the
     * error handler.
     */
    if (!s_can_ready)
    {
        return;
    }

    /*
     * Deliberately does not touch the software queue or any module state:
     * this runs from fault handlers, where the queue's indices may be exactly
     * what is corrupt. Straight into the hardware FIFO, bounded spins only.
     */
    FDCAN_TxHeaderTypeDef hdr;

    hdr.IdType              = FDCAN_STANDARD_ID;
    hdr.TxFrameType         = FDCAN_DATA_FRAME;
    hdr.DataLength          = FDCAN_DLC_BYTES_8;
    hdr.ErrorStateIndicator = FDCAN_ESI_ACTIVE;
    hdr.BitRateSwitch       = ODRV_TX_BRS;
    hdr.FDFormat            = ODRV_TX_FORMAT;
    hdr.TxEventFifoControl  = FDCAN_NO_TX_EVENTS;
    hdr.MessageMarker       = 0;

    uint8_t data[8] = { (uint8_t)ODRV_AXIS_STATE_IDLE, 0, 0, 0, 0, 0, 0, 0 };

    for (int j = 0; j < NEXUS_NUM_JOINTS; j++)
    {
        uint8_t              bus  = (uint8_t)(j / ODRV_NODES_PER_BUS);
        uint32_t             node = (uint32_t)(j % ODRV_NODES_PER_BUS) + 1u;
        FDCAN_HandleTypeDef *h    = bus_handle(bus);

        hdr.Identifier = (node << 5) | ODRV_CMD_SET_AXIS_STATE;

        /* Wait for room, but never forever - a bus-off peripheral never
           frees a slot, and hanging here would strand the other bus too. */
        for (uint32_t spin = 0; spin < 100000u; spin++)
        {
            if (HAL_FDCAN_GetTxFifoFreeLevel(h) != 0u)
            {
                break;
            }
        }

        (void)HAL_FDCAN_AddMessageToTxFifoQ(h, &hdr, data);
    }
}

void act_set_targets(const float target_pos[NEXUS_NUM_JOINTS])
{
    s_disarmed = 0;

    for (int j = 0; j < NEXUS_NUM_JOINTS; j++)
    {
        if (!s_have_target)
        {
            /*
             * First target after a disarm: start the ramp from where the leg
             * ACTUALLY is, not from where the Pi wants it.
             *
             * Seeding from the commanded value makes the first frame a step
             * input - the drive is told to be somewhere else immediately and
             * gets there as fast as it can. Seeding from the measured
             * position turns the same command into the first millisecond of a
             * normal interpolated move.
             *
             * Only when the measurement can be trusted. A joint that has not
             * reported recently would seed from a stale or zero value, which
             * is the step input again, only with a worse starting point.
             *
             * Read without a critical section, unlike act_get(): both loads
             * are single aligned words, so neither can tear, and the worst an
             * FDCAN interrupt landing between them can do is pair an age with
             * a position one frame newer. For a starting point that is not a
             * difference worth disabling interrupts for.
             */
            float seed = ((s_pos_age[j] <= ACT_POS_STALE_TICKS) &&
                          isfinite(s_telem.pos[j]))
                             ? s_telem.pos[j]
                             : target_pos[j];

            s_out[j]      = seed;
            s_prev_out[j] = seed;
        }
        /* Anchor each segment at where output actually is, so late or jittery
           command frames do not accumulate position error. */
        s_seg_start[j] = s_out[j];
        s_seg_end[j]   = target_pos[j];
    }

    s_seg_tick    = 0;
    s_have_target = 1;
}

void act_set_feedforward(const float vel_turns_s[NEXUS_NUM_JOINTS],
                         const float torque_out_nm[NEXUS_NUM_JOINTS])
{
    s_have_ff = 1u;

    for (int j = 0; j < NEXUS_NUM_JOINTS; j++)
    {
        float v = (vel_turns_s != 0) ? vel_turns_s[j] : 0.0f;
        float t = (torque_out_nm != 0) ? torque_out_nm[j] : 0.0f;

        /* A NaN here would be packed into an int16 and sent, and an undefined
           cast of NaN is whatever the hardware felt like - possibly full
           torque. Drop to zero instead: no feedforward is a worse-tracking
           robot, a wrong one is a dangerous robot. */
        s_vel_ff[j] = isfinite(v) ? v : 0.0f;

        /* Output Nm -> MOTOR Nm, which is what Torque_FF carries. */
        s_tau_ff[j] = (isfinite(t) && (g_joint_gear[j] > 0.0f))
                      ? (t / g_joint_gear[j]) : 0.0f;
    }
}

static void send_input_pos(uint8_t bus, uint32_t node, float pos,
                           float vel_ff, float tau_ff)
{
    uint8_t  data[8];
    uint32_t bits;

    /* ODrive packs vel_ff as int16 in units of 0.001 turns/s, so the field
       saturates at +/-32.7 turns/s. Clamp before the cast: a C cast of an
       out-of-range float to int16 wraps sign, which would turn a large
       positive feedforward into a large negative one. */
    float    vff_milli = vel_ff * 1000.0f;
    int16_t  vff;

    if (vff_milli > 32767.0f)
    {
        vff = 32767;
    }
    else if (vff_milli < -32768.0f)
    {
        vff = -32768;
    }
    else
    {
        vff = (int16_t)vff_milli;
    }

    memcpy(&bits, &pos, sizeof(bits));
    data[0] = (uint8_t)(bits & 0xFFu);
    data[1] = (uint8_t)((bits >> 8) & 0xFFu);
    data[2] = (uint8_t)((bits >> 16) & 0xFFu);
    data[3] = (uint8_t)((bits >> 24) & 0xFFu);
    data[4] = (uint8_t)((uint16_t)vff & 0xFFu);
    data[5] = (uint8_t)(((uint16_t)vff >> 8) & 0xFFu);

    /*
     * Torque_FF, same int16-in-thousandths packing as the velocity and the
     * same reason for clamping first: a C cast of an out-of-range float wraps
     * sign, which would turn maximum forward torque into maximum reverse.
     *
     * These bytes were hardcoded to 0 until the policy's gait arrived with the
     * torque the trajectory optimiser solved for. In MOTOR Nm the peaks are
     * well under 1 Nm against this field's +/-32.767, so saturation is not the
     * live concern - resolution is, and 1 mNm against a few tenths of a Nm is
     * a fraction of a percent.
     */
    float   tff_milli = tau_ff * 1000.0f;
    int16_t tff;

    if (tff_milli > 32767.0f)
    {
        tff = 32767;
    }
    else if (tff_milli < -32768.0f)
    {
        tff = -32768;
    }
    else
    {
        tff = (int16_t)tff_milli;
    }

    data[6] = (uint8_t)((uint16_t)tff & 0xFFu);
    data[7] = (uint8_t)(((uint16_t)tff >> 8) & 0xFFu);

    tx_enqueue(bus, (node << 5) | ODRV_CMD_SET_INPUT_POS, data);
}

void act_tick_1khz(void)
{
    /* Age every joint's position, armed or not - the estimator has to know
       how old a value is even while nothing is being commanded. */
    uint32_t primask = critical_enter();
    for (int j = 0; j < NEXUS_NUM_JOINTS; j++)
    {
        if (s_pos_age[j] < 0xFFFFu)
        {
            s_pos_age[j]++;
        }
    }
    critical_exit(primask);

    /* Keep a standing disarm standing. A single frame can be lost, and a
       drive that reboots comes back in whatever state it was configured for. */
    if (s_disarmed)
    {
        if (++s_disarm_repeat >= ODRV_DISARM_REPEAT_TICKS)
        {
            s_disarm_repeat = 0;
            request_all_idle();
        }
    }

    /* Likewise for an arm that has not completed: keep asking the stragglers
       until every axis reports closed loop, then stop. */
    if (s_arming)
    {
        if (act_all_closed_loop())
        {
            s_arming = 0;
        }
        else if (++s_arm_repeat >= ODRV_ARM_REPEAT_TICKS)
        {
            s_arm_repeat = 0;
            request_all_closed_loop();
        }
    }

    if (!s_have_target)
    {
        return;
    }

    if (s_seg_tick < CMD_SEGMENT_TICKS)
    {
        s_seg_tick++;
    }

    /*
     * s_out is only advanced on a tick that TRANSMITS, so it always holds the
     * value the drives were actually last given. The packet's act_target comes
     * from it (act_get_sent_targets), and that field means "what the drive was
     * told" - computing a target every tick while sending every other one
     * would publish a number no drive had received, which is the sort of
     * quietly-wrong telemetry that sends someone tuning a gain that is fine.
     *
     * Sampling the same interpolation at 2 of the 4 segment ticks walks each
     * drive along an identical path, just told at its midpoint and its end.
     */
    if (++s_cmd_tick < ODRV_CMD_DIVIDER)
    {
        act_tx_pump();
        return;
    }
    s_cmd_tick = 0u;

    float alpha = (float)s_seg_tick / (float)CMD_SEGMENT_TICKS;

    for (int j = 0; j < NEXUS_NUM_JOINTS; j++)
    {
        s_prev_out[j] = s_out[j];
        s_out[j]      = s_seg_start[j] + ((s_seg_end[j] - s_seg_start[j]) * alpha);

        /*
         * The GAIT's velocity, not the slope of our own interpolated target.
         *
         * Those are different things and training used the first. The slope of
         * the target is how fast the command is changing, which includes the
         * residual and the interpolator's staircase; the gait's velocity is
         * how fast the motion itself is meant to be going.
         *
         * Falls back to the slope when nothing has set a feedforward, so the
         * single-leg bench test behaves as it always did. Over the interval
         * between transmissions, not 1 ms.
         */
        float vel_ff = s_have_ff ? s_vel_ff[j]
                                 : ((s_out[j] - s_prev_out[j]) *
                                    (1000.0f / (float)ODRV_CMD_DIVIDER));

        uint8_t  bus  = (uint8_t)(j / ODRV_NODES_PER_BUS);
        uint32_t node = (uint32_t)(j % ODRV_NODES_PER_BUS) + 1u;

        send_input_pos(bus, node, s_out[j], vel_ff, s_tau_ff[j]);
    }

    /* Start draining immediately; app_run() keeps pumping for the rest of the tick. */
    act_tx_pump();
}

void act_get(act_telemetry_t *out)
{
    /* s_telem is written by act_on_rx() from the FDCAN ISRs, so the copy and
       the flag clear have to be one indivisible step. Otherwise an ISR landing
       mid-copy yields a mix of two different ticks, and a freshness flag set
       between the copy and the clear is lost forever. */
    uint32_t primask = critical_enter();

    *out = s_telem;

    for (int j = 0; j < NEXUS_NUM_JOINTS; j++)
    {
        out->pos_age[j]  = s_pos_age[j];
        s_telem.flags[j] = 0;
    }

    critical_exit(primask);
}
