vismay5559/stm32_zeuss/tools/hosttest/test_enc_as5047p.c

/*
 * Host test for enc_as5047p.c - the four sensors that measure how far each
 * leg spring has been wound up.
 *
 * That measurement is how the robot knows how hard a foot is pushing on the
 * ground, so a wrong reading accepted as good is a robot that thinks it is
 * standing on something when it is not. Every sensor word carries its own
 * check digit and its own "I am unwell" flag, and the whole point of this
 * file is that both are honoured.
 *
 * Each sensor sits behind its own chip select on a shared SPI bus, and they
 * are read one after another in NEXUS_ENC_* order. The
 * other half of this file is what happens when a reading never arrives. The
 * sensors are read by the hardware on its own, in the background, and the
 * driver is told afterwards. If that "afterwards" never comes - a bus glitch,
 * an aborted transfer - the driver used to wait forever, handing out its last
 * readings as though they were current.
 *
 * Vocabulary:
 *
 *   word       the sixteen bits one sensor sends back. Fourteen are the
 *              angle, one says the sensor is unhappy, one is the check digit.
 *   check digit  a single bit chosen so the number of 1s in the word is even.
 *              Flip any one bit in transit and the count goes odd, which is
 *              how a corrupted word is spotted.
 *   CS         the wire that says "I am talking to you now". One per SENSOR,
 *              held low for that sensor's read and released afterwards.
 *              Exactly one may be low at a time: two sensors driving MISO
 *              together is a bus fight, and the data is whatever wins.
 *   in flight  a read that has been started but not yet answered.
 *
 * This replaced two daisy chains of two, where the order of the words coming
 * back carried meaning and a swapped pair of wires silently swapped two
 * springs in the data. One select per sensor removes that: a reply can only
 * have come from the sensor that was selected.
 */

#include "enc_as5047p.h"
#include "link_proto.h"
#include "main.h"

#include <stdio.h>
#include <string.h>

static int s_fail;

#define CHECK(cond, fmt, ...)                                            \
    do {                                                                 \
        if (!(cond)) {                                                   \
            s_fail++;                                                    \
            printf("  FAIL  " fmt "\n", ##__VA_ARGS__);                  \
        }                                                                \
    } while (0)

#define ERROR_FLAG     0x4000u
#define ANGLE_MASK     0x3FFFu
#define READ_ANGLE     0xFFFFu
#define READ_ERRFL     0x4001u
#define TIMEOUT_TICKS  5      /* must match ENC_XFER_TIMEOUT_TICKS */

#define ALL_VALID      0x0Fu
#define BIT(e)         ((uint8_t)(1u << (e)))

/* ---- building a sensor word the way the sensor does ------------------ */

static uint16_t with_check_digit(uint16_t payload)
{
    uint16_t v = (uint16_t)(payload & 0x7FFFu);
    uint16_t x = v;

    x ^= (uint16_t)(x >> 8);
    x ^= (uint16_t)(x >> 4);
    x ^= (uint16_t)(x >> 2);
    x ^= (uint16_t)(x >> 1);

    return (uint16_t)(v | (uint16_t)((x & 1u) << 15));
}

static uint16_t good_word(uint16_t angle)
{
    return with_check_digit((uint16_t)(angle & ANGLE_MASK));
}

static uint16_t unwell_word(uint16_t angle)
{
    return with_check_digit((uint16_t)(ERROR_FLAG | (angle & ANGLE_MASK)));
}

/* A word the sensor would never send: one bit of it flipped in transit. */
static uint16_t corrupted(uint16_t word)
{
    return (uint16_t)(word ^ 0x0004u);
}

/* The chip selects, in the order the driver reads them. */
static const struct { const char *name; GPIO_TypeDef *port; uint16_t pin; } CS[] = {
    { "left hip",   enc_cs_l_hip_GPIO_Port,   enc_cs_l_hip_Pin   },
    { "left knee",  enc_cs_l_knee_GPIO_Port,  enc_cs_l_knee_Pin  },
    { "right hip",  enc_cs_r_hip_GPIO_Port,   enc_cs_r_hip_Pin   },
    { "right knee", enc_cs_r_knee_GPIO_Port,  enc_cs_r_knee_Pin  },
};

static int cs_released(int dev)
{
    return HAL_GPIO_ReadPin(CS[dev].port, CS[dev].pin) == GPIO_PIN_SET;
}

/* How many sensors are selected right now. Must never exceed one. */
static int cs_held_count(void)
{
    int n = 0;
    for (int i = 0; i < NEXUS_NUM_ENCODERS; i++)
    {
        n += !cs_released(i);
    }
    return n;
}

static int all_cs_released(void)
{
    return cs_held_count() == 0;
}

static void fresh_board(void)
{
    host_spi_reset();
    host_release_all();
    enc_init();
}

/* Answer the one sensor in flight. */
static void reply_one(uint16_t word)
{
    host_spi_reply(&word, 1u);
}

/* A whole tick: start, then each sensor answers in turn. */
static void one_read(uint16_t l_hip, uint16_t l_knee, uint16_t r_hip, uint16_t r_knee)
{
    enc_start_read();
    reply_one(l_hip);
    reply_one(l_knee);
    reply_one(r_hip);
    reply_one(r_knee);
}

static void one_good_read(uint16_t l_hip, uint16_t l_knee, uint16_t r_hip, uint16_t r_knee)
{
    one_read(good_word(l_hip), good_word(l_knee), good_word(r_hip), good_word(r_knee));
}

/* ===================================================================== */
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
