vismay5559/stm32_zeuss/(commit log)

2026-07-31 Fix DMA cache coherency, CAN TX loss, IMU hang, and data races
    Four defects found while verifying the config against the intended
    1 kHz / 400 Hz IMU / CAN-FD workload:
    MPU region 2 covered 0x0 instead of 0x24070000, so every buffer in the
    "noncacheable_buffer" section was actually normal cached memory. DMA wrote
    real RAM while the CPU read stale cache lines - intermittent corruption on
    encoders, IMU and USB. Fixed in the .ioc and the generated Boot config, and
    app_init() now verifies the linker symbols land inside the MPU region so a
    CubeMX regeneration cannot silently undo it.
    imu_service() treated the HAL's callback size as a ring write index, but in
    circular mode the HAL reports RxXferS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
    [act_odrive.c, act_odrive.h, app.c, app.h, critical.h, imu_bno085.c, imu_bno085.h, link_usb.c]
2026-07-31 Fix XIP boot: octal-mode SFDP, XSPI2 re-init, and USB PHY regulators
    The Appli never ran. Three independent faults, each silent - no crash, no
    message, just a frozen CPU. Found by bisecting with LEDs, then by enabling
    the SFDP driver's built-in tracing over the ST-LINK virtual COM port.
    1. EXTMEM_Init() failed with ERROR_DRIVER at SFDP step 11 - re-reading the
    SFDP header through the freshly configured 8-line octal mode. Steps 1-10
    pass and the flash ID reads correctly (0xC2/0x81/0x39 = Macronix
    MX25UW25645G), so the part and wiring are fine; only the switch into octal
    mode fails. Dropped to EXTMEM_LINK_CONFIG_1LINE, which initialises cleanly
    and maps correctly. This costs in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
    [app.c, extmem_manager.c, main.c]
2026-07-31 Fix XIP boot: octal-mode SFDP, XSPI2 re-init, and USB PHY regulators
    The application never ran. Bisecting with LEDs, then with the ST-LINK virtual
    COM port once serial was available, found three independent faults.
    EXTMEM_Init() failed with ERROR_DRIVER. Enabling the SFDP driver's own trace
    (EXTMEM_DRIVER_NOR_SFDP_DEBUG_LEVEL + EXTMEM_MACRO_DEBUG) showed steps 1-10
    succeeding - the flash answers and reports its correct Macronix ID
    0xC2:0x81:0x39 - and step 11 failing: re-reading the SFDP header through the
    freshly configured octal mode. Dropping to EXTMEM_LINK_CONFIG_1LINE makes the
    whole chain pass and the XIP mapping return the Appli's real vector table, so
    the fault is specifically the s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
    [app.c, main.c]
2026-07-31 Add subsystem health tracking with red-LED blink codes
    Three LEDs cannot cover six subsystems, so instead of one LED each this keeps
    a bitmask and blinks the first fault as a count on the red LED: 1=IMU,
    2=encoders, 3=CAN1, 4=CAN2, 5=Pi link, 6=loop overrun. One LED diagnoses the
    whole system from across the room, and the same bitmask is what the Pi should
    eventually receive - so the bench diagnosis and the logged one are one value.
    "Healthy" deliberately means data is flowing, not that the peripheral
    initialised. Everything currently initialises cleanly with nothing plugged in,
    which tells you nothing; a peripheral with no cable should read as a fault.
    Each check watches a counter that onl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
2026-07-31 Add README and stop tracking IDE state
    Documents the two-binary XIP boot chain, the verified clock tree, the
    directory split between generated code and Appli/App, build and flash
    commands (the Appli needs an external loader, the Boot does not), the LED
    blink codes and serial diagnostics, and the four known issues - 1-line flash
    mode, the disabled MX_XSPI2_Init, the MPU region requirement, and CAN load.
    Also records what is genuinely unverified: every external interface
    initialises cleanly but no hardware is attached, so none has moved real data.
    Drops .settings/ and most of .vscode/ from tracking - CubeIDE workspace state
    and machine-specific include paths. Keeps .vscode/launch.json, which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
2026-07-31 Add CAN-FD single-leg test mode
    Bringing hardware up through the full robot loop is the worst case: every
    peripheral runs at once, so a failure has six possible causes. Adds a
    build-time mode selector (Appli/App/nexus_mode.h) and the first single-purpose
    mode, which exercises FDCAN1 and nothing else.
    Four ODrive S1 axes - hip roll, hip pitch, knee, ankle - with 1 TX
    (Set_Input_Pos) and 2 RX (Get_Encoder_Estimates, Get_Torques) each, plus the
    heartbeat. Node IDs, amplitude and framing are constants at the top of the
    file. A per-node status table goes out on the serial console every second
    showing message counts, live values, axis state and error word.
    Commands go out one node per tick, roun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
    [main.c, nexus_mode.h, test_leg_can.c, test_leg_can.h]
2026-07-31 Drive all leg joints at 1 kHz via a software CAN TX queue
    Round-robin gave each joint only 250 Hz. Commanding all four every tick means
    four frames against a hardware TX FIFO fixed at three, so frames now pass
    through a software queue that tx_pump() drains from the main loop as space
    frees. LEGTEST_TX_DIV still allows 250 Hz per joint for early bring-up.
    When the queue fills it discards the OLDEST entry rather than the newest.
    These are position setpoints: a stale setpoint is worthless and the newest is
    exactly what the actuator should get. Dropping the newest would leave the
    queue holding seconds-old commands that replay when the bus recovers.
    Adds an estimated bus-load figure to the repo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
    [test_leg_can.c]
2026-07-31 Arm leg-test axes over CAN, and enable float printf
    Set_Input_Pos only sets a target - an IDLE axis accepts it and stays
    unpowered - so the test now sends Set_Axis_State(CLOSED_LOOP_CONTROL) over
    CAN. Motors become live, which changes the safety profile of this mode, so:
    - arming waits LEGTEST_ARM_DELAY_MS (3 s) with a countdown printed on serial,
    because a reset must never energise motors instantly
    - commanded position is held at zero through the delay so nothing lurches
    the moment the axes come live
    - only axes reporting err=0 and an actual heartbeat are armed. Repeatedly
    forcing a faulted axis back into closed loop fights whatever protection
    tripped it, which is the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
    [test_leg_can.c]
2026-08-01 Add BNO085 IMU test mode
    Third single-purpose mode: exercises USART1 only and prints the quaternion,
    linear acceleration and angular velocity from the BNO085 at the 400 Hz the
    driver requests over SHTP.
    Data lines are throttled to 5/s because 115200 baud cannot carry 400 - and
    neither can a human read them - but the sample RATE is measured over every
    sample, so throttling can never hide a rate problem.
    Adds two counters to the IMU driver, because three quite different failures
    otherwise look identical from the outside as "no IMU data":
    bytes == 0 nothing on the wire: TX/RX swapped, no power,
    no common ground
    bytes > 0, frames == 0 by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
    [imu_bno085.c, imu_bno085.h, main.c, nexus_mode.h, test_imu.c, test_imu.h]
2026-08-01 Remove XSPI2 from the Appli context
    The Appli executes in place from the flash behind XSPI2, so the generated
    MX_XSPI2_Init() tore down the memory mapping it was running through and hung
    the bus on the next instruction fetch. Commenting the call out worked, but
    CubeMX regenerated it every time - a permanent trap.
    XSPI2 is now removed from the Appli context in the .ioc, so nothing is
    generated to comment out: no handle, no init function, no MSP callbacks. Boot
    keeps the peripheral, which is correct - it configures the flash and maps it
    before jumping, and the Appli only executes from what Boot set up.
    Also makes the USB voltage detector non-fatal in both projects. CubeMX wraps
    it in a check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
    [main.c]
2026-08-01 Port SE_K(3) Lie group maths to fixed-size C
    First piece of the contact-aided InEKF port from zeus_26's Python
    implementation. Notation and equation numbers follow Hartley et al. 2019.
    Two structural departures from the NumPy original, both forced by running in a
    1 kHz control loop:
    Fixed size rather than dynamic. The Python resizes X and P with numpy whenever
    a foot lands or lifts. There is no allocator here and none is wanted on this
    path, so every matrix is declared at its two-contact maximum (7x7 group, 21x21
    error state) with an active count saying how much is in use. Error-state
    matrices keep a constant stride whatever N is, so indexing never changes when
    contacts come and go - only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
    [lie_group.c, lie_group.h]
2026-08-01 Port leg forward kinematics and Jacobian to C
    Second piece of the InEKF port. Gives the foot contact position in the body
    frame plus its 3x4 Jacobian w.r.t. the four leg joints, which is what turns
    encoder noise into a measurement covariance in the filter update.
    Two changes from the Python:
    The chain is only Y and X rotations plus -Z translations, so instead of
    building and multiplying eight 4x4 homogeneous transforms it collapses into a
    running (R, p) pair updated in place. The Jacobian calls FK repeatedly, so this
    matters: the original would be ~40 4x4 products per foot per filter step.
    Central differences with eps=1e-3 instead of forward differences with 1e-6.
    In single precision the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
2026-08-01 Port the contact-aided right-invariant EKF to C
    Third and last piece of the port from zeus_26's zeus_sensor_fusion. Predict,
    contact update, and contact add/remove, following Hartley et al. 2019.
    X is stored as separate R, v, p and per-contact vectors rather than the dense
    (5+N)x(5+N) matrix the Python keeps: the lower rows of that matrix are always
    identity, so carrying them only buys multiply-by-zero. Contacts are fixed slots
    with an active flag instead of a resizing matrix - marginalising a lifted foot
    becomes zeroing its rows and columns, which leaves every other index untouched.
    Two bugs in the Python are fixed rather than reproduced:
    The measurement was never used. update_contact co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
    [inekf.c, inekf.h]
2026-08-01 Correct the InEKF against Hartley et al. 2019
    Checking the port line by line against the paper found two defects, both
    inherited from the Python.
    Phi(phi,phi) was Gamma0^T; equation 58 gives IDENTITY for the right-invariant
    filter. Gamma0^T belongs to the LEFT-invariant Phi^l of equation 55, where the
    error lives in the body frame. This is not cosmetic: an identity block is
    exactly why the right-invariant error dynamics do not depend on the state
    estimate, which is the property the whole method rests on. With Gamma0^T there
    the filter quietly degrades into the state-dependent linearisation the paper
    compares against and beats.
    Q_bar dropped the adjoint's off-diagonal coupling. Equation 28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
    [inekf.c]
2026-08-01 Document the paper cross-check in the README
    Records which equations were verified, the two defects found (identity Phi
    block, full-adjoint Q_bar), the approximations that remain and why they are
    acceptable, and that the fused_* fields still go to the Pi as zeros because
    nothing calls the filter yet.
2026-08-01 Protocol v2, and a Python counterpart for the Pi side
    Reworks the wire format so zeus_26 can be built against it, and adds
    pi/nexus_proto.py as the canonical Python definition plus tools/check_proto.py
    to keep the two honest. The checker compiles a probe that prints the real
    offsetof() for every field and compares it against the Python struct format, so
    a mismatch is caught instead of appearing later as subtly wrong sensor values.
    Three changes to the format:
    Every 4-byte field now sits on a 4-byte boundary. The struct is packed, so the
    old layout put act_pos at offset 70 and every actuator float after it was
    misaligned: the M7 emits byte-wise access for those, and numpy cannot view the
    bu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
    [app.c, link_proto.h, nexus_proto.py]
2026-08-02 Wire the estimator into the control loop
    Adds fusion.c as the bridge between the sensors and inekf.c. The filter itself
    knows nothing about this robot; everything robot-specific lives here - which
    encoder is which joint, what units each sensor reports, when a foot counts as
    planted, and when the estimate can be trusted. That split is what lets the
    filter be tested against synthetic data without dragging in the whole robot.
    Joint angles come from two subsystems and the mapping is written out
    explicitly: SEA joints (hip pitch, knee) from the AS5048A encoders in radians,
    QDD joints (hip roll, ankle) from ODrive act_pos in turns. Getting that table
    wrong yields a foot position that is confident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
    [app.c, fusion.c, fusion.h, inekf.c]
2026-08-02 Add a Pi-side reader that actually sustains 1 kHz
    The firmware puts 1000 packets/s on the wire, but whether they reach a Python
    control loop depends entirely on how fast the Pi reads. A loop at 250 Hz taking
    one packet per step falls three packets further behind every step, and nothing
    reports it - the data just gets older.
    pi/nexus_link.py decouples the two: a background thread drains the port at
    1 kHz, latest() hands the control loop the newest packet, and drain() keeps
    every packet when logging wants them. Link health (loss_rate, seq_gaps,
    junk_bytes) is counted rather than assumed.
    Two things in nexus_proto.py had to change first, both found by measuring:
    - crc16() was a pure-Python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
2026-08-02 Fix the USB TX buffer race, and stop calling fixed bugs known issues
    link_usb_send_state() copied the packet into the DMA buffer and only then
    called CDC_Transmit_HS, which returns BUSY without sending. When the host was
    slow the copy had already overwritten the buffer the USB core was still reading
    out, so the Pi received a packet that was half one tick and half the next. Its
    CRC failed, so nothing wrong ever reached the policy - but the packet was lost
    and nothing counted it.
    Ask before copying instead. TxState only goes 0 -> 1 inside CDC_Transmit_HS,
    which only this function calls, so a zero read cannot go stale underneath us.
    Drops are counted and printed in the status line, where they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
    [app.c, link_usb.c, link_usb.h]
2026-08-05 Bring up the BNO085 over UART-SHTP
    Squashed from 23 commits of hardware bring-up. Working IMU: live quaternions
    with |q| = 1.000, gyro at ~420 Hz settling to 0.01 rad/s at rest, and megabytes
    through the link with two errors total.
    Three real bugs, all found against the CEVA datasheet:
    Byte pacing. Section 1.2.3.1: "Bytes sent from the host to the BNO08X must be
    separated by at least 100us." We sent frames back to back at 3 Mbaud - 3.3 us
    per byte, thirty times too fast - so everything after the first byte of every
    frame arrived mangled. The rule is one-directional, which is exactly why the
    sensor's own transmissions parsed perfectly while every frame we sent came
    back as an SH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
    [imu_bno085.c, imu_bno085.h, link_proto.h, nexus_proto.py, test_imu.c]
2026-08-05 Protocol v3: the policy block, and the reference gait hardcoded
    The Pi packet now carries one contiguous run of 52 float32 starting at byte 12,
    holding exactly what the RL observation needs in the order it expects. The Pi
    slices it with numpy and copies nothing:
    obs = np.frombuffer(raw, "<f4", count=52, offset=12)
    Everything in it is a raw SI quantity. The STM32 applies no policy scaling - no
    target-height subtraction, no clipping, no sin/cos, no normalisation - so the
    observation transform can change without reflashing the robot.
    Changes from the layout Vedant sent:
    spring_angle[4] replaces spring_force[4]. The after-spring encoders measure
    spring DEFLECTION; converting that to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
    [reference_gait_rleg_40ms_250hz.xlsx]
2026-08-05 README: bring it up to protocol v3, the gait, and a working IMU
    The README still described the 326-byte v2 packet, an IMU that had never moved
    a byte, and a leg test driving a sine wave. All three are out of date.
    What changed:
    "What the Pi receives" rewritten around the policy block - the 52-float
    contiguous run, what each field means, and the four that are easy to
    misread: spring_angle is deflection not a joint angle, vel_hdg is the heading
    frame not the world, foot_z is computed during swing too, and ref_angle and
    phase read zero until the gait library runs on the STM32.
    The IMU section now documents a working sensor rather than an untested
    driver, including the three bug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
2026-08-12 Leg test: one actuator, and listen to the bus before talking to it
    Reconfigured for a single ODrive - the knee, node 3 by default - with the node
    id and gait column per joint in one table at the top. Adding drives later means
    adding rows, not editing the loop.
    Two things were wrong for a first bring-up:
    The RX filter started at node 1. ODrive ships with node_id 0, so a drive nobody
    had configured yet was invisible to us and looked exactly like a dead bus. The
    filter now accepts the whole standard id space, 0x000..0x7FF, which is every
    node from 0 to 63.
    And the test transmitted immediately. ODrive sends a heartbeat unprompted about
    every 100 ms, so a silent window at startup answers the q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
    [nexus_mode.h, test_leg_can.c]
2026-08-12 Decode CAN frames onto the serial console
    Confirmed against the generated MSP rather than the README: PB8 is FDCAN1_RX,
    PD1 is FDCAN1_TX, and the leg test drives hfdcan1. FDCAN2 sits on PB5/PB6 and
    is unused.
    Added a frame trace, because for bring-up the question is almost never what
2026-08-12 Report the CAN controller state, which is what explains a silent bus
    On hardware: tx=0, rx=0, txfail=0, qdrop climbing at ~1000/s. The software
    queue was filling and never draining, and none of the existing counters could
    say why - tx_pump was bailing on a hardware FIFO that stayed full, and nothing
    reported the one register that explains it.
    CAN is acknowledged. Every transmitter needs at least one other node to pull
    the ACK slot low, so a lone node retries the same frame forever, its transmit
    error counter climbs, and at 255 the controller takes itself BUS-OFF and stops
    entirely. From outside that is indistinguishable from a peripheral that was
    never started: no TX, no RX, queue backing u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
    [test_leg_can.c]
2026-08-12 Show what the drive actually speaks, and keep the first error code
    Hardware result: 8731 frames received from node 3 - heartbeats, encoder
    estimates and torques. The wiring, the transceiver's receive path, the
    termination, the node id and the 1 Mbit nominal bitrate are all confirmed.
    TEC climbs to 248 and REC stays at 0, so the failure is entirely ours: our
    frames are not reaching the bus, nobody acknowledges them, and the controller
    takes itself bus-off - which stops reception too, which is why a working
    receive path went dead a second after boot.
    Two additions to separate the two remaining causes.
    The trace now prints whether each received frame is FD or CLASSIC and whether
    the sender us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
    [test_leg_can.c]
2026-08-12 Use classic CAN: the drive does not speak FD
    The frame trace answered it. Every frame from node 3 decodes as CLASSIC, so
    whatever the 5 Mbit data rate in the drive's config means, it is not
    transmitting FD on the wire and will not acknowledge FD frames from us either.
    That single mismatch produced a failure that looked nothing like its cause.
    Reception was flawless - 8731 frames, REC=0 - while our own transmit error
    counter climbed to 248 and took the controller bus-off, which then killed
    reception too. A receive path that worked perfectly, appearing completely dead
    one second after boot.
    Both the leg test and the full-robot driver now send classic frames at the
    1 Mbit nominal rate this bu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
    [act_odrive.c, test_leg_can.c]
2026-08-12 Record the measured bus load: one node fills 39% of the wire
    From hardware, one actuator: tx=1000 rx=2247, bus~39%. The drive streams
    encoder estimates and torques at ~1120 Hz each, which is what dominates -
    roughly 3250 frames per second, and a classic 8-byte frame is about 108 bits.
    The previous numbers here were estimates and they were optimistic. Five nodes
    at these rates is not "too high", it is arithmetically impossible: about 195%
    of a 1 Mbit bus. Even two nodes is already past usable.
    Dropping torque telemetry to 100 Hz on the ODrive takes one node to roughly
    23%, which is still around 115% for five. A full bus needs either a 2 Mbit
    nominal rate or encoder estimates below 1 kHz - a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
2026-08-12 Set the controller mode before arming, and bound the gait to one cycle
    On hardware the drive armed cleanly - state=8, err=0 - and received commands
    that were exactly right: cmd cycled 0.0828, 0.0728, 0.0713 against a knee range
    of 0.0709 to 0.0840. It produced 0.001 Nm and did not move.
    Set_Input_Pos only means anything in POSITION control with PASSTHROUGH input.
    In any other mode the drive accepts the frame, stores nothing useful, and
    generates no torque - armed and still while every counter looks perfect. We
    never sent Set_Controller_Mode at all, so the behaviour depended entirely on
    whatever odrivetool last saved. Now sent explicitly at arm time, before the
    state change, since arming int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
2026-08-12 Add a velocity poke, to find out whether the drive can produce torque at all
    State on hardware: armed, unfaulted, receiving 1000 correct position commands
    per second, sitting 0.37 turns from target and generating 0.003 Nm. The
    position it reports did change between runs - 0.0000 to 0.4445 - so the encoder
    is live and the axis is not mechanically stuck. It simply is not acting on
    position error.
    Everything on our side is now proven: TEC and REC are zero, the drive
    acknowledges every frame, Set_Controller_Mode goes out before arming, and the
    commanded values match the trajectory exactly. What is left is entirely inside
    the drive's configuration, and guessing at it from here has stopped being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
    [test_leg_can.c]
2026-08-12 Add a joint zero offset, and explain the ramp in the arming log
    Set_Input_Pos values are output-side turns and the drive handles the gearbox,
    so degrees/360 is the whole conversion and it was already right. What was
    missing is where the gait's zero sits in the drive's coordinates.
    The trajectory is joint angles in the simulator's convention. The drive
    measures from wherever it was homed. Nothing makes those agree, and the
    symptom is a large move at arming: the leg sat at 0.4445 turns while gait
    sample 0 asks for 0.0728, a third of a turn apart. The ramp was absorbing that
    mismatch, which made it look like part of the trajectory when it is really a
    move-to-start.
    s_zero_offset per joint clo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
    [test_leg_can.c]
2026-08-12 Play the hip pitch column, and report travel before moving
    The gait column is now independent of what the actuator is physically bolted
    to. On the bench the drive is a knee, but any column can be played through it -
    which is the point, since the columns have very different ranges and hip pitch
    moves nearly three times as far as the knee.
    Two things about this column are worth knowing before it runs. It is entirely
    NEGATIVE, -0.0570 to -0.0186 turns, so the joint travels the opposite way from
    the knee test. And it spans 13.8 degrees against the knee's 4.7, so the same
    speed setting produces three times the motion.
    The arming log now sweeps the whole cycle and prints the travel in turns and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
2026-08-13 Correct the CAN FD analysis: 2.5x, not a third
    I had told the user FD would save "about a third" of a frame, and the README
    concluded a full bus needed either a 2 Mbit nominal rate or slower encoder
    estimates. Both were wrong.
    Working it out properly: a classic 8-byte frame is 121 bits, of which only 64
    are payload. At 1 Mbit that is 121 us, and 3210 frames/s is 39% - which matches
    the hardware measurement exactly.
    An FD frame with BRS splits into ~29 bits at the nominal rate and ~92 at the
    data rate, giving ~47 us. That is 2.5x faster, not 5x, because the ID,
    acknowledgement and end-of-frame fields always run at the nominal rate - on a
    small frame that is half of it.
    The conclusion chang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
2026-08-13 Enable transmitter delay compensation before trying CAN FD again
    tx_brs being off explains why the drive sent classic frames. It does not
    explain why our FD frames were never acknowledged, and there is a second reason
    that would have broken FD anyway.
    In the data phase a CAN transmitter verifies its own bits by reading them back
    off the bus. At 5 Mbit a bit lasts 200 ns and the sample point sits at 150 ns.
    The ISO1042 is an isolated transceiver with a 152 ns loop delay, so at the
    instant we check, our own bit has not returned yet - we sample the previous
    one, see a mismatch, and declare a bit error. Every FD frame fails.
    Classic CAN never does this check, which is precisely why the bus is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
    [act_odrive.c]
2026-08-13 Add a stop button - there was no way to halt a running trajectory
    Flashing started the gait and nothing could stop it short of pulling power or
    reflashing. The Nucleo has a user button sitting unused; it is now a latching
    stop.
    Pressing it flushes the transmit queue, commands every axis to IDLE, and then
    stops transmitting entirely. All three matter: commanding IDLE while continuing
    to stream setpoints leaves the drive one stray re-arm away from moving, and
    queued frames would otherwise go out after the idle command.
    It does not un-press. Recovering means resetting the board, which is correct -
    something that can be un-stopped by fumbling the same button is not a stop
    button.
    It is not an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
    [test_leg_can.c]
2026-08-13 Add a Rerun live view of the robot
    The 422-byte packet already carries everything a viewer needs, so this is a
    consumer of it rather than new plumbing. It reads through NexusLink and logs
    onto one shared timeline: estimator height and heading-frame velocity, all ten
    joint positions and velocities against their reference angles, spring
    deflections, the four contacts, foot heights, gait phase, raw IMU, and the
    health byte as a plottable number.
    Everything is indexed by seq/1000 rather than timestamp_us, which wraps every
    71 minutes.
    Two reasons for Rerun over hand-rolled plots. Everything shares a timeline, so
    "what were the springs doing when that foot landed" is answered by dragging
    rather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
2026-08-13 Explain where the Rerun viewer runs, and support all three ways
    The first version called rr.spawn(), which opens a viewer on the machine
    running the script. On a headless Pi that is useless, and it left the obvious
    question unanswered: how do you actually see this on a laptop.
    Rerun splits into an SDK and a Viewer and they need not share a machine. That
    split is the answer:
    STM32 --USB--> Pi --network--> laptop
    SDK Viewer
    --connect HOST stream to a viewer on the laptop, port 9876. Live.
    --save FILE.rrd record now, copy the file over, open it later. No network,
    and better for anything too fast to watch as it happens.
    --spawn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
    [zeus_viz.py]
2026-08-14 Document the Rerun pipeline, wired and wireless
    Wireless works and is the intended setup: Rerun streams over plain TCP on port
    9876, so the Pi on Wi-Fi and the viewer on a laptop is exactly what the SDK and
    Viewer split is for. Decimated to 200 Hz the stream is a few hundred KB/s,
    which is nothing for 802.11n. Latency runs 5 to 50 ms with jitter, irrelevant
    for watching and the reason this is only ever for watching.
    Stated plainly in the README that nothing which commands the robot goes over
    Wi-Fi. A dropped viewer connection must be a blank screen, never a stalled leg.
    Four ways to run it, in the order they become useful: record to a file and open
    it later (no network, and scrubbable - mo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
2026-08-15 Enable CAN FD, and restore the controller-mode call that had been lost
    tx_brs is on at the drive now, so LEGTEST_USE_CAN_FD goes to 1. Transmitter
    delay compensation enables itself with it.
    More importantly: send_controller_mode() was defined but never called. The
    compiler said so and the warning had been sitting in the noise. An earlier edit
    had not applied - the file uses CRLF and the multi-line pattern silently missed
    - so the arming path went straight to Set_Axis_State, exactly the bug that left
    the drive armed, commanded and producing no torque. Restored, and sent before
    the state change rather than after, since arming into the wrong mode energises
    the axis into whatever odrivetool las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
    [test_leg_can.c]
2026-08-15 Actually configure transmitter delay compensation, before Start()
    FD reception works: the drive sends FD +BRS on every frame and REC stays at 0,
    so tx_brs did its job and both ends agree on the data-phase timing for receive.
    Transmission went bus-off on the first frame - tx=1, then TEC=248. The reason
    was not subtle: the TDC block was never in the file. An earlier edit had
    silently missed, the same CRLF pattern failure that had also dropped
    send_controller_mode, so FD was running with no delay compensation at all.
    Without it, at 5 Mbit the transmitter samples its own echo at 150 ns while the
    ISO1042's isolated loop delay is 152 ns. It reads the previous bit every time,
    declares a bit error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
    [test_leg_can.c]
2026-08-15 Fix the stop button polarity - it was latching at boot every run
    CAN FD is working: TEC=0, REC=0, FD +BRS on every frame, bus load down from 39%
    to 10%. Transmitter delay compensation was the missing piece.
    But tx=0 and the axis never armed, and the reason was the stop button. The BSP
    configures that pin with GPIO_PULLUP, so it reads 1 released and 0 pressed. The
    check tested for non-zero, which is released - so the stop latched on the first
    tick of every run, before anything could happen.
    The symptoms were a good imitation of a dead command path: nothing transmitted,
    never armed, gait clock running to completion having commanded nothing. The
    give-away was in an earlier log, where the STOP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
    [test_leg_can.c]
2026-08-15 Capture the trajectory on the STM32 and dump it as CSV
    The leg moves but less than commanded, and a once-a-second report cannot show
    a 3.2 second trajectory - by the time a line is readable the interesting part
    is over. No Pi needed for this; the board has the data and a serial port.
    Records commanded, measured, velocity and torque at 100 Hz while the axis is
    live, then prints the run as CSV when the gait completes. 512 samples covers
    5.1 s, which is one cycle at quarter speed plus the entry ramp, for 8 KB of the
    448 available.
    The summary above the CSV is the part that usually answers it: peak-to-peak
    commanded against peak-to-peak achieved, as a percentage. Tracking well means
    they match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
2026-08-15 Extract and plot the trajectory capture from a PuTTY log
    The board prints its capture surrounded by thousands of lines of CAN frame
    trace, which makes hand-extraction tedious and error-prone. This finds every
    capture in a log, validates each row rather than assuming the trace never
    interleaves, writes a clean .csv, and plots commanded against measured with the
    error and torque beneath.
    The summary is the useful part: travel commanded versus travel achieved as a
    percentage, plus WHERE in the run the worst error occurred. An even lag points
    at position gain; a lag that only appears on the fast sections points at a
    velocity limit. That distinction is the whole reason to plot rather than read
    n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
2026-08-15 Capture the gait only, not the entry ramp
    The summary reported "249% tracking" for a leg that was following correctly.
    The capture started at arming, so it recorded the two-second entry ramp as
    well as the gait, then compared the measured travel of both against the
    commanded range of the gait alone. Two different windows, one ratio, no
    meaning.
    Capture now waits for the phase clock to start. The peak-to-peak comparison is
    then between the same 3.2 seconds of commanded and measured motion, and the
    percentage means what it says.
    Nothing about the hardware changed. Holding steady, the joint sits 0.21 degrees
    from its command with TEC and REC at zero over CAN FD at 5 Mbit - the drive is
    tracki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
    [test_leg_can.c]
2026-08-16 Send velocity feedforward with the position setpoint
    Set_Input_Pos carries vel_ff and torque_ff alongside the position and both
    were hardcoded to zero, so the drive had to discover every motion from
    tracking error alone - always behind by whatever error it took to make the
    torque.
    gait_sample_vel() differentiates the table with a central difference across
    neighbouring rows, wrapping rather than clamping at the seam so the cycle
    repeat carries no false velocity step, then interpolates for continuity.
    Two scalings that are easy to get wrong and are therefore commented at the
    site: multiply by LEGTEST_GAIT_SPEED so the velocity agrees with the position
    it accompanies, and zero it once the cyc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
    [test_leg_can.c]
2026-08-16 Turn plot_run into a gain-tuning instrument
    Plotting one run tells you it was bad. Tuning needs to know whether the change
    you just made helped, so labelled runs are archived to runs/ and --compare
    overlays them with a scoreboard. The log path now defaults to where PuTTY is
    pointed, because typing it twenty times an afternoon is twenty chances to plot
    the wrong file.
    The metrics are the real change. Peak-to-peak "tracking %" flatters a joint
    that lurches past the setpoint and back - a leg thrashing at 300% of commanded
    stroke scored better than one lagging gently - so it is kept only because it
    appears in older logs, and labelled as ignorable.
    What replaces it:
    stuck mid-stroke command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
    [baseline_vg0.167_vi0.333.csv, vg0.5_vi2.5.csv]
2026-08-16 Document the gait discontinuity, feedforward and gain tuning
    The spreadsheet is not continuous. Rows 99->100 and 199->0 step about 2 deg on
    every joint while every other step in the trajectory is under 0.15 deg, and the
    two halves are not duplicates - it is two separate 0.4 s optimiser solutions
    concatenated without a periodicity constraint at either join.
    Interpolation does not rescue it. It makes position continuous and leaves
    velocity discontinuous: during those 16 ms at 0.25x the drive is commanded to
    move at 0.35 turn/s when the real gait never exceeds 0.029 turn/s. Twelve times
    the peak velocity of the actual motion, twice a cycle, on every joint at once.
    That is worth writing down b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
2026-08-16 Refuse to report metrics for a run whose telemetry died
    The firmware holds the last value it received, so a drive that faults, disarms
    or falls off the bus leaves a perfectly flat trace rather than a gap - and
    every metric then describes a corpse. The vg1.0 run went BUS-OFF 12.18 s in and
    still reported a plausible-looking RMS of 2.86 deg computed against 3.8 s of
    held values.
    A joint that is merely stuck still shows torque varying as the loop pushes and
    velocity dithering around zero. All three channels going bit-identical at once
    can only mean no frames arrived, so that is the test.
    Flagged in the per-run report before any other number, marked in the compare
    table, and excluded from "bes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
    [vg1.0_vi5.0.csv]
2026-08-16 Stop recommending vel_gain for a lag that only pos_gain can fix
    Doubling vel_gain from 0.5 to 1.0 moved nothing: RMS 2.14 -> 2.17 deg, stuck
    mid-stroke 0.8 -> 0.8 %, lag 100 -> 110 ms. The tool still said to raise it
    again, because it checked overshoot before lag.
    A proportional position loop following a ramp settles to a steady lag of
    1/pos_gain seconds regardless of vel_gain, so lag is the one symptom vel_gain
    provably cannot touch. It now takes priority over overshoot, and prints the
    pos_gain the measured lag implies - on this run 9.1 against an actual 11.892,
    which is the check that the number means something.
    Overshoot is also no longer flagged below 2.5 deg. The trajectory steps abou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
    [vg1.0_vi5.0.csv]
2026-08-16 Separate the trajectory's error from the actuator's
    Raising pos_gain 11.9 -> 20 took overshoot from 2.83 to 0.33 deg with the same
    trajectory, which disproves the claim the previous commit encoded: that the
    2 deg steps in the spreadsheet imposed a ~2 deg floor on overshoot. They do
    not. They cost error at the seams, not overshoot at the ends of the stroke, so
    OVERSHOOT_FLOOR_DEG was wrong and is gone.
    What the steps actually do, on the pg20 run:
    near a seam 304 samples RMS 1.23 deg peak torque 0.209 Nm
    everywhere else 1296 samples RMS 0.58 deg peak torque 0.164 Nm
    Twice the error and 27% more torque, in the 19% of the run next to a
    discontinuity. So the report now print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
    [vg1.0_vi5.0_pg20.csv]
2026-08-16 Idle the axes when the gait finishes instead of servoing forever
    On completion the firmware froze the phase and kept streaming that pose at
    1 kHz with the axis still in CLOSED_LOOP_CONTROL, so the motor servoed on it
    indefinitely. It never settles - the loop hunts against stiction, the
    integrator winds until the joint breaks loose, it slips, and it repeats. That
    is the creeping visible after every run, and it heats a motor for no reason.
    LEGTEST_GAIT_IDLE_AFTER (default 1) commands IDLE and stops transmitting, which
    is what "the test is over" should mean. Set it to 0 for the old behaviour.
    HAZARD, documented at the define: IDLE de-energises the motor and the joint
    goes limp. Harmless on a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
    [test_leg_can.c]
2026-08-29 Configure for the three-joint leg and scale the ankle by its gear ratio
    The assembled leg runs hip pitch (node 1), knee pitch (3) and ankle pitch (4);
    hip roll is not working and node 2 is excluded.
    Set_Input_Pos is denominated in turns of whatever shaft the ODrive's encoder is
    on, and that is not the same shaft on every joint here. Hip and knee are 47:1
    with the encoder on the load side, so a gait value goes straight out. The ankle
    is 9:1 with the encoder on the motor, before the gearbox, so the motor must turn
    nine times for one turn of the joint.
    s_cmd_scale carries that, next to the node ids rather than at the point of use,
    because getting it wrong is a 9x position error into a joint w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
    [test_leg_can.c]
2026-08-29 Drop the hand-move test, correct the telemetry rates, document zeroing
    Hip and knee are non-backdrivable, so the identity/direction/gear-ratio test
    cannot be done by hand. It moves to the first powered test, where each axis is
    armed alone and given +2 deg of output while you watch which joint responds -
    chosen so the worst case of a wrong node map is 2 deg into the wrong joint.
    Corrects the message rates. They are encoder 1 ms, torque 10 ms, heartbeat
    10 ms, not 1/1/100. Bus budget falls from ~9030 to 6600 frames/s as a result,
    about 33% at the firmware's 50 us/frame estimate.
    Drops the torque-feedforward discussion. The field is on the wire and stays
    zero; the byte layout is documented an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
2026-08-31 Run the leg on three joints, and stop one absent drive halting the rest
    Drop the data phase to 2 Mbit. At 5 Mbit a bit is 200 ns and the ISO1042's
    152 ns loop delay is 76% of it; TDC corrects the average delay but not the
    isolator's pulse-width distortion, which is why TEC climbed to bus-off while
    REC stayed at 0 - every fault was on frames we sent. 500 ns bits give the
    margin back.
    Add the ankle as a third joint, scaled x9 for its motor-side encoder. A joint
    that misses the boot scan is now skipped rather than disabling the whole leg:
    no setpoints, never armed, out of the limit check, the summary and the CSV.
    That change needed the entry gate too, and missing it cost a run. Requiring
    n_en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
    [main.c, nexus_first.ioc, test_leg_can.c]
2026-09-05 Add STM32-side torque control beside the position mode, and move every axis to its load encoder
    Two ways to drive the same leg, selected by NEXUS_MODE:
    LEG_CAN Set_Input_Pos - the ODrive runs pos -> vel -> current
    LEG_TORQUE Set_Input_Torque - only the drive's current loop runs; the
    position and velocity loops are ours, at 1 kHz
    test_leg_torque.c computes tau = Kp*(theta_ref - theta) + Kd*(omega_ref -
    omega) at the output shaft, divides by the gearbox, clamps, and sends it.
    ODrive speaks motor-side torque only, so the reduction is crossed on the way
    out and again when reading Get_Torques back.
    Torque mode fails differently from position mode an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
    [main.c, nexus_first.ioc, nexus_mode.h, test_leg_can.c, test_leg_torque.c, test_leg_torque.h]
2026-09-05 fix(contact): foot switch bits were built from index constants
    link_proto.h names each contact twice - NEXUS_CONTACT_L_TOE as an index
    into the policy block's contact[] array, NEXUS_CONTACT_L_TOE_BIT as a bit
    in the `contacts` mask. contact_init() filled its mask table with the
    index family, which is a perfectly valid uint8_t, so it compiled silently
    and produced the mask table {0, 1, 2, 3}:
    L_TOE -> 0x00 sets no bit at all; the left toe was invisible
    L_HEEL -> 0x01 reported as L_TOE
    R_TOE -> 0x02 reported as L_HEEL
    R_HEEL -> 0x03 set two bits at once
    contact_feet() derived the per-foot bits from the same constants, so
    left-foot-down actually tracked either heel a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
    [contact.c, contact.h, hal_stub.c, main.h, test_contact.c, test_safety.c, test_watchdog.c]
2026-09-05 feat(safety): idle the actuators when nobody is flying the robot
    Four blockers from the firmware review, which turn out to be one piece of
    work: the board had no way to stop.
    **No failsafe.** app_run() handed any CRC-valid command straight to
    act_set_targets(), and s_have_target latched forever - so a Pi that
    crashed mid-stride left ten actuators servoing to its last command
    indefinitely. health.c noticed the dead link after 200 ms and did nothing
    with it: its only consumer was the red LED. NEXUS_CMD_ENABLE was defined
    in the protocol and never read, so the Pi could not stand down either.
    safety.c now owns that decision, as a latching state machine:
    BOOT --healthy--> IDLE --ENABLE-->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
    [act_odrive.c, act_odrive.h, app.c, fusion.c, health.h, main.c, nexus_link.py, nexus_mode.h]
2026-09-05 fix(estimator): stop the filter believing things it cannot know
    The nine high-severity findings from the firmware review. Most of them are
    one theme: the estimator was confident about inputs that were stale,
    repeated, or measuring something else entirely.
    **The encoders were feeding forward kinematics the wrong quantity.** The
    AS5048A units sit after the series springs and measure DEFLECTION - both
    the README ("spring_angle is deflection, not a joint angle") and app.c say
    so plainly. fusion.c alone treated them as absolute hip and knee angles,
    and fusion.c is the file feeding the filter. A raw 0..2pi deflection went
    in as a joint angle, put the foot somewhere it had never been, and the
    cont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
    [act_odrive.c, act_odrive.h, app.c, fusion.c, fusion.h, imu_bno085.c, imu_bno085.h]
2026-09-05 refactor(nexus): stop the diagnostics costing more than they report
    The thirteen medium findings from the firmware review. M3 (command
    validation) was already covered by the safety work, so twelve remain.
    **The status printf was causing the problem it reported.** ~110 characters
    at 115200 baud blocked the 1 kHz loop for ~9.5 ms and missed nine ticks,
    every two seconds - and it set the floor for the watchdog period.
    NEXUS_LOOP_STATS was defined and never tested with #if, so the "easy to
    switch off" the comment promised did not exist.
    Every counter it printed now ships in the state packet at 1 kHz, where the
    Pi can plot it against everything else that happened at the same moment:
    loop_us_max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
    [app.c, app.h, contact.c, fusion.c, health.c, health.h, imu_bno085.c]
2026-09-05 ci: build the firmware and run the host tests on every change
    Nothing checked either automatically. The host tests existed but only ran
    when someone remembered, and the firmware build was verified only on
    whichever machine last flashed a board — the code currently on main was
    merged without being compiled for the target at all.
    Two jobs, answering two different questions:
    host-tests is the logic right? tools/hosttest/run.sh on a normal
    compiler — contact, safety, fusion,
    robot_config, watchdog, plus the
    C-vs-Python protocol layout check.
    firmware does it still build?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
2026-09-05 fix(act): read the transmit error counter from the right HAL struct
    The firmware did not compile for the target:
    act_odrive.c:458: error: 'FDCAN_ProtocolStatusTypeDef' has no member
    named 'TxErrorCnt'
    HAL_FDCAN_GetProtocolStatus reports the bus state - bus-off,
    error-passive, warning - while the raw TEC and REC values live in
    FDCAN_ErrorCountersTypeDef, behind HAL_FDCAN_GetErrorCounters. The
    diagnostics work read TxErrorCnt off the status struct, which has no
    such member.
    Call the counters API for the counter and keep the status call for the
    bus state. A failed counters read leaves the previous value rather than
    reporting a fictitious zero, since zero is the healthie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
    [act_odrive.c]
2026-09-05 fix(fusion): fill the packed state through aligned locals
    GCC refused to build fusion.c:
    error: taking address of packed member of 'struct <anonymous>' may
    result in an unaligned pointer value [-Werror=address-of-packed-member]
    nexus_state_t is packed for the wire, so passing st->fused_vel and
    st->quat straight into functions that write through a float* hands them
    a pointer the compiler cannot prove is aligned. Both members sit on
    4-byte offsets today - 356 and 16, measured - so nothing was misaligned
    in practice, but that is a property of the current field order, not
    something the code states or the compiler can rely on. A field inserted
    ahead of either one would make it real,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
    [fusion.c]
2026-09-05 docs(app): explain app, encoder, contact and USB link functions
    The four headers with almost no commentary: app.h had one line for four
    functions, enc_as5048a.h and link_usb.h two, contact.h three. Someone
    reading them had to open the .c to learn what calling order was expected
    or what a return value meant.
    Each declared function now says what it does, when to call it, what it
    gives back, and - where it matters - what it deliberately does not do:
    that a valid CRC is not permission to move, that the encoders measure
    spring deflection rather than joint angle, that enc_get's valid mask has
    to be checked because a failed reading keeps its old value.
    [app.h, contact.h, link_usb.h]
2026-09-05 docs(estimator): per-function comments for critical, kinematics, fusion, watchdog
    These headers already explained themselves well at module level - what a
    critical section is for, the kinematic chain, why the watchdog is
    register-level rather than HAL. What was missing was the per-function
    line: fusion_init had no comment at all, and several others had a
    fragment that named the return without saying how to read it.
    Added only where something was missing or too thin to act on, rather
    than restating module comments that are already better than a
    per-function paraphrase would be. fusion_status now says that
    CONVERGING is where an UNCALIBRATED robot stays for good, wdg_refresh
    says it must neve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
    [critical.h, fusion.h, watchdog.h]
2026-09-05 docs: rewrite for a non-technical reader, and add a glossary
    The first pass was written for a programmer new to the codebase, not for
    someone who does not program. An audit of my own wording found 'tick'
    used 15 times, 'interrupt' 12, 'CRC' 6 and 'DMA' 5, none of them ever
    explained - so the comments only worked for a reader who already knew
    the answer.
    Appli/App/README.md now explains the recurring ideas once, in plain
    language: what a tick is, what an interrupt is, what a checksum proves
    and does not prove, what arming means, and the order the pieces run in
    each heartbeat. Headers point at it instead of re-explaining.
    The four rewritten headers lead with what the piece is FOR and why it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
2026-09-05 docs: plain-language comments for health, safety, gait, config and protocol
    Continues the pass in the same voice: say what the piece is for and why
    it matters before any detail, and keep the warnings an engineer needs.
    health_blink_code explains that the fault light can be read off the
    robot with no computer attached, and what each count means.
    safety_accept_command walks through the hurdles an instruction has to
    clear in words rather than naming the constants. robot_config_is_calibrated
    explains why design figures are not the same as a measured machine, and
    why the position estimate refuses to call itself fully trustworthy until
    someone has measured this one.
2026-09-05 docs: plain-language comments for the motors and the bench tests
    act_odrive is the biggest piece of the robot that had only a module
    comment: seventeen functions, several of which are easy to misuse. The
    comments now say which ones must not be called with unchecked input,
    that asking a motor to switch on and it agreeing are different things,
    and that a wire quietly shutting itself down looks exactly like motors
    that stopped replying.
    The three test_* headers say plainly, at the top, that they are bench
    programs rather than part of the robot - someone reading the folder for
    the first time has no way to tell otherwise.
2026-09-05 docs: plain-language comments for the estimator and movement sensor
    inekf is the hardest piece to explain and the most worth explaining: it
    is what answers 'where is the robot'. The comments now describe the idea
    rather than the mathematics - dead reckoning drifts, a planted foot is
    the one thing known not to be moving, and the disagreement between the
    two is what gets corrected. inekf_quaternion says why four numbers are
    used instead of three.
    imu_bno085 is twenty-six functions, most of them diagnostic. Each now
    says what question it answers when something is wrong: whether the
    sensor is silent, arriving but unreadable, producing some measurements
    but not others, or wired wrongly.
    [imu_bno085.h, inekf.h]
2026-09-05 docs: plain-language comments for the matrix maths
    The last file, and the one where a wrong explanation would do most harm.
    It is explained as what it is - arithmetic on small grids of numbers,
    written out by hand because the board has no maths library and the work
    has to finish inside a millisecond - rather than by naming the theory.
    A rotation is described as a grid, multiplying two as 'do this, then
    that', and the four gamma functions as one rotation integrated zero to
    three times, which is how a steady turning rate becomes a change in
    orientation, then velocity, then position. lg_matn_symmetrise says why
    it exists: rounding drift would otherwise let the estimator claim
    negative uncertai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
    [lie_group.h]
2026-09-05 ci: run the host tests under both compilers, and document the setup
    One compiler's silence is not evidence. GCC rejects a packed-member
    access in fusion.c that clang accepts without a word, and that sat
    through green local runs on a Mac - where `gcc` is Apple clang under
    another name - until CI built it with real GCC. run.sh already honours
    CC, so this is a matrix rather than a change to the script.
    The README gains a Testing section (what the host tests cover, what they
    deliberately do not, and that the App sources build against a stub HAL
    so passing them is not the same as compiling for the board) and a
    Continuous integration section. The layout listing had fallen behind:
    safety, watchdog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
2026-09-05 test(lie_group): pin the matrix maths, and fix a sign error it found
    Adds host tests for lie_group.c and corrects gamma3's S^2 coefficient,
    which the tests caught immediately.
    WHY NOT A COMPARISON AGAINST THE PYTHON
    The plan was to differential-test against zeus_sensor_fusion/lie_group.py,
    which is the stronger test where the reference is to hand. That repository
    is not on this machine, so these check the properties the results must
    have instead: a rotation undoes itself when transposed and does not
    stretch a vector, a quarter turn about z sends x to y, skew(v) really is
    the cross product, symmetrise leaves the diagonal alone. Those hold for
    the mathematics rather than for one port of it,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
    [lie_group.c, test_lie_group.c]
2026-09-05 fix(lie_group): use the series across the range the robot actually turns
    Closes #6.
    The closed forms for the Gamma coefficients subtract nearly equal
    quantities and divide by a high power of theta, so in single precision
    they lose all meaning as theta shrinks - not their last digits, all of
    it. Measured against a double reference, the f32 closed forms are wrong
    by these relative amounts:
    theta gamma1 c gamma2 c gamma3 c
    1e-3 5.3e-2 1.0e+0 6.3e+5
    1e-2 1.5e-3 1.0e+0 3.7e+2
    6e-2 3.4e-6 1.3e-2 1.8e-2
    2e-1 2.6e-6 6.9e-4 1.1e-3
    The old cutoff of 1e-4 was chosen by comparing the two error sources in
    th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
    [lie_group.c, test_lie_group.c]
2026-09-05 test(kinematics,health): cover the leg geometry and the fault logic
    Two suites, and a correction to documentation I got wrong.
    KINEMATICS
    Checks properties rather than numbers recomputed from the same chain,
    which would only prove the code agrees with itself: a straight leg hangs
    exactly its own length below the hip, swinging the hip keeps the foot on
    a circle of that radius, pitch joints never move the foot sideways,
    bending the knee shortens the reach, and no combination of joints puts
    the foot beyond the leg's length.
    The Jacobian is checked by whether it PREDICTS what the forward
    kinematics actually does for a small joint move. That is independent of
    how it is computed, so it catches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
    [health.h, test_health.c]
2026-09-05 test(gait_ref): cover the phase wrap, the interpolation and the seam
    The table itself is generated, so its contents are not the subject. What
    is tested is the sampling around it: phase wrapping, interpolation
    between rows, the seam where the last row meets the first, and that the
    reported speed is the centred slope rather than a one-sided one.
    THE TWO DOCUMENTED TABLE STEPS
    The smoothness test found the hip discontinuities at rows 99->100 and
    199->0 straight away - 0.0055 turns against a typical 0.0003. README.md
    already documents both, as a defect in tools/gen_gait.py rather than in
    this file, so the test excludes those two points and a separate test
    pins them: if the generator is fixed t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
    [test_gait_ref.c]
2026-09-05 test(inekf): drive the filter with motion whose answer is known
    A filter is easy to test badly: "it runs and produces no NaN" passes
    while the estimate is quietly wrong, and nothing downstream can tell a
    confident wrong answer from a right one. So each test drives it with
    motion that has an answer independent of how the filter works.
    Held still, it must not run away. In free fall - where an accelerometer
    reads zero, because nothing is pushing back - it must accelerate
    downwards at g, which is the sharpest check on the sign of gravity;
    inverted, the robot believes it is flying. Spun a quarter turn about z,
    the reported orientation must be that quarter turn and nothing else.
    After ten seconds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
    [test_inekf.c]
2026-09-05 test(link_usb): cover the command path from the Pi (#10)
    * test(link_usb): cover the command path, and stop relying on int promotion
    Every instruction the robot acts on arrives through this file. safety.c
    can only judge a command it received correctly, so a framing mistake
    upstream of it means acting on something the Pi never sent, with nothing
    downstream able to tell.
    The tests drive the parser the way USB actually delivers: a frame split
    into 1, 2, 7, 31 and 64-byte pieces must reassemble identically; noise
    before a frame must not stop it being seen; a damaged frame must be
    refused and not counted; two frames in one delivery must both be seen
    with the newest kept. Outgoing, a report must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
    [link_usb.c, main.h, test_link_usb.c]
2026-09-05 test(act_odrive): cover the path from a target to the motors (#11)
    act_odrive.c is the file that actually moves the robot. Everything else
    decides what the legs should do; this is what tells them. It had no test
    of any kind, because testing it needs the two CAN wires, and those only
    exist on a bench.
    They exist here now. tools/hosttest/stub/fdcan.h is a working model of
    the FDCAN peripheral rather than a set of empty functions: a transmit
    queue three frames deep, like the real part, that refuses a fourth
    instead of silently dropping it; a receive queue a test can feed; and
    the error reporting the driver reads. So a test can watch every frame
    the firmware puts on the wire, and can make a wir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
    [act_odrive.c, fdcan.h, fdcan_stub.c, main.h, test_act_odrive.c]
2026-09-05 test(enc_as5048a): cover the spring-encoder reads (#12)
    The four AS5048A sensors measure how far each leg spring has been
    squashed, which is how the robot knows how hard a foot is pushing on the
    ground. A wrong reading accepted as good is a robot that believes it is
    standing on something when it is not.
    Every word a sensor sends carries its own check digit and its own "I am
    unwell" flag. Eight tests, and the one that earns its keep sweeps every
    single-bit flip in every position across eight different angles - 128
    corrupted words, all of which must be refused, plus the clean word which
    must not be. A check digit computed over the wrong range of bits still
    looks right for most words, so sampl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
    [dma_buffer.h, link_usb.c, main.h, spi.h, spi_stub.c]
2026-09-06 Make nexus_mode.h actually select the mode, and let LEG_TORQUE build
    The header could be edited to any value with no effect on the binary. The
    build defaulted NEXUS_MODE to NEXUS_MODE_ROBOT and passed it unconditionally
    as a compile definition, so the #ifndef in the header was never reached. The
    one file that looks like the mode switch was dead code.
    NEXUS_MODE now defaults to empty in CMake and is only defined when someone
    actually asks for one, so with no -D and no environment variable the header
    decides. Configure says which of the two is in force rather than leaving it to
    be inferred from the binary:
    Nexus mode: from Appli/App/nexus_mode.h
    Nexus mode: NEXUS_MODE_LEG_CAN (overr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
2026-09-06 Push the controller gains from legtest_init, drop the per-boot encoder write
    The gains for all three drives now come from s_pos_gain[] / s_vel_gain[] /
    s_vel_int_gain[] and are sent once at init, so tuning is one table in one file
    rather than three odrivetool sessions. They were previously sent at arming and
    two of the three entries were GAIN_KEEP, which left the hip and ankle on
    whatever happened to be saved in each drive.
    Remove apply_encoder_config() and the SDO machinery behind it. Writing
    spi_encoder0.config.max_error_rate on every boot was never meant to be
    permanent - encoder configuration belongs in the drive, set once, not
    re-asserted by the controller every time it powers up. 268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
2026-09-06 Start the gain table at the tuned 20 / 1.0 / 5.0, not an unvalidated guess
    4.0 / 20.0 was a value pushed to the knee mid-debug that was never validated -
    its encoder failed before the large excursion, so that run proved nothing.
    20 / 1.0 / 5.0 is where the README campaign actually finished: vel_gain 0.167
    -> 0.5 -> 1.0, RMS error 12.16 -> 2.14 -> 0.75 deg.
    Record in the comment that this is a starting point rather than the answer.
    That campaign predates moving every axis to its load-side encoder, and
    vel_gain is motor Nm per encoder turn/s - reading the load side divides the
    measured velocity by the gear ratio, so the same number makes far less torque
    for the same motion. The logs already s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
    [test_leg_can.c]
2026-09-07 The Pi sends a residual now, not an absolute target
    The board played no reference at all: app.c zeroed ref_angle and phase every
    tick, and whatever the Pi sent went straight to the drives. That put the entire
    trajectory on the far side of a USB link, so a Pi that stopped talking left ten
    actuators holding its last command with nothing to fall back to.
    The stride now lives on the board. A free-running phase clock at 1 kHz drives
    gait_sample(), and the Pi's command is added on top:
    drive_target[j] = ref_angle[j] + residual[j]
    Send zeros and the robot walks the stored gait unaided, so a policy that stops
    sending degrades to a nominal walk rather than to nonsense.
    nexus_cmd_t.target_pos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
2026-09-07 Finish the target_pos rename - two host tests and the Pi link were left behind
    e5ab2bc renamed nexus_cmd_t.target_pos to .residual and missed three callers,
    so CI failed to compile all three host-test jobs while both firmware builds
    passed - the split the CI comments predict, since the host tests build App
    sources against a stub HAL and the firmware does not use these files.
    test_link_usb.c referenced the field directly and through offsetof. nexus_link.py
    passed target_pos= to NexusCommand, which would have failed at runtime on the
    Pi rather than at import, so nothing in CI would have caught it.
    Found by grepping the tree rather than the three files changed in that commit,
    which is how the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
    [nexus_link.py, test_link_usb.c]
2026-09-07 Put the ankle back on its motor-side encoder
    s_cmd_scale goes { 1, 1, 1 } -> { 1, 1, 9 }. Hip and knee still read load-side
    encoders and take gait values unscaled; the ankle reads the motor side of its
    9:1, so position and velocity feedforward to it are both multiplied by nine.
    The same split in the torque file, where it matters more because the two
    tables now differ in a way that looks like a typo and is not:
    s_enc_per_out = { 1, 1, 9 } position units, follows the ENCODER
    s_gear = { 47, 47, 9 } torque, follows the GEARBOX
    The knee is the pair worth reading twice - encoder scale 1, gear 47. Using one
    table for the other's job commands 47x too much torque or 47x too fa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
    [test_leg_can.c, test_leg_torque.c]
2026-09-07 Run the hip off its onboard encoder too, and read the encoder source over CAN
    s_cmd_scale goes { 1, 1, 9 } -> { 47, 1, 9 }. Only the knee still reads a
    load-side encoder; hip and ankle read the motor side of their 47:1 and 9:1, so
    position and velocity feedforward to them are scaled by that ratio. Same split
    in the torque file's s_enc_per_out, where s_gear stays { 47, 47, 9 } because
    torque crosses the reduction whatever the encoder is doing.
    Adds the SDO read and write for axis0.config.load_encoder (294) and
    axis0.config.commutation_encoder (295), and prints both for every drive at
    boot beside the cmd_scale that assumes them:
    hip_pitch load=1 commutation=1 [left alone] cmd_scale 47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
2026-09-07 Calibrate hip pitch at boot, and put its scale back to 47
    Three settings that only make sense together, all for the same joint:
    s_cmd_scale[0] 1 -> 47 it reads its onboard encoder now
    LEGTEST_CALIBRATE_JOINTS {-1} -> {0} run FULL_CALIBRATION_SEQUENCE first
    LEGTEST_ENABLE_CLOSED_LOOP 0 -> 1 otherwise nothing arms or moves
    The scale had been reverted to 1.0 in the working copy while the drive was
    being switched to its onboard encoder. Those two disagreeing is a 47x error in
    the quiet direction: a 13.8 degree gait swing becomes 0.3 degrees and the joint
    looks dead rather than misconfigured.
    Calibration runs from legtest_init, before the timers start, so it is finish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
    [test_leg_can.c]
2026-09-08 Repair the mid-stride discontinuity, and stop the generator deleting its own file's code
    The trajectory is two half-strides concatenated and they do not meet. Every
    joint jumps at once at t = cycle/2, sample 99 -> 100, by 1.7 to 2.0 degrees
    where neighbouring steps are 0.03. On the knee, whose whole travel is 3.7
    degrees, that step was 44% of the gait - a kick no gain setting follows, and
    the reason its captures read 230% tracking while it was really just ringing.
    The wrap seam was already handled by tilting the whole path, which is the right
    tool for a constant offset spread over a cycle. It cannot help mid-table, so
    the join is closed locally instead: each side pulled halfway to the other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
2026-09-08 Scale velocity feedforward per joint, and record what the tuning campaign found
    The same feedforward is right for one joint and roughly double what another can
    use. Measured at GAIT_SPEED 1.0 by running the identical gait with it on and
    off:
    RMS with 1.0 RMS with 0.0
    hip_pitch 0.13 deg 1.53 deg needs all of it
    knee 0.58 0.46 slightly better without
    ankle 1.88 0.26 7x better without
    The hip lags visibly without it; the ankle overshoots 22% and arrives early
    with it. s_vel_ff[] scales it per joint - { 1.0, 0.5, 0.0 } - and
    LEGTEST_GAIT_VEL_FF stays as the master switch.
    This cost four rounds of gain tun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
    [test_leg_can.c]
2026-09-09 Run the human gait: absolute trajectory, a zero defined over CAN, and a return to it
    New trajectory. final_humangait.xlsx is two steps over 1.26 s at three speeds,
    one sheet each - 0.3, 0.4, 0.5 m/s - and names its columns through the shared
    string table rather than inline, which the original reader could not decode.
    gen_gait_sheet_select.py parses the workbook relationships to map sheet names
    to XML parts, lists what it found, and takes --sheet. gait_ref.c is built from
    the 0.4 m/s sheet.
    Two steps per table rather than one stride means phase 0..1 now covers two
    steps, so gait_sample(phase + 0.5) is the same leg one step later - which is
    what build_reference() wants for the contralateral l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
    [final_humangait.xlsx]
2026-09-09 Clear the errors and bring the leg home when any drive faults
    A drive that latches a fault used to just stop answering setpoints while the
    other two carried on servoing to the trajectory. Those three are bolted to the
    same limb, so that bends the leg against itself.
    Any live joint reporting a non-zero axis_error in its heartbeat now ends the
    run for the whole leg: the gait is abandoned where it is, every axis is idled,
    Clear_Errors (0x018) goes to each drive that had an error, and the existing
    return-to-zero brings the leg home before disarming.
    The clear has to happen before the return, not after. The return-to-zero re-arm
    already refuses any axis whose axis_error is non-zero - without cl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
    [test_leg_can.c]
2026-09-10 Drive to the saved zero instead of declaring it, and run the gait as phases
    Hip and knee now read load-side absolute encoders whose reference frame is
    saved in the drive: pos_vel_mapper.config.offset with offset_valid, written by
    set_abs_pos() and persisted by save_configuration(). The drive applies that
    offset at power-up, so pos_estimate is already correct before the firmware says
    anything, with no homing.
    So the firmware must NOT send Set_Absolute_Position to those two. That command
    redefines zero as wherever the leg happens to be standing, which would silently
    replace a calibrated reference with an arbitrary one. s_define_zero goes from
    { 1, 1, 0 } to { 0, 0, 1 } - the ankle only, becau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
    [test_leg_can.c]
2026-09-10 Name the fault, clear it, bring the leg home
    Any live joint reporting a non-zero axis_error now ends the run for the whole
    leg, checked before anything computes a target so a faulted drive is never sent
    one more setpoint on its way down:
    !! DRIVE FAULT - stopping the leg
    knee (node 3), axis_error 0x08000200, state 1:
    DC_BUS_UNDER_VOLTAGE
    BRAKE_RESISTOR_DISARMED
    clearing errors on knee
    The names come from the ODriveError bitmask in the 0.6.12 API refe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
    [test_leg_can.c]
2026-09-10 Let the knee's trajectory fit, and stop warning about a correct encoder setup
    The run refused to arm:
    !! knee: gait clears its stop by only 1.1 deg, want 3.0.
    !! trajectory does not fit the joint limits - NOT MOVING
    A walking knee only ever flexes. This trajectory runs +16.34 to +28.85 degrees
    and never goes negative, so the symmetric +/-30 spent its whole negative half on
    travel the joint never uses and left 1.15 degrees on the side that matters -
    under the 3 degrees limits_ok() wants before arming. 35 is the knee's mechanical
    travel from docs/ZEROING.md and gives 6.15 degrees of real margin. Lowering
    LEGTEST_LIMIT_MARGIN_DEG instead would have removed the warning without removing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
    [test_leg_can.c]
2026-09-10 Cap velocity and current in the drives, so a stalled load cannot run the motor away
    A load-side encoder puts the gearbox inside the control loop, which brings a
    failure mode a motor-side encoder does not have. If the load stops responding -
    a mechanical stop, stiction, a slipped encoder - the loop cannot see that the
    motor is moving. The position error grows, pos_gain turns it into a large
    velocity command, and the motor accelerates into a load that still is not
    moving. Nothing in the position loop stops that by itself, and the harder it is
    tuned the faster it runs away, which is why raising the hip's gains made the
    symptom worse rather than better.
    Set_Limits (0x00F) now goes to every driv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
    [test_leg_can.c]
2026-09-10 Limit velocity only, and leave the configured current limits alone
    Set_Limits (0x00F) carries velocity and current in one frame, so using it to cap
    velocity would also overwrite whatever current limits are configured in each
    drive. Write axis0.controller.config.vel_limit over SDO instead - endpoint 396,
    one parameter, nothing else disturbed.
    s_vel_limit is per joint and in that drive's own units: output turns/s where the
    encoder is on the load side, motor turns/s where it is on the motor side. A
    negative value leaves the drive's own setting alone, which is what the ankle
    gets - hip and knee are the two with a load-side encoder and therefore the two
    with the runaway to guard against.
    Co-Aut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
2026-09-11 Flip the hip's commutation_vel_scale sign at boot
    Writes axis0.controller.config.commutation_vel_scale (endpoint 405) to the hip
    before anything else touches the drives - straight after the bus scan, well
    before arming. Magnitude unchanged, only the sign: 63cc843a -> 63cc84ba, the
    same float32 with its sign bit set.
    That scale relates the commutation encoder's velocity to the load encoder's.
    Hip and knee read position on the load side and commutate off the onboard
    motor-side encoder, and those two sit at opposite ends of a 47:1 reduction - so
    whether they agree about which way is positive depends on how each was mounted,
    and there is no reason for them to agree by default. A wrong sign feed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
    [final_humangait.xlsx]
2026-09-11 Stop imposing a velocity limit on the drives
    Removes the last limit the firmware wrote. The current limit went in the
    previous commit, once it was clear Set_Limits (0x00F) carries velocity and
    current in one frame and would have overwritten the values already configured
    on each drive; this takes out the SDO velocity write that replaced it, along
    with s_vel_limit[], LEGTEST_SET_VEL_LIMIT, EP_AXIS0_VEL_LIMIT, send_limits()
    and its three call sites.
    The drives keep whatever controller.config.vel_limit is saved in their own
    configuration. Nothing here touches it any more, on any joint, at any point.
    Worth being plain about what this gives up. The limit was there for the
    failure mode a load-sid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
    [test_leg_can.c]
2026-09-11 Set the hip's encoder error tolerance to 0.5, per joint
    spi_encoder0.config.max_error_rate was one #define written to every drive.
    The hip needs 0.5 and the others do not, so it becomes a table alongside the
    other per-joint config, with a negative value meaning "leave that drive
    alone". Monitor-only nodes keep the 0.1 default.
    What the number actually controls is when the drive gives up, not how good the
    encoder is. It is the fraction of SPI transactions allowed to come back bad
    before the estimate is declared missing and the axis disarms. At 0.1 a burst
    of corrupt reads ends the run with MISSING_ESTIMATE; at 0.5 the same burst is
    absorbed and the gait carries on - with the bad positions st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
    [test_leg_can.c]
2026-09-11 Calibrate the hip at boot and declare its zero where the leg stands
    Two changes for chasing the hip runaway, both on the hip only.
    LEGTEST_CALIBRATE_JOINTS is { 0 }, which is the hip. The list is indexed by
    position in the joint tables, not by node ID, and those do not line up - hip is
    index 0 on node 1, knee index 1 on node 3. { 1 } therefore calibrates the knee.
    The comment now says so, because the mistake is silent: the wrong joint moves
    and the one you wanted is left alone.
    s_define_zero[] gains the hip, so CAN 0x19 declares its zero at boot at
    whatever pose the leg is in. This is TEMPORARY and it is destructive: it
    overwrites the pos_vel_mapper offset saved in the drive, and putting t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
    [test_leg_can.c]
2026-09-11 Report why a routine failed instead of guessing at it
    A boot log with "calibration TIMED OUT (state 1)" and two zeroing failures had
    almost nothing in it to act on, because four separate things were reporting
    badly. All four are fixed here; none of them change what the firmware asks the
    drives to do.
    procedure_result. Heartbeat byte 5 was parsed and thrown away. It is the field
    a REFUSED state request sets - axis_error stays 0, which is exactly the state
    the log was in: a calibration that never started and no error to show for it.
    It is now kept, decoded by name, and printed whenever calibration refuses,
    fails or times out.
    Calibration timeout. FULL_CALIBRATION_SEQUENCE is motor calibratio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
    [test_leg_can.c]
2026-09-11 Stop calling a running calibration refused, and never zero a moving axis
    The "calibration REFUSED - procedure_result 1 (BUSY)" in the last boot log was
    wrong, and it caused the two failures underneath it.
    FULL_CALIBRATION_SEQUENCE is a request, not a state to watch for. The axis
    reports the sub-routine it is actually running - MOTOR_CALIBRATION (4), then
    ENCODER_OFFSET_CALIBRATION (7) - and may never report 3 at all. The wait
    watched for 3, so it never saw the start, and gave up at the 1.5 s mark on a
    calibration that was running perfectly well. The log proves it was: node 1
    reported state=7 for the next four seconds and returned to IDLE at t=6s.
    BUSY meant busy. Started is now "anything th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
    [test_leg_can.c]
2026-09-11 Put the hip back on its onboard encoder until the SPI one is repaired
    The hip's load-side SPI encoder is not usable. With the drive IDLE and
    unpowered its reported position wandered over 24 degrees peak to peak while
    reported velocity stayed at zero - position jumping, not a joint moving. The
    knee, on an identical load=5 / commutation=13 configuration on the same bus,
    held to 0.036 degrees over the same window, so this is the hip's encoder and
    not the bus, the firmware or the parsing. FULL_CALIBRATION_SEQUENCE on that
    axis then returned NOT_CONVERGING, which is what encoder offset calibration
    does when it cannot get a consistent relationship between the two encoders.
    That is a complete expl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
2026-09-11 Judge the zeroing in joint degrees, not encoder turns
    The hip zeroed correctly on its onboard encoder and was failed anyway, because
    the two thresholds were in encoder turns and encoder turns scale with
    s_cmd_scale. 0.002 turns is 0.72 deg at the knee's 1:1 and 0.015 deg at the
    hip's 47:1, so one constant meant two different things and the hip was being
    held fifty times tighter than the joint it was measuring. It reported
    -0.067306 turns, which is -0.52 deg at the joint - well inside any sane
    tolerance, and the drift that came with it was 0.24 deg in 200 ms, a leg
    settling rather than an encoder inventing numbers.
    Both thresholds are now in degrees at the joint and converted per joint: 1.0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
    [test_leg_can.c]
2026-09-12 Put hip and knee back on their load encoders and their saved zeros
    Reverts the configuration to where it was at 6002102, four commits back:
    s_cmd_scale 47, 1, 9 -> 1, 1, 9
    s_enc_src[hip] ONBOARD0 -> left alone (drive keeps SPI_ENCODER0)
    hip gains 20/1.0/5.0 -> 20/5.0/8.0, the load-side tune
    s_define_zero 1, 0, 1 -> 0, 0, 1
    So hip and knee read their load-side absolute encoders and keep the reference
    frame saved in their drives, the ankle reads the motor side of its 9:1 and has
    its zero declared at boot, and no joint calibrates.
    The diagnostics from the last four commits stay. They are orthogonal to the
    configuration and every one of them was written because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
    [test_leg_can.c]
2026-09-12 Capture the gait whatever is plugged in, and say so when nothing was
    A run with only the ankle connected played the gait correctly and printed no
    trajectory log at all. Two things combined to make that silent.
    The capture condition named s_joint[0] - the hip - by index. With the hip
    unplugged its axis_state never becomes CLOSED_LOOP, so the condition was never
    true and not one sample was recorded, no matter which joints were actually
    running. It now records while ANY live joint is in closed loop. Which joints
    are on the bus is a property of the bench, not of the code, and nothing in the
    capture path should be tied to one of them by index.
    cap_dump() then returned without printing anything,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
    [test_leg_can.c]
2026-09-14 Hold the trajectory's start pose for 5 s before the gait
    Adds RUN_HOLD_START between RUN_ENTRY and RUN_GAIT. Once the entry ramp has
    brought the joints onto the trajectory's first sample, they are held there at
    zero velocity for LEGTEST_HOLD_START_MS (5000 ms) before the gait starts.
    Starting the gait the instant the ramp finished blended the tail of the ramp,
    with the joints still settling, into the first stride. The hold separates the
    two and gives a few seconds to look at the leg on its start pose.
    What the hold does not do, stated in the comments rather than implied: the
    hard stop judges the command, which is constant and inside the limits here,
    so a joint that sags off the pose will n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
    [test_leg_can.c]
2026-09-14 Confirm the joint map and define it once, for both sides of the link
    The robot's actuators are:
    idx bus node joint idx bus node joint
    0 0 1 left_hip_pitch 5 1 1 right_hip_pitch
    1 0 2 left_hip_roll 6 1 2 right_hip_roll
    2 0 3 left_knee_pitch 7 1 3 right_knee_pitch
    3 0 4 left_ankle_pitch 8 1 4 right_ankle_pitch
    4 0 5 waist_roll 9 1 5 waist_pitch
    with index = bus * 5 + (node - 1). It is now defined once in C, as
    NEXUS_J_* in link_proto.h, and once in Python, as JOINT_NAMES in
    pi/nexus_proto.py. tools/check_proto.py compiles the macros and fails if any
    of the ten disagrees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
    [app.c, link_proto.h, nexus_proto.py, robot_config.c]
2026-09-14 Commit the bench state: human-gait table and the leg test as last run
    Everything that was sitting uncommitted on the bench machine, pushed so the
    work can continue on another computer.
    gait_ref.c / gait_ref.h
    The table regenerated from final_humangait.xlsx (0.3 m/s sheet): 200 samples
    over a 1.26 s cycle, 158.7 Hz. Replaces the 0.8 s reference_gait table.
    Column order is unchanged, so GAIT_COL_* still pick the same joints.
    test_leg_can.c, as it was last flashed:
    LEGTEST_ENABLE_CLOSED_LOOP 1 THE MOTORS ARM. A board flashed from this
    commit in LEG_CAN mode drives the leg.
    hip commutation_vel_scale +0.00101317 - the drive's own value, so th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
    [reference_gait_rleg_40ms_250hz.xlsx]
2026-09-15 Let a restarted Pi re-arm the board without rebooting it
    safety.c refuses an enabled command whose seq does not advance past the last
    accepted one. That baseline was only ever reset by safety_init(), which means
    by rebooting the STM32. The Pi's link node starts its counter from 0 every time
    it starts, so after any Pi-side restart:
    enabled commands read as stale -> 10 rejections -> FAULT
    -> the enable-off handshake clears it -> enabled commands stale again -> ...
    and the robot cannot be re-armed until the STM32 is power-cycled. Found while
    running the Pi stack on Linux against a fake board that models this firmware;
    reproduced here in a host test before changing anything:
    a restarted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
    [safety.c, test_safety.c]
2026-09-15 README: build instructions that select the mode they say they do
    The documented way to choose a mode was
    NEXUS_MODE=NEXUS_MODE_LEG_CAN cmake --preset Debug
    cmake --build build/Debug
    and it does not work. Tested on Linux: the Appli is an ExternalProject, which
    configures during `cmake --build`, so a variable set only on the configure
    command never reaches it - the build prints "Nexus mode: from
    Appli/App/nexus_mode.h" and uses the header. The README also said "either
    preset builds the robot loop by default", which stopped being true when the
    header became the source of the mode; it currently says NEXUS_MODE_LEG_CAN,
    whose leg test has closed loop enabled. Following the old instructi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
2026-09-15 Stream the leg test to the Pi over USB, and document testing the link
    The single-leg test never sent anything on the USB user port. The port
    enumerated in every mode, but only robot mode called link_usb_send_state(), so
    on the bench the cable to the Pi could not be tested and a run could only be
    watched by printing a CSV to the ST-LINK console and plotting it afterwards.
    The leg test now sends the robot's own 444-byte state packet at 1 kHz
    (LEGTEST_USB_STREAM, on by default). Everything on the Pi side works unchanged:
    link_check, link_node, /zeus/state, Rerun.
    leg_stream.c packs it, as a pure function so it can be tested:
    - each drive at its joint-map index: the bench leg is on FDCAN1, b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
2026-09-16 Generate the leg kinematics from the URDF
    kinematics.c is written around four hand-measured lengths that have never
    been measured. zeus_kinematics.c instead walks tables that
    tools/gen_kinematics.py writes from zeus_26's zeus.urdf (itself made from the
    Fusion 360 export): the path from imu_link to each toe and heel, with every
    rigid part between two joints folded into one constant transform.
    It gives both contact points of a leg in the IMU frame and their exact 3x8
    Jacobians (hip pitch, hip roll, knee, ankle, the two spring deflections, and
    the waist pitch and roll that move the IMU relative to the legs). About 2 KB
    of flash; the ARM build is warning-free.
    CasADi code generation was tried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
2026-09-16 Regenerate the kinematics model for the +/-45 degree limits
    zeus.urdf changed (joint limits only), so the model hash in
    zeus_kinematics_model.h changed with it. The geometry tables are
    numerically identical. The Pinocchio reference poses are now drawn from
    inside the new limits: worst error 2.0e-7 m, 1.9e-7 m/rad.
2026-09-16 Read the spring encoders as two AS5047P chains, one per leg
    The spring encoders are AS5047P, not AS5048A, and they are wired as two
    daisy chains, one per leg, each on its own chip select:
    PF1 enc_cs_left left hip + left knee
    PD14 enc_cs_right right hip + right knee (Arduino D10 on the Nucleo)
    Both chains share SPI1 and run MOSI -> hip -> knee -> MISO. Each tick
    reads the left chain, then starts the right one from the left chain's
    completion callback. The mask is published only once both chains are
    done, and a right chain that will not start still keeps the left
    readings.
    spring_angle[] now has a defined order: L hip, L knee, R hip, R knee
    (NEXUS_ENC_* in link_proto.h, SPRING_NAMES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
2026-09-16 Estimate from the URDF kinematics: springs, waist, toe and heel
    fusion.c now calls zeus_kinematics instead of the hand-written kinematics.c,
    which is deleted with its placeholder lengths.
    - Each leg's chain is 8 joints: its 4 drives, both waist drives (they move
    the IMU relative to the legs), and the hip and knee spring deflections,
    ADDED to their drives. The drives measure before the spring and the
    AS5047Ps measure only the spring, so the link angle is the sum. The
    previous code ignored the springs entirely.
    - A spring encoder that is invalid, or reads beyond
    ROBOT_SPRING_MAX_DEFLECTION_RAD (an unmeasured zero looks like that),
    is treated as unknown: 0 with a wide variance.
    - E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
2026-09-16 Test the estimator against a simulated walk with exact ground truth
    tools/sim/ does the following:
    - builds a kinematic walk from zeus.urdf: the stance foot is fixed to the
    world, and the torso moves however the joint angles make it;
    - writes what the IMU, drives, spring encoders and switches would have
    reported;
    - runs the real fusion.c/inekf.c/zeus_kinematics.c on it through replay.c;
    - compares the result with the truth.
    The walk includes:
    - heel strike and toe-off (the switches go heel, both, toe);
    - stance-leg spring wind-up, hip-roll sway and waist motion;
    - 400 Hz IMU samples with noise and constant biases;
    - drives reporting at 500 Hz.
    16 steps, 3.9 m:
    - tilt 0.24 deg rms;
    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
2026-09-20 Two legs, no waist: eight actuators and protocol v7
    TEMPORARY BUILD, not the final robot. The two legs are being brought up
    without the waist, so this drops the two waist actuators everywhere and
    bolts the waist at its zero pose. The tag waist-10-actuators marks the
    last commit with ten; link_proto.h lists what to change to put them back.
    - NEXUS_NUM_JOINTS 10 -> 8, index = bus * 4 + (node - 1), so the right
    leg moves from indices 5..8 to 4..7 and NEXUS_J_WAIST_* are gone.
    - ODRV_NODES_PER_BUS 5 -> 4: node 5 on each bus is neither commanded nor
    expected, and a frame from it is ignored rather than counted as a live
    drive.
    - Wire format v7: state 444 -> 400 bytes, command 52 -> 44, poli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
2026-09-20 Report what each drive was told, and take gains from the Pi
    NOT THE FINAL ROBOT - still the two-leg bring-up build.
    Tuning a drive means comparing what it was told with where it went, and
    the board was only reporting half of that. Protocol v8 adds both halves
    of the loop:
    - act_target[]: the interpolated target act_odrive actually put on the
    wire, in rad on the output side, after the reference, the residual, the
    safety envelope and the slew limit. NaN while nothing is being driven,
    so a plot gaps instead of showing a flat line that reads as a command
    the joint is ignoring. ref_angle + residual is what the Pi asked for;
    this is what the joint got.
    - NEXUS_MSG_GAINS, a third messag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
2026-09-26 Two reasons the USB link never enumerated, and a way to see them
    The user port had never worked. From the host it was indistinguishable from a
    dead cable - no enumeration, empty dmesg - so the search went to cables, ports
    and hosts, all of which were fine. There were two faults, stacked, and the
    first completely masked the second.
    VDD33USB is supplied externally on MB1737, from the board's own 3V3 rail, with
    VDD33USB and VDD50USB tied together. That case requires USBREGEN CLEARED. We
    were setting it, as CubeMX and every ST example do, so the internal regulator
    sat there trying to make 3.3 V out of 3.3 V, never reached threshold, and the
    transceiver had no power at all. PWR_CSR2.USB33RDY sta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
2026-09-26 link_usb_diag: keep it out of the host build
    The host suite links link_usb.c to test framing and CRC, and there is no HAL
    there - so PWR, HAL_Delay and the OTG register map are all undeclared and the
    build failed under both compilers. Caught by CI, not locally, because the
    target build has all of them.
    The diagnostic reads hardware directly and has nothing to say on a machine with
    no board attached, so the host gets an empty one.
    [link_usb.c]
2026-09-26 The console no longer costs the control loop its ticks
    printf went to the ST-LINK port through the BSP, which hands each character to
    HAL_UART_Transmit and waits for it to leave - 87 us a byte at 115200. The
    once-a-second status block is about 350 characters, so every second the 1 kHz
    loop stopped for roughly 30 ms.
    That is not a delay, it is 30 lost ticks, and the loop could not see it happen:
    a missed tick sets a flag that is already set, and after report() the pending
    flag is explicitly cleared, so the ticks were discarded rather than counted.
    Measured from the Pi over 60 s and again over 5 minutes, before this change:
    board tick 971.7 Hz (28 ticks/s missing)
    delivered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
    [console.c, console.h, main.c]
2026-09-28 One foot switch per foot: protocol v9, and a smaller filter
    Each foot had two mechanical switches, toe and heel. There is one now, at the
    centre of the sole, and the board can no longer say which part of the foot is
    loaded - only whether that foot is taking weight.
    The centre is where it has to be. That point is what the InEKF anchors to
    while the foot is planted, and either edge of the sole is a position the robot
    genuinely stands on for only part of the stride, so anchoring there would bias
    the estimate towards the phase when that end is down. The new contact frame is
    the midpoint of the old toe and heel.
    link_proto.h NEXUS_NUM_CONTACTS 4 -> 2, and the four switch names become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
    [app.c, contact.c, contact.h, fusion.c, lie_group.h]
2026-09-28 sim: the start pose rests on the sole, not on a frame that is gone
    The initial torso height was set by putting left_toe on z = 0. That frame went
    with the second switch, so the simulation died at startup with KeyError before
    generating a single sample.
    The foot is flat at the start pose, so the sole's contact point sits at the
    same height the toe did: resting it on z = 0 puts the foot on the ground
    exactly as before, and the generated walk is unchanged.
    Caught by CI rather than here, because the walk simulation needs Pinocchio and
    its current wheels will not import on this machine - eigenpy's binary is built
    against a numpy whose ABI no longer matches. Every frame the simulator asks
    for is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
2026-09-30 Six joint angles per leg: the new model has no waist
    The CAD export in zeus_26 bolts both hips straight to the torso. The previous
    one still carried two waist joints that nothing drove, and the estimator kept
    them in each leg's chain - held at zero with a small variance - because the IMU
    sat above them. Nothing sits between the IMU and the legs now, so they are gone
    rather than pinned:
    ZEUS_KIN_NQ 8 -> 6. The Jacobian is 3x6, and every per-joint loop in
    fusion.c and the generated tables shrinks with it.
    fusion.c The block that held both waist angles at zero, and
    NOISE_WAIST_BOLTED_RAD with it, has nothing left to hold.
    gen_kinematics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
    [fusion.c, fusion.h, link_proto.h, nexus_proto.py, robot_config.h]
2026-09-30 The kinematics reference is Pinocchio's again
    Pinocchio does install - at pin==2.7.0 with numpy<2. Every 3.x and 4.x wheel
    dies on import with
    undefined symbol: EIGENPY_ARRAY_APIPyArray_RUNTIME_VERSION
    which is a broken macro expansion in the eigenpy they bundle, and pinning numpy
    alone does not help because cmeel-boost then demands numpy >= 2.3 straight back.
    requirements-kinematics.txt now pins both, with the reasoning, because the next
    person will otherwise conclude what I did - that it cannot be installed at all.
    So the reference header is regenerated by Pinocchio rather than by this script's
    own URDF walk, and the banner says so again.
    What the comparison showed, both files buil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
2026-10-07 Spring encoders: a chip select each, not two daisy chains
    Four AS5047P now share SPI1 with one chip select per sensor. They were two
    daisy chains of two, one per leg.
    The reason is that a chain makes the ORDER of the returned words carry meaning:
    the sensors are one long shift register, so the first word back came from
    whichever sensor sat nearest MISO. Wire a leg's hip and knee the other way
    round and its two springs swapped in the data - silently, with no error flag
    and no parity failure, because both words were perfectly valid. The only way
    to catch it was to press a spring by hand and watch which number moved. With
    one select per sensor a reply can only have come from the sensor that wa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
    [enc_as5047p.c, enc_as5047p.h, link_proto.h, main.c, main.h, nexus_first.ioc, nexus_proto.py, test_enc_as5047p.c]
2026-10-07 docs: what zeus_26 still needs, for when it is being touched again
    The workspace is being left alone until the policy lands, so the two stale
    encoder comments it carries have nowhere to go yet. They are written down here
    with their diffs rather than held in anyone's head.
    Both are comments. The wire protocol did not change for the encoder rewiring -
    no field, no size, no version - so a board on the new firmware talks to today's
    workspace without complaint. Nothing here is blocking.
2026-10-07 IMU moves to USART2 on PD5/PD6, off PA9/PA10
    PA9 is not a free pin on this board. UM3276 Table 9 has it carrying I2C_SDA to
    the TCPP03-M20 USB-C port controller, with solder bridge SB35 closed by
    default, so the IMU's 3 Mbaud transmit line was sharing a net with a device
    that was never meant to see it. PA8, which imu_bno085.c suggested for the reset
    line, is the matching I2C_SCL through SB31 - that comment now says so rather
    than calling the pin free.
    The IMU is now on USART2: PD5 transmit, PD6 receive. Both are free, and the
    board's own pinout table names them - they are the Arduino serial pair
    USART_B, D53 and D52, on CN9 pins 6 and 4. Adjacent on one connector, which
    PA9/PA10 were not.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
    [imu_bno085.c, imu_bno085.h, main.c, nexus_first.ioc, test_imu.c, test_imu.h]
2026-10-08 docs: one pinout for every wire into the STM32
    The wiring was spread across three driver headers, two README sections and a
    conversation. docs/PINOUT.md collects it: CAN, encoders, IMU, foot switches,
    supply rails, with the Nucleo header position for every signal so it can be
    read at the soldering iron rather than cross-referenced against UM3276.
    It carries the traps too, which is most of why it is worth having:
    - the AS5047P adapter's "3V3" pin is the internal regulator's OUTPUT, not a
    supply input. Wiring 5 V to it back-feeds the regulator and lifts the
    digital I/O to 5 V, which PB4 is not guaranteed to survive. The silkscreen
    gives no hint.
    - the magnet spec - 0.5 mm cen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
2026-10-13 CAN at 2.5 Mbit, FD enabled, and one SSP that was quietly wrong
    Classic 2.0 cannot carry this robot. Eight drives, four to a bus, at 1 kHz
    Set_Input_Pos and 1 kHz encoder estimates is 8800 frames a second per bus; a
    classic 8-byte frame is 120 us on the wire, so the bus is at 106% and the
    traffic simply does not fit. The single-leg tests fitted because three joints is
    three quarters of that. So ODRV_USE_FD goes to 1.
    The data rate is 2.5 Mbit rather than 2 or 4 because of where the sample point
    lands. The S1 samples at 87.5%, and matching it is what fixed the error
    counters before. This peripheral's DataTimeSeg1 tops out at 32:
    2 Mbit 40 tq 87.5% would need Seg1 = 34 -> unreacha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
2026-10-30 Protocol v10 and a tenth joint: the estimator measures the policy's robot
    The policy was trained on a ten-joint robot - five a leg, ankle roll taking
    the CAN node 5 that the deleted waist used to have - and this firmware was
    still built for eight. A board and a workspace at different protocol versions
    refuse to talk, so none of it could be brought up piecemeal.
    Protocol v10 comes from the handoff's own patch, verified field-for-field by
    check_proto.py: state 478 B, command 52 B, gains 130 B, policy block 50
    float32, joint index bus * 5 + (node - 1).
    The estimator now measures the same robot the network did. The kinematics
    model is regenerated from mukesh_description/urdf/mukesh.urdf rather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
2026-10-31 The policy's gait, its spring, and commands at the rate it was trained at
    Four changes that all come from reading the policy's own training environment
    rather than the handoff's description of it.
    THE GAIT TABLE is the policy's, copied from firmware_handoff/. Five columns
    with ankle roll, stride 1.5646 s rather than 1.26, and three tables instead of
    one: position, velocity and the torque the optimiser solved for. That torque
    row is what item 3's feedforward will read, so it did not have to be derived.
    gait_sample_vel() stays as a thin forward to gait_sample_all() because the
    single-leg bench test still calls it and that file is the user's.
    build_reference() gains its ankle roll row, and BO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
2026-10-31 Every document now describes the ten-joint robot and the live workspace
    zeus_26 is retired; zeus_26_mukesh_deploy is the Pi workspace, carries the RL
    policy and owns the URDF the kinematics are generated from. The docs still
    described the eight-actuator robot talking to the old repo.
    AGENTS.md repoints at the new workspace and says plainly that zeus_26 is
    retired and that any surviving reference to it is a bug - it was sending an
    agent to read an orientation document for a robot that no longer exists. It
    also records that the workspace's nexus_proto.py is CANONICAL now and
    pi/nexus_proto.py is copied from it, which is the opposite of what it said.
    PINOUT.md, the soldering reference, had th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
2026-10-31 CI was checking the tables against the wrong robot's URDF
    The kinematics are generated from the Pi workspace's mukesh.urdf now, but CI
    still cloned vismay5559/zeus_26 and compared against zeus.urdf. It did exactly
    what it was built to do and failed the push - the tables and that URDF are
    different robots.
    Pointing it at the new workspace is not a one-line change, because
    zeus_26_mukesh_deploy is PRIVATE and this repo is PUBLIC, so the workflow
    cannot clone it without a secret. Committing the URDF here instead would
    publish someone else's private model, so it is not done.
    The check is therefore in two halves, and the half that needs nothing external
    is the one that always runs:
    1. the ge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
2026-10-31 Item 3: the drives get the gait's torque and velocity, not zero and a guess
    Those two bytes of Set_Input_Pos were hardcoded to 0. A drive with no torque
    feedforward has to manufacture the whole gait torque out of position error, so
    the limb lags, the lag compounds across the stride, and the trained policy
    falls at 1.5 s in simulation. Between 0.8x and 1.3x of the optimiser's torque
    it survives the full 20 s; at 0.5x it falls at 6.8 s. The scale has to be about
    right, which is why the units below are not a detail.
    Three changes, one per thing training did that the board did not:
    TORQUE. act_set_feedforward() takes the gait's torque in OUTPUT Nm and the
    driver divides by g_joint_gear before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
2026-10-31 gen_walk: the model it reads is mukesh.urdf now
    The docstring still named zeus.urdf and a venv path that no longer exists.
    Both are what someone would type from reading it.
2026-10-31 HANDOFF.md: where this actually stands, for whoever picks it up next
    AGENTS.md is deliberately the conventions and the traps, and says nothing about
    state - so an agent reading it cold learns how to build the firmware without
    learning that it has never been flashed in this configuration, that the build
    is still the single-leg bench test, or that the estimator refuses to report OK
    because nothing has been calibrated.
    HANDOFF.md is that state: the seven handoff items and which are done, the three
    things that block the first walk, the gains conversion with the one open
    question about encoder placement, the eight quantities still unmeasured and
    what each one costs, and a next-steps order that p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
2026-10-31 The model drift check does not need CI, and could not have had it
    I told the user to create a fine-grained PAT with the workspace's owner as the
    resource owner. That cannot be done. Fine-grained tokens only reach
    repositories owned by your own account or an organisation you belong to, and
    the workspace is a private repo owned by another PERSONAL account - it will
    never appear in that list however you are added to it. A GitHub limitation, not
    a permissions problem, and the docs here said otherwise.
    tools/model/check_drift.sh does the check where the credential already exists:
    a machine with both clones. It compares all four hashes - the workspace's URDF,
    the vendored copy, the pin beside it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
2026-11-05 Back to eight joints: the ten-joint work reverted, the hardware facts kept
    The robot went back to the eight-actuator design, so protocol v10, ankle roll,
    the policy's gait and its feedforward all come out. The DOF-dependent files are
    restored wholesale from 14953f5 rather than unpicked by hand, because every
    per-joint array, every host-test fixture and both ends of check_proto.py are
    sized by the joint count and hand-reverting ten of them is how one gets missed.
    Back to: protocol v9, 426/44/106 bytes, eight joints at bus * 4 + (node - 1),
    the four-column gait at a 1.26 s stride, ZEUS_KIN_NQ 6 with no ankle roll,
    ROBOT_LEG_MOTORS 4, ODRV_NODES_PER_BUS 4, Set_Input_Pos every tick again, and
    T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
2026-11-05 gitignore: side-by-side bench build directories
    Bring-up needs a binary built with a narrowed health mask and the loop stats
    printf compiled in, and that binary must not become the committed one - a
    board flashed with a narrowed failsafe is a failsafe that is not watching.
    Building it into Appli/build-bench/ keeps it beside the real build rather than
    replacing it, so there is nothing to remember to undo.
2026-11-05 pi/bench_monitor.py: every CAN and IMU value on one screen, no ROS, no Pi
    Bringing up two CAN buses from a laptop has an awkward gap: the laptop has no
    CAN interface, so it cannot look at the bus at all - only the STM32 can. But
    the board already puts every value it reads over CAN into the state packet it
    sends on USB, so plugging the board's DATA port into the laptop instead of the
    Pi gets all of it with nothing else running.
    One screen, refreshing: per actuator its bus and node, position, velocity,
    torque, ODrive axis state by name, whether a heartbeat and encoder telemetry
    arrived recently, and any error decoded to names rather than a hex mask. Then
    the IMU's accel, gyro and quaternion w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
2026-11-06 The 8-DOF policy's gait and feedforward: z1_softland_tol05
    zeus_8dof_deploy ships a policy trained for THIS robot and, by its own
    account, no firmware for it: no gait_ref.c, no FIRMWARE_CHANGES, and a
    zeus_link still hardcoded to the ten-joint v10 it inherited from Mukesh. The
    good news is that almost nothing needed changing. zeus_env.py's observation is
    "exactly what rl_policy_node gets from the board, 44 raw SI values, same
    order" with NJ 8 - which is this firmware's v9 policy block, unaltered - and
    every constant it trains against is one this repo already holds:
    joint order hip_pitch, hip_roll, knee_pitch, ankle_pitch, L then R
    spring order L hip, L knee, R hip, R knee, commented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
2026-11-07 A real command envelope, derived from what the policy can actually ask
    SAFETY_POS_MIN/MAX_TURNS was a pair of scalars at +/-10 turns, and its own
    comment admitted what they were: "deliberately loose bounds chosen to catch
    garbage, NOT to describe this robot's real joint travel", to be set "before
    anything walks". At 10 turns they were about SEVENTY TIMES wider than anything
    z1_softland_tol05 can command, so a diverged policy had a very long way to run
    before the board objected.
    g_joint_limit is per joint and derived rather than guessed: the gait's own reach
    over the stride, plus act_scale (the largest residual the network can emit,
    0.25 rad on hip pitch and knee, 0.12 on hip roll, 0.15 on t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
2026-11-07 AGENTS.md stands on its own now, because the repo it deferred to is gone
    It opened by sending the reader to zeus_26/AGENTS.md as "the full orientation
    document... read that first", and zeus_26 is retired. So an agent starting here
    was pointed at a description of a robot this project no longer builds, and the
    rest of the file was written on the assumption that the real explanation lived
    somewhere else.
    It is self-contained now: the robot, the Pi side, the link, what the board sends
    the drives, the repo map, build and flash, the generated files, the five traps,
    and the conventions. HANDOFF.md stays separate and carries the state, so this
    file can remain true while that one moves.
    What was al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
2026-11-10 Two read-only bring-up modes, and the IMU's last PA9 reference
    Written by the user with Codex; committed here after verifying both build and
    that the normal ROBOT build is unaffected.
    NEXUS_MODE_CAN_SCAN and NEXUS_MODE_ENC_SCAN join the mode list. Both are
    receive-only: no drive commands, nothing can move. That is the point - the
    existing LEG_CAN mode drives a canned trajectory, which is not what you want
    when the question is "is this harness right", and IMU mode does not touch SPI
    or CAN at all.
    THE IMU FIX IS SMALL AND REAL. imu_bno085.c still had a GPIO init pointing at
    PA9/GPIOA, left over from when the IMU lived on USART1. It is PD5/GPIOD now.
    PA9 is not a free pin on this board: it c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
2026-11-10 A net probe for the SPI bus, and the two ways I got it wrong first
    The encoder scan could say "nothing answered" but not why. This drives one bus
    signal at a time and reads MISO, so a short announces itself without opening
    the robot - which matters when the sensors are inside it.
    It took three versions, and the two failures are written into the comments
    because both produced confident answers about the wrong thing:
    THE PULL DIRECTION. The first version tested for bridges with MISO pulled
    DOWN and the other pin driven HIGH. A chip select idles high and asserts
    LOW, so the bridge that matters drags MISO down - and pulled down, MISO
    reads 0 whether or not there is a bridge. It printed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
2026-11-10 NEXUS_MODE_CAN_CFG: set the ODrive telemetry rates over CAN, arming nothing
    Two drives were sending at a tenth of the rest - heartbeat 100 ms and encoder
    10 ms against 10 and 1 - which the estimator cannot live with: it wants a fresh
    joint angle every tick and ACT_POS_STALE_TICKS is 100. All seven live drives
    now run encoder 1 ms, heartbeat 10 ms, torque 10 ms.
    A mode of its own rather than an addition to test_can_scan, because that one's
    value is that it CANNOT disturb the robot and it should keep that. This one
    transmits, so it says so in its name. It sends Get_Version and SDO reads and
    writes, and nothing else - there is no path in it that can command an axis
    state or a position.
    WITHOU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
2026-11-10 test_can_cfg: save the rates to flash, and prove it by the reboot
    save_configuration is what makes the rates survive a power cycle, and it is
    also the only honest proof that the right parameter was written. A read-back
    straight after a write reads RAM, which already held the value; a read-back on
    the far side of the drive's reboot can only have come from flash. So the save
    stage waits for the heartbeat to stop, waits for it to come back, and only
    then re-reads encoder/heartbeat/torque.
    It is a switch of its own, CANCFG_SAVE, because it reboots every drive it
    touches - each one drops off the bus for a while - and that is not something
    to fold into the rate write.
    The wait is 30 s because 10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
2026-11-10 The encoder diagnostic was setting the error flag it was reporting
    poll_raw_spi sent 0x0000 as its "NOP". Bit 14 of an AS5047P command frame is
    the direction bit and 1 means read, so 0x0000 is not a no-op at all - it is a
    WRITE command to address 0x0000. A write command makes the sensor treat the
    next frame as its data, so the following ANGLECOM read was swallowed as a
    payload, every reply after it was off by one, and the sensor had every reason
    to flag the exchange. The frame that does what was intended is 0xC000.
    That matters because of what EF does. The error flag LATCHES: once a frame
    goes wrong, every subsequent reply comes back with bit 14 set until somebody
    reads ERRFL, and reading i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
